UBC-Thunderbots/Electrical/README.md

# Electrical

Our repository for all things electrical! To get started, please see the [getting started document](docs/getting-started/getting-started.md).

If you are already set up, go to the [electrical system overview](docs/getting-started/board-overview.md).
