UBC-Thunderbots/Electrical/electronics/HannahSawiuk-Altium/FinalPCBandGerberfiles/Board Information - chicker.html

Altium customize

# Board Information Report

Date: | | 2018-05-23
Time: | | 10:28:25 PM
Elapsed Time: | | 00:00:00
Filename: | | C:\Users\Hannah\Desktop\Electrical\electronics\HannahSawiuk-Altium\FinalPCBandGerberfiles\chicker.PcbDoc
Units: | | mmmils

## Contents

Contents

Routing

Routing Information

Other

Net Track Width

Net Via Size

## Routing

Routing Information
Routing completion | 88.57%
Connections | 70
Connections routed | 62
Connections remaining | 8

Back to top

## Other

Net Track Width | Count
0.254mm | 18
Total | 18

Back to top

Net Via Size | Count
1.27mm | 18
Total | 18

Back to top
