UBC-Thunderbots/Electrical/controls/kinematics/Oliveira_ICINCO_2008.pdf

See discussions, stats, and author profiles for this publication at: https://www.researchgate.net/publication/256089847

# Dynamical Models for Omni-directional Robots

with 3 and 4 Wheels (https://www.researchgate.net/publication/256089847_Dynamical_Models_for_Omni-directional_Robots_with_3_and_4_Wheels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)

### Conference Paper · May 2008

CITATIONS
0

READS
549

### 4 authors:

### Some of the authors of this publication are also working on these related projects:

(Green) Chemistry and robotics View project (https://www.researchgate.net/project/Green-Chemistry-and-robotics?el=1_x_9)

Helder P. Oliveira (https://www.researchgate.net/profile/Helder_Oliveira3?el=1_x_5)
Institute for Systems and Computer Engineer… (https://www.researchgate.net/institution/Institute_for_Systems_and_Computer_Engineering_of_Porto_INESC_Porto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)

### 55 PUBLICATIONS 178 CITATIONS

SEE PROFILE (https://www.researchgate.net/profile/Helder_Oliveira3?el=1_x_7)

Armando Jorge Sousa (https://www.researchgate.net/profile/Armando_Sousa?el=1_x_5)
University of (https://www.researchgate.net/institution/Institute_for_Systems_and_Computer_Engineering_of_Porto_INESC_Porto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) Porto (https://www.researchgate.net/institution/University_of_Porto?el=1_x_6)

### 41 PUBLICATIONS 93 CITATIONS

SEE PROFILE (https://www.researchgate.net/profile/Armando_Sousa?el=1_x_7)

A. Paulo Moreira (https://www.researchgate.net/profile/A_Moreira?el=1_x_5)
University of Porto (https://www.researchgate.net/institution/University_of_Porto?el=1_x_6)

194 PUBLICATIONS 658 CITATIONS

SEE PROFILE (https://www.researchgate.net/profile/A_Moreira?el=1_x_7)

Paulo José Cerqueira Gomes da Costa (https://www.researchgate.net/profile/Paulo_Costa24?el=1_x_5) University of Porto (https://www.researchgate.net/institution/University_of_Porto?el=1_x_6)

125 PUBLICATIONS 290 CITATIONS

SEE PROFILE (https://www.researchgate.net/profile/Paulo_Costa24?el=1_x_7)

All in-text references underlined in blue are linked to publications on ResearchGate, letting you access and read them immediately.

Available from: Helder P. Oliveira Retrieved on: 05 November 2016

DYNAMICAL MODELS FOR OMNI-DIRECTIONAL ROBOTS WITH

### 3 AND 4 WHEELS

Helder P. Oliveira, Armando J. Sousa, A. Paulo Moreira and Paulo J. Costa ´
Faculdade de Engenharia, Universidade do Porto, Rua Dr. Roberto Frias s/n 4200-465, Porto, Portugal {helder.oliveira, asousa, amoreira, paco}@fe.up.pt
Keywords: | Identification, simulation, modeling and omni-directional mobile robots.
Abstract: | Omni-directional robots are becoming more and more common in recent robotic applications. They offer improved ease of maneuverability and effectiveness at the expense of increased complexity. Frequent appli- cations include but are not limited to robotic competitions and service robotics. The goal of this work is to find a precise dynamical model in order to predict the robot behavior. Models were found for two real world omni-directional robot configurations and their parameters estimated using a prototype that can have 3 or 4 wheels. Simulations and experimental runs are presented in order to validate the presented work.

### 1 INTRODUCTION

Omni-directional robots are becoming a much sought solution to mobile robotic applications. This kind of holonomic robots are interesting because they allow greater maneuverability and efficiency at the expense of some extra complexity. One of the most frequent solutions is to use some of Mecanum wheels (Diegel et al., 2002) and (Salih et al., 2006). (https://www.researchgate.net/publication/26439843_Designing_Omni-Directional_Mobile_Robot_with_Mecanum_Wheel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) A robot with 3 or more motorized wheels of this kind can have almost independent tangential, normal and angular velocities. Dynamical models for this kind of robots are not very common due to the difficulty in modeling the several internal frictions inside the wheels, making the model somewhat specific to the type of wheel being used (Williams et al., 2002). (https://www.researchgate.net/publication/3299237_Dynamic_model_with_slip_for_wheeled_omnidirectional_robots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)
Frequent mechanical configurations for omnidirectional robots are based on three and four wheels. Three wheeled systems are mechanically simpler but robots with four wheels have more acceleration with the same kind of motors. Four wheeled robots are expected to have better effective floor traction, that is, less wheel slippage – assuming that all wheels are pressed against the floor equally. Of course four wheeled robots also have a higher costs in equipment, increased energy consumption and may require some kind of suspension to distribute forces equally among the wheels.
In order to study and compare the models of the 3 and 4 wheeled robots, a single prototype was built that can have both configurations, that is, the same mechanical platform can be used with 3 wheels and then it can be disassembled and reassembled with a 4

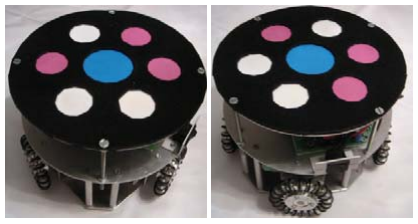
[picture p16: figure]

(a) Three wheeled robot. (b) Four wheeled robot.

Figure 1: Omni-directional robot.

wheel configuration, see figure 1.
Data from experimental runs is taken from overhead camera. The setup is taken from the heritage of the system described in (Costa et al., 2000) (https://www.researchgate.net/publication/220797747_Tracking_and_Identifying_in_Real_Time_the_Robots_of_a_F-180_Team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) that currently features 25 fps, one centimeter accuracy in position(XX and YY axis) and about 3 sexagesimal degrees of accuracy in the heading of the robot.
In order to increase the performance of robots, there were some efforts on the studying their dynamical models (Campion et al., 1996)(Conceic¸ao˜ (https://www.researchgate.net/publication/224663446_Structural_properties_and_classification_of_kinematic_and_dynamic_models_of_wheeled_mobile_robots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) et al., 2006)(Khosla, 1989)( (https://www.researchgate.net/publication/3298012_Categorization_of_Parameters_in_the_Dynamic_Robot_Model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)Tahmasebi et al., 2005)( (https://www.researchgate.net/publication/224619780_Dynamic_parameter_identification_and_analysis_of_a_PHANToM_haptic_device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)Williams et al., 2002) (https://www.researchgate.net/publication/3299237_Dynamic_model_with_slip_for_wheeled_omnidirectional_robots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) and kinematic models (Campion et al., 1996) (https://www.researchgate.net/publication/224663446_Structural_properties_and_classification_of_kinematic_and_dynamic_models_of_wheeled_mobile_robots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) (Leow et al., 2002)(Loh et al., 2003)( (https://www.researchgate.net/publication/4041513_Mechatronics_design_and_kinematic_modelling_of_a_singularityless_omni-directional_wheeled_mobile_robot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)Muir and Neuman, 1987)( (https://www.researchgate.net/publication/3979519_Kinematic_Modeling_for_Feedback_Control_of_an_Omnidirectional_Wheeled_Mobile_Robot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)Xu et al., 2005). (https://www.researchgate.net/publication/4239487_Kinematic_model_identification_of_autonomous_mobile_robot_using_dynamical_recurrent_neural_networks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) Models are based on linear and non linear dynamical systems and the estimation of parameters has been the subject of continuing research (Conceic¸ao et al., ˜ 2006)(Olsen and Petersen, 2001). (https://www.researchgate.net/publication/3299108_A_new_method_for_estimating_parameters_of_a_dynamic_robot_model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) Once the dynamical model is found, its parameters have to be estimated. The most common method for identification

189 of robot parameters are based on the Least Squares method and Instrumental Variables.
However, the systems are naturally non-linear (Julier and Uhlmann, 1997), (https://www.researchgate.net/publication/2445827_A_New_Extension_of_the_Kalman_Filter_to_Nonlinear_Systems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) the estimation of parameters is more complex and the existing methods (Ghaharamani and Roweis, 1999)( (https://www.researchgate.net/publication/2491202_Learning_Nonlinear_Dynamical_Systems_using_an_EM_Algorithm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)Gordon et al., 1993)( (https://www.researchgate.net/publication/3361206_Novel_Approach_to_NonlinearNon-Gaussian_Bayesian_State_Estimation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)Tahmasebi et al., 2005) (https://www.researchgate.net/publication/224619780_Dynamic_parameter_identification_and_analysis_of_a_PHANToM_haptic_device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) have to be adapted to the model’s structure and noise.

### 1.1 Structure

This paper starts by presenting the mechanical prototype and studied mechanical configurations for the 3 and 4 wheeled robots. Finding the dynamical model is discussed and then, an initial approach in estimating model parameters for each robot is done. The need for additional accuracy drives the comparative study on relative importance of the estimated parameters. An additional experiment is done for estimating final numerical values for the configurations of 3 and 4 wheels. Conclusions and future work are also presented.

### 2 MECHANICAL

CONFIGURATIONS

Figures 2 and 3 present the configuration of the three and four wheeled robots respectively, as well as all axis and relevant forces and velocities of the robotic system. The three wheeled system features wheels separated by 120 degrees.

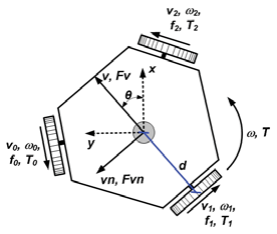
[picture p17: figure]

Figure 2: Three Wheeled Robot.

Figures 2 and 3 show the notation used throughout this paper, detailed as follows:
- x,y,θ - Robot’s position (x,y) and θ angle to the defined front of robot;
- d [m] - Distance between wheels and center robot;
- v0,v1,v2,v3 [m/s] - Wheels linear velocity;
- ω0,ω1,ω2,ω3 [rad/s] - Wheels angular velocity;
- f0, f1, f2, f3 [N] - Wheels traction force;

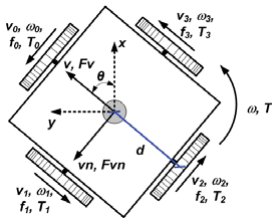
[picture p18: figure]

Figure 3: Four Wheeled Robot.

- T0,T1,T2,T3 [N ·m] - Wheels traction torque;
- v,vn [m/s] - Robot linear velocity;
- ω [rad/s] - Robot angular velocity;
- Fv,Fvn [N] - Robot traction force along v and vn;
- T [N ·m] - Robot torque (respects to ω).

### 3 MODELS

### 3.1 Kinematic

The well known kinematic model of an omnidirectional robot located a (x,y,θ) can be written as vx(t)= dx(t)/dt , vy(t)= dy(t)/dt and ω(t)= dθ(t)/dt (please refer to figures 2 and 3 for notation issues). Equation 1 allows the transformation from linear velocities vx and vy on the static axis to linear velocities v and vn on the robot’s axis.

XR =

⎡

⎣ v(t)
vn(t)
ω(t)

⎤
⎦ ; X0 =

⎡

⎣ vx(t)
vy(t)
ω(t)

⎤
⎦

XR =

⎡

⎣ cos(θ(t))
−sin(θ(t))
0

sin(θ(t))
cos(θ(t))
0

0

0/1⎤
⎦·X0 | (1)

### 3.1.1 Three Wheeled Robot

Wheel speeds v0, v1 and v2 are related with robot’s speeds v, vn and ω as described by equation 2.
⎡
⎣

v0(t)
v1(t)
v2(t)

⎤
⎦ =

⎡
⎣

−sin(π/3)
0
sin(π/3)

cos(π/3)
−1
cos(π/3)

d
d
d

⎤
⎦·

⎡
⎣

v(t)
vn(t)
ω(t)

⎤
⎦ (2)

Applying the inverse kinematics is possible to obtain the equations that determine the robot speeds related the wheels speed. Solving in order of v, vn and ω, the following can be found:
v(t)=(√
3/3)·(v2(t)−v0(t)) | (3)
vn(t)=(1/3)·(v2(t)+v0(t))−(2/3)· v1(t) (4)
ω(t)=(1/(3 · d))·(v0(t)+v1(t)+v2(t)) (5)

ICINCO 2008 - International Conference on Informatics in Control, Automation and Robotics

190

### 3.1.2 Four Wheeled Robot

The relationship between the wheels speed v0, v1, v2 and v3, with the robot speeds v, vn and ω is described by equation 6.
⎡
⎢
⎣

v0(t)
v1(t)
v2(t)
v3(t)

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
v(t)
vn(t)
ω(t)

⎤
⎦ (6)

It is possible to obtain the equations that determine the robot speeds related with wheels speed but the matrix associated with equation 6 is not square. This is because the system is redundant. It can be found that:

v(t)=(1/2)·(v3(t)−v1(t)) | (7)
vn(t)=(1/2)·(v0(t)−v2(t)) | (8)
ω(t)=(v0(t)+v1(t)+v2(t)+v3(t))/(4 · d) (9)

### 3.2 Dynamic

The dynamical equations relative to the accelerations can be described in the following relations:

M ·

dv(t)
dt | = ∑Fv(t)−FBv(t)−FCv(t) | (10)

M ·

dvn(t)
dt = ∑Fvn(t)−FBvn(t)−FCvn(t) (11)

J ·

dω(t)
dt | = ∑T(t)−TBω(t)−TCω(t) | (12)

where the following parameters relate to the robot as follows:
- M [kg] - mass;
- J [kg ·m²] - inertia moment;
- FBv,FBvn [N] - viscous friction forces along v and vn;
- TBω [N · m] - viscous friction torque with respect to the robot’s rotation axis;
- FCv,FCvn [N] - Coulomb frictions forces along v and vn;
- TCω [N · m] - Coulomb friction torque with respect to robot’s rotation axis.
Viscous friction forces are proportional to robot’s speed and as such FBv(t)= Bv · v(t), FBvn(t)= Bvn · vn(t) and TBω(t)= Bω ·ω(t), where Bv,Bvn [N/(m/s)] are the viscous friction coefficients for directions v and vn and Bω [N · m/(rad/s)] is the viscous friction coefficient to ω.
The Coulomb friction forces are constant in amplitude FCv(t)=Cv ·sign(v(t)), FCvn(t)=Cvn ·sign(vn(t)) and TCω(t)= Cω · sign ω(t), where Cv,Cvn [N] are Coulomb friction coefficient for directions v e vn and Cω [N ·m] is the Coulomb friction coefficient for ω.

### 3.2.1 Three Wheeled Robot

The relationship between the traction forces and rotation torque of the robot with the traction forces on the wheels is described by the following equations:
∑Fv(t)=(f2(t)− f0(t))·sin(π/3) | (13)

∑Fvn(t)= −f1(t)+(f2(t)+ f0(t))· cos(π/3)(14)

∑T(t)=(f0(t)+ f1(t)+ f2(t))· d | (15)

The traction force on each wheel is estimated by traction torque, which can be determined using the motor current, as described in the following equations:
f j(t)= Tj(t)/r | (16)
Tj(t)= l ·Kt ·ij(t) | (17)
- l - Gearbox reduction;
- r [m] - Wheel radius;
- Kt [N ·m/A] - Motor torque constant;
- ij [A] - Motor current (j=motor number).

### 3.2.2 Four Wheeled Robot

The relationship between the traction forces and rotation torque of the robot with the traction forces on the wheels, is described by the following equations:
∑Fv(t)= f3(t)− f1(t) | (18)
∑Fvn(t)= f0(t)− f2(t) | (19)
∑T(t)=(f0(t)+ f1(t)+ f2(t)+ f3(t))· d (20)

As above, the traction force in each wheel is estimated using the wheels traction torque, which is determined by the motor current, using equations 16 and 17, where j=0,1,2,3.

### 3.3 Motor

The prototype uses brushless motors for the locomotion of the robot. The model for brushless motors is the similar to the common DC motors, based on (Pillay and Krishnan, 1989).

uj(t)= L ·

dij(t)
dt +R·ij(t)+Kv ·ωmj(t) (21)
Tmj(t)= Kt ·ij(t) | (22)
- L [H] - Motor inductance;
- R [Ω] - Motor resistor;
- Kv [V/(rad/s)] - EMF motor constant;
- uj [V] - Motor voltage (j=motor number);
- ωmj [rad/s] - Motor angular velocity (j=motor number);
- Tmj [N ·m] - Motor torque (j=motor number).

DYNAMICAL MODELS FOR OMNI-DIRECTIONAL ROBOTS WITH 3 AND 4 WHEELS

191

### 4 PARAMETER ESTIMATION

The necessary variables to estimate the model parameters are motor current, robot position and velocity. Currents are measured by the drive electronics, position is measured by using external camera and velocities are estimated from positions.
The parameters that must be identified are the viscous friction coefficients (Bv,Bvn,Bω), the Coulomb friction coefficients (Cv,Cvn,Cω) and inertia moment
J. The robot mass was measured, and it was 1.944 kg for the three wheeled robot and 2.34 kg for the four wheeled robot.

### 4.1 Experience 1 - Steady State Velocity

This method permits to identify the viscous friction coefficients Bω and the Coulomb friction coefficients Cω. The estimation of the coefficient ω was only implemented because inertia moment is unknown, and it is necessary to have an initial estimate of these coefficients. The experimental method relies on applying different voltages to the motors in order to move the robot according his rotation axis - the tests were made for positive velocities. Once reached the steady state, the robot’s speed ω and rotation torque T can be measured. The robot speed is constant, so, the acceleration is null, and as such equation 12 can be re-written as follows:
∑T(t)= Bω ·ω(t)+Cω | (23)

This linear equation shows that it is possible to test different values of rotation speed and rotation torques in multiple experiences and estimate the parameters.

### 4.2 Experience 2 - Null Traction Forces

This method allows for the estimation of the viscous friction coefficients (Bv,Bvn), the Coulomb friction coefficients (Cv,Cvn) and the inertia moment J. The experimental method consists in measuring the robot acceleration and speed when the traction forces were null. The motor connectors were disconnected and with a manual movement starting from a stable position, the robot was pushed through the directions v, vn and rotated according to his rotation axis. During

the subsequent deceleration, velocity and acceleration were measured. Because the traction forces were null during the deceleration equations 10, 11, and 12 can be re-written as follows:
dv(t)
dt = −Bv

M · v(t)− Cv
M | (24)
dvn(t)
dt = −Bvn

M · vn(t)− Cvn
M | (25)
dω(t)
dt = −Bω

J ·ω(t)− Cω
J | (26)

These equations are also a linear relation and estimation of all parameters is possible.

The inertia moment J is estimated using the values obtained previously in section 4.1. To do this, equation 26 must be solved in order of J:
J = − ω(t)
(dω(t)/dt)

·Bω − 1
(dω(t)/dt)

·Cω (27)

### 4.3 DC Motor Parameters

The previous electrical motor model (equation 21) includes an electrical pole and a much slower, dominant mechanical pole - thus making inductance L value negligible. To determinate the relevant parameters Kv and R, a constant voltage is applied to the motor. Under steady state condition, the motor’s current and the robot’s angular velocity are measured. The tests are repeated several times for the same voltage, changing the operation point of the motor, by changing the friction on the motor axis.
In steady state, the inductance L disappears of the equation 21, being rewritten as follows:
uj(t)= R·ij(t)+Kv ·ωmj(t) | (28)
As seen in equation 29, by dividing (28) by ij(t),a linear relation is obtained and thus estimation is pos-
sible. | uj(t)
ij(t) = Kv ·

ωmj(t)
ij(t) +R | (29)

### 5 RESULTS

### 5.1 Robot Model

By combining previously mentioned equations, it is possible to show that model equations can be rearranged into a variation of the state space that can be described as:
(dx(t)/dt)= A· x(t)+B· u(t)+K ·sign(x) (30)
x(t)=[v(t) vn(t) w(t)]T | (31)
This formulation is interesting because it shows exactly which part of the system is non non-linear.

### 5.1.1 Three Wheeled

Using equations on section 3.2, 13 to 17 and 28, the equations for the three wheeled robot model are:

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
⎦ (32)

A11 = − 3 ·K²
t ·l

2
2 ·r² ·R·M − Bv
M
A22 = − 3 ·K²
t ·l

2
2 ·r² ·R·M − Bvn
M
A33 = −3 · d² ·K²
t ·l

2
r² ·R· J − Bw
J

192

B = l ·Kt
r·R ·

⎡
⎣ ⁻

√3/(2 ·M)

1/(2 ·M)
d/J

0
1/M
d/J

√3/(2 ·M)

1/(2 ·M)
d/J

⎤
⎦ (33)

K =

⎡
⎣ ⁻Cv/M
0
0

0
−Cvn/M
0

0
0
−Cw/J

⎤
⎦ (34)

### 5.1.2 Four Wheeled

Using equations on section 3.2 and equations 16 to 20 and 28 we get the following equations to the four wheeled robot model.

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
⎦ (35)

A11 = −2 ·K²
t ·l

2
r² ·R·M − Bv
M
A22 = −2 ·K²
t ·l

2
r² ·R·M − Bvn
M
A33 = −4 · d² ·K²
t ·l

2
r² ·R· J − Bw
J

B = l ·Kt
r·R ·

⎡
⎣

0
1/M
d/J

−1/M
0
d/J

0
−1/M
d/J

1/M
0
d/J

⎤
⎦ (36)

K =

⎡
⎣ ⁻Cv/M
0
0

0
−Cvn/M
0

0
0
−Cw/J

⎤
⎦ (37)

### 5.2 Experimental Data for Robot Model

Experience 1 was conducted using an input signal corresponding to a ramped up step. This way wheel sleeping was avoided, that is, wheel - traction problems don’t exist.
Shown in Figure 4 are the experimental plots regarding the 4 wheeled system. Due to space constraints only T vs. ω and results of the experiment 2 along the v direction are shown.
The motor model was presented earlier in equation 21.
Experimental tests to the four motors were made to estimate the value of resistor R and the constant Kv. The numerical value of the torque constant Kt is identical to the EMF motor constant Kv.
Figure 5 plots experimental runs regarding motor
0. Other motors follow similar behavior.

### 5.3 Numerical Results

Table 1 presents the experimental results to the friction coefficients and inertial moment. From the experimental runs from all 4 motors, the parameters found are Kv = 0.0259 V/(rad/s) and R = 3.7007 Ω .

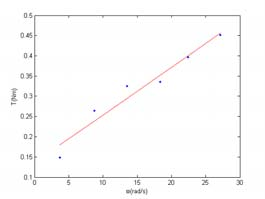
[picture p19: figure]

(a) Experience 1 - T and ω.

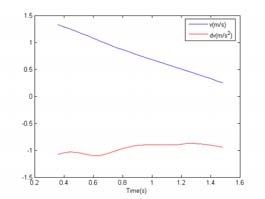
[picture p20: figure]

(b) Experience 2 - Direction v.

Figure 4: Experimental Results for the four wheeled robot.

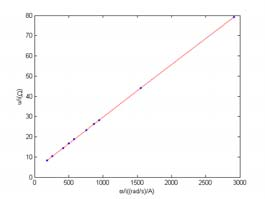
[picture p21: figure]

Figure 5: Experimental tests for motor 0.

Table 1: Friction coefficients and inertia moment.

Parameters | 3 wheels | 4 wheels
J(kg ·m²) | 0.015 | 0.016
Bv(N/(m/s)) | 0.503 | 0.477
Bvn(N/(m/s)) | 0.516 | 0.600
BωN ·m/(rad/s) | 0.011 | 0.011
Cv(N) | 1.906 | 1.873
Cvn(N) | 2.042 | 2.219
Cω(N ·m) | 0.113 | 0.135

### 5.4 Sensitivity Analysis

To understand which model parameters have more influence on the robot’s dynamics, a comparison was made between the matrices of the models.
The model equation 30 is a sum of fractions. Analyzing the contribution of each parcel and of the variable portion within each fraction, a sensitivity analysis is performed, one estimated parameter at a time.

DYNAMICAL MODELS FOR OMNI-DIRECTIONAL ROBOTS WITH 3 AND 4 WHEELS

193

1. Matrix A, robot moving along v direction;
- Three wheeled robot:
3 ·K²
t ·l

2
2 ·r² ·R·M

= Ka1
R | = 3.3110
(Bv/M)= Ka2 ·Bv | = 0.3245
- Four wheeled robot:
2 ·K²
t ·l

2
r² ·R·M

= Ka1
R | = 3.6676
(Bv/M)= Ka2 ·Bv | = 0.2041
2. Matrices B and K, robot moving along v direction with constant voltage motor equal to 6V;
- Three wheeled robot:
√3 ·l ·Kt

2 ·r·R·M

- 12 = Kb
R · 12 = 5.7570

(Cv/M)= Kk ·Cv = 0.8728

- Four wheeled robot:
l ·Kt
r·R·M
- 12 = Kb
R · 12 = 5.5227

(Cv/M)= Kk ·Cv = 0.7879

The same kind of analysis could be taken further by analyzing other velocities (vn and ω). Conclusions reaffirm that motor parameters have more influence in the dynamics than friction coefficients. This means that it is very important to have an accurate estimation of the motor parameters. Some additional experiences were designed to improve accuracy. The method used previously does not offer sufficient accuracy to the estimation of R. This parameter R is not a physical parameter and includes a portion of the non-linearity of the H bridge powering the circuit that, in turn, feeds 3 rapidly switching phases of the brushless motors used. In conclusion, additional accuracy in estimating R is needed.

### 5.5 Experience3-Parameter

Estimation Improvement

The parameter improving experience was made using a step voltage with an initial acceleration ramp.
As seen in 5.1 the model was defined by the equation 30 and we can improve the quality of the estimation by using the Least Squares method. The system model equation can be rewritten as:
y = θ1 · x1 +θ2 · x2 +θ3 · x3 | (38)

Where x1 = x(t), x2 = u(t), x3 = 1 and y = dx(t)/dt. The parameters θ are estimated using:

θ =

xT · x

−1
- xT · y | (39)
x =[x1(1)...x1(n) x2(1)...x2(n) x3(1)...x3(n)]T | (40)

Estimated parameters can be skewed and for this reason instrumental variables are used to minimize the error, with vector of states defined as
z =[x1(1)...x1(n) x2(1)...x2(n) x3(1)...x3(n)]T (41) The parameters θ are now calculated by:

θ =

z

T · x

−1
·z
T · y | (42)

Three experiments were made for each configuration of 3 and 4 wheels, along v, vn and ω. For the v and vn experiments values Cv and Cvn are kept from previous analysis. For the ω experiment, the value of the R parameter used is the already improved version from previous v and vn experimental runs of the current section.
The numerical value of R for each motor was estimated for each motor and then averaged to find R=4.3111 Ω. The results are present on followings tables. Table 2 shows values estimated by the experiment mentioned in this section.

Table 2: Parameters estimated using the method 3.

Parameters | 3 wheels | 4 wheels
J(kg ·m²) | 0.0187 | 0.0288
Bv(N/(m/s)) | 0.5134 | 0.5181
Bvn(N/(m/s)) | 0.4571 | 0.7518
BωN ·m/(rad/s) | 0.0150 | 0.0165
Cω(N ·m) | 0.0812 | 0.1411

The final values for friction and inertial coefficients are averaged with results from all 3 experimental methods and the numerical values found are presented in Table 3.

Table 3: Parameters of dynamical models.

Parameters | 3 wheels | 4 wheels
d(m) | 0.089
r (m) | 0.0325
l | 5
Kv (V/(rad/s)) | 0.0259
R (Ω) | 4.3111
M(kg) | 1.944 | 2.34
J (kg ·m²) | 0.0169 | 0.0228
Bv (N/(m/s)) | 0.5082 | 0.4978
Bvn (N/(m/s)) | 0.4870 | 0.6763
Bω (N ·m/(rad/s)) | 0.0130 | 0.0141
Cv (N) | 1.9068 | 1.8738
Cvn (N) | 2.0423 | 2.2198
Cω (N ·m) | 0.0971 | 0.1385

### 5.6 Model Validation Experiences

The models were validated with experimental tests on using a step voltage with an initial acceleration ramp.

194

Due to space constraints in this document, figures 6 to 9 show plots for some of the runs only. Other runs confirm the global validity of the model as simulation follows reality closely.

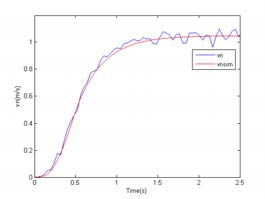
[picture p22: figure]

Figure 6: 3 wheel model validation - velocity along vn.

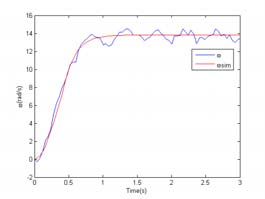
[picture p23: figure]

Figure 7: 3 wheel model validation - angular velocity ω.

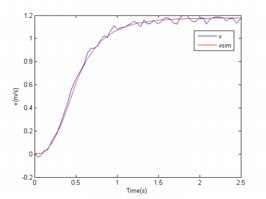
[picture p24: figure]

Figure 8: 4 wheel model validation - velocity along v.

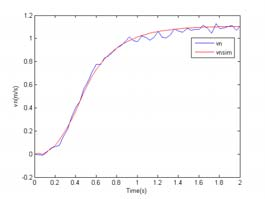
[picture p25: figure]

Figure 9: 4 wheel model validation - velocity along vn.

### 6 CONCLUSIONS

This paper presents models for mobile omnidirectional robots with 3 and 4 wheels. The derived model is non-linear but maintains some similarities with linear state space equations. Friction coefficients are most likely dependent on robot and wheels construction and also on the weight of the robot. The model is derived assuming no wheel slip as in most standard robotic applications.
A prototype that can have either 3 or 4 omnidirectional wheels was used to validate the presented model. The test ground is smooth and carpeted. Experience data was gathered by overhead camera capable of determining position and orientation of the robot with good accuracy.
Experiences were made to estimate the parameters of the model for the prototypes. The accuracy of the presented model is discussed and the need for additional experiences is proved. The initial estimation method used two experiences to find all parameters but a third experience is needed to improve the accuracy of the most important model parameters. Sensitivity analysis shows that the most important model parameters concern motor constants.
Observing estimated model parameters, the four wheel robot has higher friction coefficients in the vn direction when compared to the v direction. This means of course higher maximum speed for movement along v axis and higher power consumption for movements along the vn direction. This difference in performance points to the need of mechanical suspension to even wheel pressure on the ground.
The found model was shown to be adequate for the prototypes in the several shown experimental runs.

### 7 FUTURE WORK

The work presented is part of a larger study. Future work will include further tests with different prototypes including prototypes with suspension. The model can also be enlarged to include the limits for slippage and movement with controlled slip for the purpose of studying traction problems. Dynamical models estimated in this work can be used to study the limitations of the mechanical configuration and allow for future enhancements both at controller and mechanical configuration level. This study will enable effective full comparison of 3 and 4 wheeled systems.

DYNAMICAL MODELS FOR OMNI-DIRECTIONAL ROBOTS WITH 3 AND 4 WHEELS

195

REFERENCES

Campion, G., Bastin, G., and Dandrea-Novel, B. (1996). Structural properties and classification of kinematic and dynamic models of wheeled mobile robots. IEEE Transactions on Robotics and Automation, 12(1):47–
62. 1042-296X. (https://www.researchgate.net/publication/224663446_Structural_properties_and_classification_of_kinematic_and_dynamic_models_of_wheeled_mobile_robots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)
Conceic¸ao, A. S., Moreira, A. P., and Costa, P. J. ˜ (2006). Model identification of a four wheeled omnidirectional mobile robot. In Controlo 2006, 7th Portuguese Conference on Automatic Control, Instituto Superior Tecnico, Lisboa, Portugal. ´
Costa, P., Marques, P., Moreira, A. P., Sousa, A., and Costa,
P. (2000). Tracking and identifying in real time the robots of a f-180 team. In Manuela Veloso, Enrico Pagello and Hiroaki Kitano, Robocup-99: Robot Soccer World Cup III. Springer, LNAI, pages 289–291. (https://www.researchgate.net/publication/220797747_Tracking_and_Identifying_in_Real_Time_the_Robots_of_a_F-180_Team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) Diegel, O., Badve, A., Bright, G., Potgieter, and Tlale, S. (2002). Improved mecanum wheel design for omnidirectional robots. In Proc. 2002 Australasian Conference on Robotics and Automation, Auckland. Ghaharamani, Z. and Roweis, S. T. (1999). Learning nonlinear dynamical systems using an em algorithm. In
M. S. Kearns, S. A. Solla, D. A. Cohn, (eds) Advances in Neural Information Processing Systems. Cambridge, MA: MIT Press, 11. (https://www.researchgate.net/publication/2491202_Learning_Nonlinear_Dynamical_Systems_using_an_EM_Algorithm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)
Gordon, N. J., Salmond, D. J., and Smith, A. F. M. (1993). Novel approach to nonlinear/non-gaussian bayesian state estimation. IEE Proceedings-F on Radar and Signal Processing,, 140(2):107–113. 0956-375X. (https://www.researchgate.net/publication/3361206_Novel_Approach_to_NonlinearNon-Gaussian_Bayesian_State_Estimation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) Julier, S. J. and Uhlmann, J. K. (1997). A new extension of the kalman filter to nonlinear systems. Int. Symp. (https://www.researchgate.net/publication/2445827_A_New_Extension_of_the_Kalman_Filter_to_Nonlinear_Systems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) Aerospace/Defense Sensing, Simul. and Controls, Orlando, FL.
Khosla, P. K. (1989). Categorization of parameters in the dynamic robot model. IEEE Transactions on Robotics and Automation, 5(3):261–268. 1042-296X. (https://www.researchgate.net/publication/3298012_Categorization_of_Parameters_in_the_Dynamic_Robot_Model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)
Leow, Y. P., H., L. K., and K., L. W. (2002). Kinematic modelling and analysis of mobile robots with omnidirectional wheels. In Seventh lnternational Conference on Control, Automation, Robotics And Vision (lCARCV’O2), Singapore.
Loh, W. K., Low, K. H., and Leow, Y. P. (2003). Mechatronics design and kinematic modelling of a singularityless omni-directional wheeled mobile robot. In Robotics and Automation, 2003. Proceedings. ICRA ’03. IEEE International Conference on, volume 3, pages 3237–3242. (https://www.researchgate.net/publication/4041513_Mechatronics_design_and_kinematic_modelling_of_a_singularityless_omni-directional_wheeled_mobile_robot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)
Muir, P. and Neuman, C. (1987). Kinematic modeling for feedback control of an omnidirectional wheeled mobile robot. In Proceedings 1987 IEEE International Conference on Robotics and Automation, volume 4, pages 1772–1778. (https://www.researchgate.net/publication/3979519_Kinematic_Modeling_for_Feedback_Control_of_an_Omnidirectional_Wheeled_Mobile_Robot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)
Olsen, M. M. and Petersen, H. G. (2001). A new method for estimating parameters of a dynamic robot model. IEEE Transactions on Robotics and Automation, 17(1):95–100. 1042-296X. (https://www.researchgate.net/publication/3299108_A_new_method_for_estimating_parameters_of_a_dynamic_robot_model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)
Pillay, P. and Krishnan, R. (1989). Modeling, simulation, and analysis of permanent-magnet motor drives, part

11: The brushless dc motor drive. IEEE transactions on Industry applications, 25(2):274–279. (https://www.researchgate.net/publication/3168858_Modeling_simulation_and_analysis_of_permanent-magnet_motor_drives_II_The_brushless_DC_motor_drive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)
Salih, J., Rizon, M., Yaacob, S., Adom, A., and Mamat,
M. (2006). Designing omni-directional mobile robot with mecanum wheel. American Journal of Applied Sciences, 3(5):1831–1835. (https://www.researchgate.net/publication/26439843_Designing_Omni-Directional_Mobile_Robot_with_Mecanum_Wheel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)
Tahmasebi, A. M., Taati, B., Mobasser, F., and Hashtrudi-Zaad, K. (2005). Dynamic parameter identification and analysis of a phantom haptic device. In Proceedings of 2005 IEEE Conference on Control Applications, pages 1251–1256. (https://www.researchgate.net/publication/224619780_Dynamic_parameter_identification_and_analysis_of_a_PHANToM_haptic_device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)
Williams, R. L., I., Carter, B. E., Gallina, P., and Rosati, G. (2002). Dynamic model with slip for wheeled omnidirectional robots. IEEE Transactions on Robotics and Automation, 18(3):285–293. 1042-296X. (https://www.researchgate.net/publication/3299237_Dynamic_model_with_slip_for_wheeled_omnidirectional_robots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)
Xu, J., Zhang, M., and Zhang, J. (2005). Kinematic model identification of autonomous mobile robot using dynamical recurrent neural networks. In 2005 IEEE International Conference Mechatronics and Automation, volume 3, pages 1447–1450. (https://www.researchgate.net/publication/4239487_Kinematic_model_identification_of_autonomous_mobile_robot_using_dynamical_recurrent_neural_networks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)

196
