UBC-Thunderbots/Electrical/controls/kinematics/MRL_kinematics.pdf

Abstract—Path planning together with the tuning and determination of controller parameters are major concerns in omnidirectional mobile robots. Defining appropriate controller parameters in acceleration and deceleration to reach far and near target points without slippage is one of critical issues since some troubles due to unregulated velocities may greatly affect the ability of robot for the specified path planning and attaining the mentioned targets. A robot accurate kinematic and dynamic modeling and simulation accompanied by velocity and acceleration filtering are mainly discussed in this paper. Major changes and improvements in motion analysis, simulation and accuracy for the newly presented model and its efficiency are discussed in comparison with the previous simple kinematic modeling. Employing the new approach for robot dynamic modeling, particularly acceleration filtering, results in to the more precise robot control and achieving appropriate results.

I. INTRODUCTION
mni-directional mobile robots have the ability to move concurrently and independently in rotation and movement in the plane. Kinematic and dynamic equations besides reliable controller are the main approach in many researches on these robots, but there is a significant drawback with some traditional controllers for localization when the distance to target has a wide variety and surface condition changes. An accurate trajectory tracking control which falls into two different duties, path planning and trajectory following, is the key part for various applications of omnidirectional robots [1, 2, 3]. Omni-directional mobile robots are widely studied for dynamic environmental applications because of their swiftness and reasonable accuracy for diverse in-plane maneuvers and trajectory following [3-6]. The trajectory control is basically performed by first building a geometric path and then by using feedback control to track the path. For rapidly evolving environments, the dynamic abilities of the mobile robots shall be considered and implemented [1]. In [1, 7, 8], kinematic and dynamic models of omnidirectional mobile

Manuscript received August 31, 2009. This work was supported in part by the Mechatronics Research Laboratory, MRL, Qazvin Islamic Azad University.
Ehsan Hashemi is with the Department of Mechanical and Industrial Engineering and Mechatronics Research laboratory, MRL, Qazvin Islamic Azad University, 34185-1416, Qazvin (corresponding author, phone: +98-281-3675780; fax: +98-281-3675780; e-mail: e.hashemi@qazviniau.ac.ir). Maani Ghaffari Jadidi and Omid Bakhshandeh Babarsad are students of the Department of Mechanical and Industrial Engineering and Department of Electrical and Computer Engineering respectively and researcher in the Mechatronics Research laboratory, MRL, Qazvin Islamic Azad University (e-mails: m.ghaffari@mrl.ir, omidbakhshandeh@gmail.com).

robots are presented properly and the robot dynamic model is simplified as a linear system. This modeling contains dynamic behavior of drivers, but the nonlinear coupling between the rotational and translational maneuvers has not been analyzed. In [1, 9, 7], control strategies and optimal path planning have been developed for position control without consideration of orientation control, and the designed controller was tested in simulations and experiment. Two independent PID controllers are designed for controlling position and orientation separately in [8] based on the simplified linear model. A nonlinear dynamic model including the nonlinear coupling terms was introduced in [10-13]. In [12], based on the same model in [11], PID, self tuning PID, and fuzzy control of omnidirectional mobile robots have been studied. A newly developed and experienced method for filtering velocities and robot dynamic model simulation together with the main drawbacks of previous model are illustrated in the presented paper.
TABLE I
NOMENCLATURE
Symbol | Quantity | SI
B | geometrical matrix | --
mc | coefficient of damping of the
| driver | [N.s/m]
L c | coefficient of damping of the
| wheel | [N.s/m]
E | drivers voltage matrix,
| [E1 E2 E3 E4]
| T | [V]
EM | driver’s back EMF | 1/285 V/rpm
Ft
| traction force matrix
| [ƒ1 ƒ2 ƒ3 ƒ4] | [N]
Fm
| force and moment on the robot
| in the moving frame [Fmx Fmy Tz] | [N], [N. m]
Fg
| force and moment on the robot
| in global coordinates [Fx Fy Tz] | [N], [N. m]
L J | wheel’s inertia | 2.158e-5 Kg.m²
m J | driver’s rotor inertia | 1.35e-5 Kg.m²
J | robot’s inertia | 0.013 Kg.m²
mk | driver’s torque constant | 33.5 mN. m/A
l | wheel base | 0.0824 m
m | robot's mass | 3.678 Kg
n | gears ratio | 4.091
R | driver’s terminal resistance
| phase to phase | 0.978 Ω

R

g
m | Rotation matrix | --
r | wheel radius | 0.0285 m
Tz
| Applied moment on the robot
| about vertical axis | [N.m]
X m | local position matrix, [xm ym φ]
T | [m]

## Trajectory Planning Optimization with Dynamic Modeling of Four Wheeled Omni-Directional Mobile Robots

Ehsan Hashemi, Maani Ghaffari Jadidi, Omid Bakhshandeh Babarsad

O

Xg

global position matrix,
[xg yg φ]
| T | [m]
Xg

& , X m

& | global and Local velocity | [m/s]
Xg && , X m && | global and Local acceleration | [m/s²
| | ]
φ
& | Angular velocity of the robot | [rad/s]
θ | angle of wheels respect to local
| coordinates | [Degree]
m τ | drivers torque matrix,
| [τm1 τm2 τm3 τm4]
| T | [N. m]
ω m
| angular velocity matrix of the
| drivers, [ωm1 ωm2 ωm3 ωm4]
| T | [rad/s]
ωm& | angular acceleration matrix of
| the drivers | [rad/s² ]
ωL
| Angular velocity matrix of the
| wheels, [ωL1 ωL2 ωL3 ωL4]
| T | [rad/s]
ωL & | Angular acceleration matrix of
| the wheels | [rad/s² ]

II. MOTION CONTROL AND ROBOT MODEL
Several works have been performed to develop a procedure for tuning systems and selecting the suitable feedback [14], [15]. The right sequence of local actions for the robot will be recognized using an appropriate path planning which employs all available overall data in non real time. The presented model and dynamic simulation together with the experimental results are focused on a four-wheeled omni-directional robot of MRL RoboCup SSL team which is electrically actuated with four 50 Watts Maxon brushless motors equipped with mechanically driven shaft encoder as shown in figure 1-b. The input signals to the motors are four PWM voltages and the main purpose is to control the robot position and its orientation. In this section, the robot model equations are presented and developed in two parts.
In the first part, kinematic equations of the robot and in the second part dynamic equations based on some typical simplifying assumptions are derived. Many environmental influencing factors have not been considered in the previous model due to complexity. As an instance, the wheels might slip on the floor while floor characteristics had not been completely considered in the motion equations of the earlier model. These drawbacks are removed in the lately developed model with the main aim of drivers torque control. As it is assumed in [3], the wheels have no slippage in the direction of traction force. Only viscous friction forces on the motor shaft and gear are considered. The wheel contact friction forces that are not in the direction of traction force and the motor electrical time constant are neglected in the previous models, but considering the mentioned parameters leads to acceptable results comparing with experimental data. It is shown here that filtering of velocity and acceleration compensate the friction changes and the robot has less slippage. There are two coordinate frames used in the modeling: the body frame which is shown as subscript m and the global frame shown by subscript g . The body frame is fixed on the moving robot with the origin on the robot's geometric center assumed to be the center of gravity, as depicted in figure 1-a. The global frame is also fixed on the field of play. Proposed simulation is developed by MATLAB Simulink and Runge-Kutta 4 is selected as the proper method to solve the robot EOM. The simulated model behaves very similar to the real robot in sensible input range as will be discussed in section V. Implementing the angular velocity obtained by encoder outputs and designing a PID controller via Ziegler-Nichols tuning method lead to a desirable motor velocity control. Although noise, saturation and dead zone make some perturbation in velocity control, robustness of designed PID controller compensates most of them.
A. Kinematic Modeling
A reference-tracking objective and making the output follow the reference or set point are satisfied with standard block diagram. Kinematic equations and relations between robot velocity and various geometry specifications are expressed in the following section. Robot position and orientation shown in figure 1-b in moving and global coordinates are:
[ | ]
⎪ | [ | ] ⎩

⎪
⎨

⎧
=
= | T
g | g | g

T
m | m | m
X | x | y
X | x | y
φ
φ | (1)

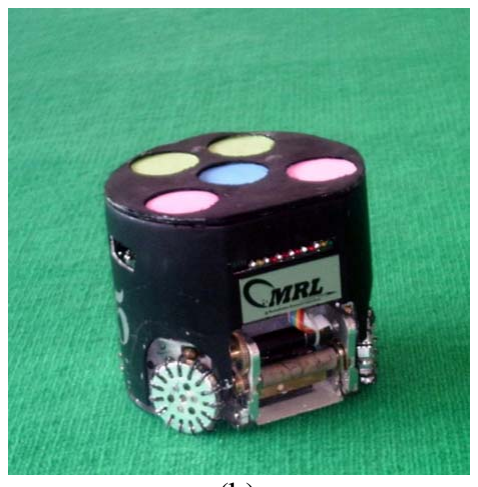
[picture p26: figure]
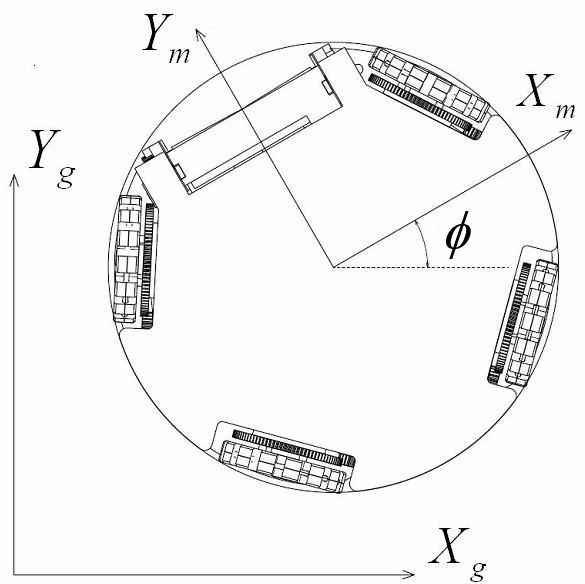
[picture p27: figure]

(a) (b)
Fig. 1. (a) Local and Global coordinates; (b) MRL SSL robot for RoboCup 2009
Rotation matrix R

g
m used to change the coordinates from moving to global is expressed as:

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
0 | 0 | 1
sin | cos | 0
cos | sin | 0
φ | φ
φ | φ
R

g
m | (2)

After taking time derivative of the robot position, velocity vector in the global coordinates is obtained as shown in equation (3). Velocity vector which related to the wheel geometry and angular velocity in the global coordinates as:
( ) L
g T
m m

g

g m X | RX | R B | rω ⁻¹ & = & = | (3)

In which Geometrical matrix B is:

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
⎡− | − | − | −
=
l | l | l | l
B | 1 | 2 | 3 | 4
1 | 2 | 3 | 4
cos | cos | cos | cos
sin | sin | sin | sin
| θ | θ | θ | θ
| θ | θ | θ | θ
(4)

Robot acceleration vector is mathematically described as equation (5) with taking time derivative of equation (3):

() | () L
g | T
L m
g | T
g m X | R B | rω R B | rω& && | & | −1 | −1
= | + | (5)
Angular velocity matrix components, robot geometry and gear ratio are used in calculation of the robot's angular velocity.
B. Dynamic Modeling
The nonlinearities, like motor dynamic constraints or friction related to the robot’s velocity, can greatly affect the robot's behavior, especially when it is accelerated and decelerated [16]. The most important purpose of the following equations is developing relations between driver's torque and actuating voltage, angular velocity and angular acceleration to describe the robot's dynamic behavior. Applied force matrix in the local coordinates and traction force matrix are related as follow:
Fm = BFt | (6)
Traction force matrix for a 4-wheel omnidirectional robot is:
[ | ]T
t F | f f f f = 1 | 2 | 3 | 4 | (7)
In which i f is the traction force values of wheels. Applied forces and moment matrix could be described as:
[ | ]T Fm = Fmx | Fmy | Tz | (8)

Robot traction force is calculated from equation (10) which represents the dynamic equation:
[ | ] () | () | T

L

g | T
L | m
g | T
m
g | T
t | m F | B | R m R B | rω R B | rω& & | 1 | 1 1 | − | − − = | + | (9)
The required torque of the driver concerning all loads and motors rotational inertias is:
()
() m
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
m | m
B | R m R B n

r I n

c c

B R m R B n

r I n

J J

ω

τ | ω
| ⎥ ⎦

⎤ ⎢
⎣
⎡ | ⎟ | +
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
⎡ | ⎟ | +
| ⎠

⎞ ⎜
⎝

⎛ = +

− −
×

− −
×

1 1
2

2

2 4 4

1 1
2

2

2 4 4

&

&
(10)

Equation (10) could be simplified as the following equation in which Z and V matrix elements are listed in Appendix I.
m | Zω m | Vω m τ = & + | (11)
Z and V matrices are shown in equations (13) and (14)

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
4 | 3 | 6 | 5
3 | 4 | 5 | 6
2 | 1 | 4 | 3
1 | 2 | 3 | 4
k | k k k

k k k k

k | k k | k
k k | k k
Z | (12)

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
− | −
− | −

−

=

10 | 9 | 11 | 7
9 | 10 | 7 | 11
8 | 7 | 10 | 9
7 | 8 | 9 | 10
k | k | k | k
k | k | k | k
k | k | k | k
k | k | k | k

V

φ | φ | φ
φ | φ | φ
φ | φ | φ
φ | φ | φ
& | & | &
& | & | &
& | & | &
& | & | &

(13)

Driver's dynamic behavior considering its actuating voltage, back EMF, terminal resistance, and the motor torque constant is also demanded for next stages to simulate the torque control method. It is written as:
( | ) R
k E EM | m
m | ω m τ = | − | . | (14)

Combining equation (11) with equation (14) results into the coupled nonlinear motion equation of four-wheeled omnidirectional mobile robots with the following expression:

m
m

m
m

V EM I
k

R Z
k
R E | ω | ω⎟
⎟
⎠

⎞
⎜

⎜
⎝

⎛
+ + ⎟

⎟
⎠

⎞
⎜

⎜
⎝
⎛ = | 4×4 & | . | (15)

Equation (15) relates driver specifications and robot's dynamic characteristics, thus plays an essential role for simulation.

III. Velocity and Acceleration Filtering Effective checking of specified maneuver velocity and acceleration by velocity and acceleration filtering is required to reach a precise path planning algorithm as it is approved by experimental results. This filtering will be done after extracting maximum velocity and acceleration from related curves as described here. Dynamic model with considering all physical parameters and ground conditions are used for presenting a relatively useful slip-free model. This model is executed for so called velocity and acceleration cone method [13], and then the maximum accessible velocity and acceleration are extracted. The main advantage of this method is that ground physical conditions such as friction factor and robot's physical parameters could easily change and modified. Therefore, tunings are simply performed with the new conditions.
A. Velocity Filtering
As described in literatures [13] for three-wheel robots, the robot speed at any point on the path is within its speed limitation corresponding to the rotational speed. It is also concluded that the robot acceleration at any point on the path is within its acceleration constraint corresponding to the robot rotational acceleration. Therefore, Vmax and φ max

& are

calculated implementing the so called velocity cone method, kinematic, and dynamic constraints of omni-directional mobile robots. The novel proposed filtering method in this paper is generated for four-wheel robots with normalizing the velocity components. Vinput which is calculated by the game strategy controller and artificial intelligence sections for reaching specified targets and moving through various paths, is compared by the estimated Vmax . If the estimated value for maximum speed is greater than the input desired velocity, all horizontal and vertical components of desired velocity could be executed for the next steps and filtered value of robot's rotational velocity, φ f

& is calculated with the

components of desired velocity. For this condition if the desired robot rotational velocity, φinput

& is smaller thanφ f

& ,

φinput

& is employed for the next calculations. φ f

& will be used if the desired rotational velocity has the larger value than the filtered one. In contrast, if the estimated value for maximum speed is smaller than the input desired velocity, filtering should be performed using normalizing the desired velocity and multiplying by the maximum one which results into a new linear velocity. Equation (16) represents relation between the maximum linear and angular velocities as extracted from the velocity cone method for the particular robot's model.

44.217
3.159

44.217 ⎟ = ⎠

⎞ ⎜
⎝
⎛ φ m + | Vm & | (16)

Practical simulated maximum linear and angular velocity obtained by method mentioned above are

s V | 3.159 m max = | and | s rad φ max = 44.217 &
B. Acceleration Filtering
Restricting the maximum acceleration assigned to the motion can reduce the slippage as expressed in [13]. The same method for determining the maximum permissible linear and rotational velocity and its filtering is employed to generate a relatively slip free motion with the filtered acceleration in different maneuvers, but the main parameters are amax and ainput in the calculation described in the previous section. Maximum acceleration approximated modified by dynamic limitations and robot parameters is
max | 826 | 2 0. | s a | = | m | The maximum acceleration is achieved by

friction coefficient about 0.19 and it could be different in diverse fields and robot’s maneuver.

IV. Path Planning and AI
Various mobile robots are equipped with Rapidly Random Tree planner, RRT, for suitable obstacle avoidance and swift motion to attain specified targets. Extend, Distance, and Random State are the main functions of the RRT planner.

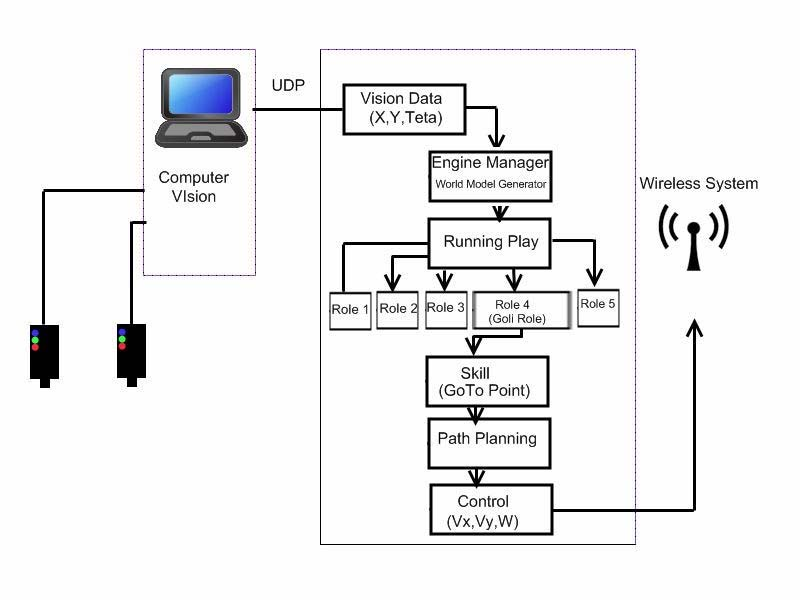
[picture p28: figure]

Fig. 2. MRL AI sections and relations for velocity control
New states that could be reached from the target are calculated by Extend function utilizing specified distance parameters. If a collision with an obstacle occurs during moving to that new state in the environment, a default value, Empty state, will be returned which represents the collision.

Next Distance between the current and the goal state is measured by Distance function to find out if the current state is near enough to the Goal. Random State also returns a new random location.
Localization is utilized by a machine vision package and communication with the AI section. AI machine in cooperation with the developed software to control robots are shown in figure 2 which performs by bidirectional wireless connection in 73 packets per second for each robot.
V. Results and Discussion
The proposed filtering method was utilized in four-wheeled omni-directional SSL robot and simulation results for horizontal and vertical movements are graphically illustrated in figures 3-a and 3-b. This compares new approach open and closed loop simulation with the desired path decided by the path planning section of the model. These paths show responses of dynamically simulated model in the horizontal and vertical maneuvers which predicts an error with maximum value about 29% and 21% for the first sharp edge in horizontal and vertical movement respectively with the open loop, OL simulator. These values changed to 4.3% and 6.2% for the closed loop regulated PID controller, CL. These curves are predicted by the maximum attainable velocity with a slip-free motion in the simulator which is 3.159 m/s.

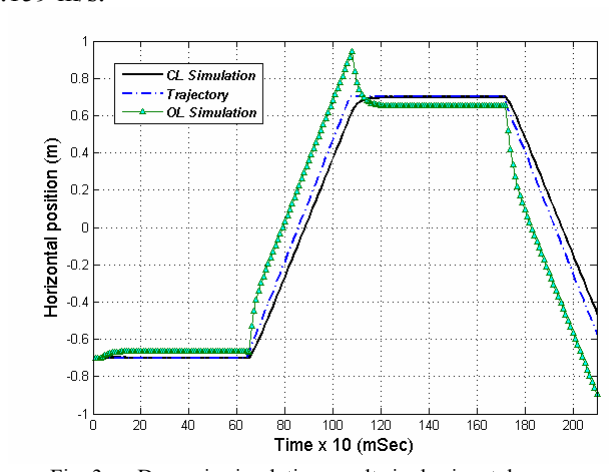
[picture p29: figure]

Fig. 3-a. Dynamic simulation results in horizontal maneuvers

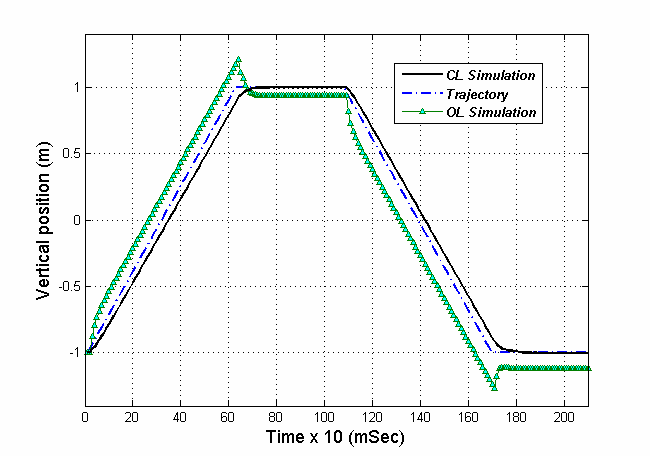
[picture p30: figure]

Fig. 3-b. Dynamic simulation results in vertical maneuvers
Robot’s angular velocity is controlled and modified by the mentioned model which leads to different values in assessment with the traditional PID controllers. Results are evaluated with the desired increase of angular velocity with the ramp shape for both the OL and CL controllers in figure
4. This increase in angular velocity is considered in the rectangular path maneuvers as requested by the path planner. In figure 5 similar circular paths are assigned to the conventional controller without the dynamic simulation and the novel one.

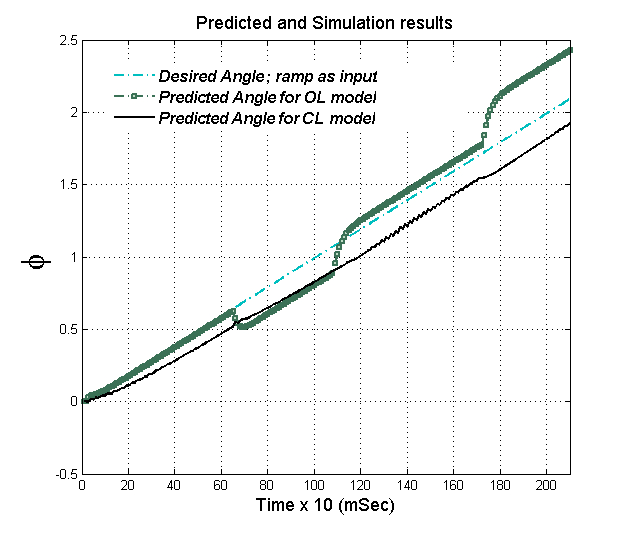
[picture p31: figure]

Fig. 4. Simulator prediction for robot's ramp-shaped rotation

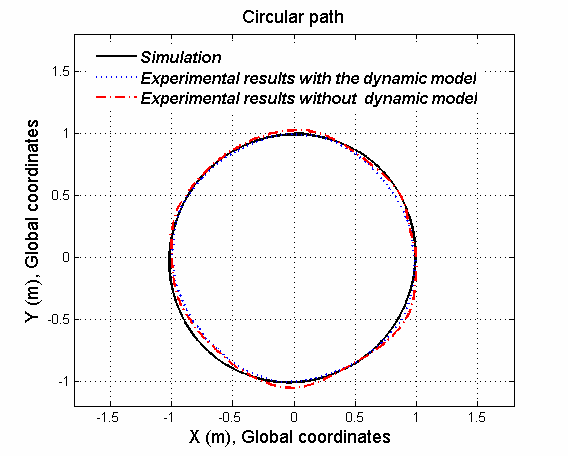
[picture p32: figure]

Fig. 5. Simulator prediction and experimental results for both system with and without the newly proposed model

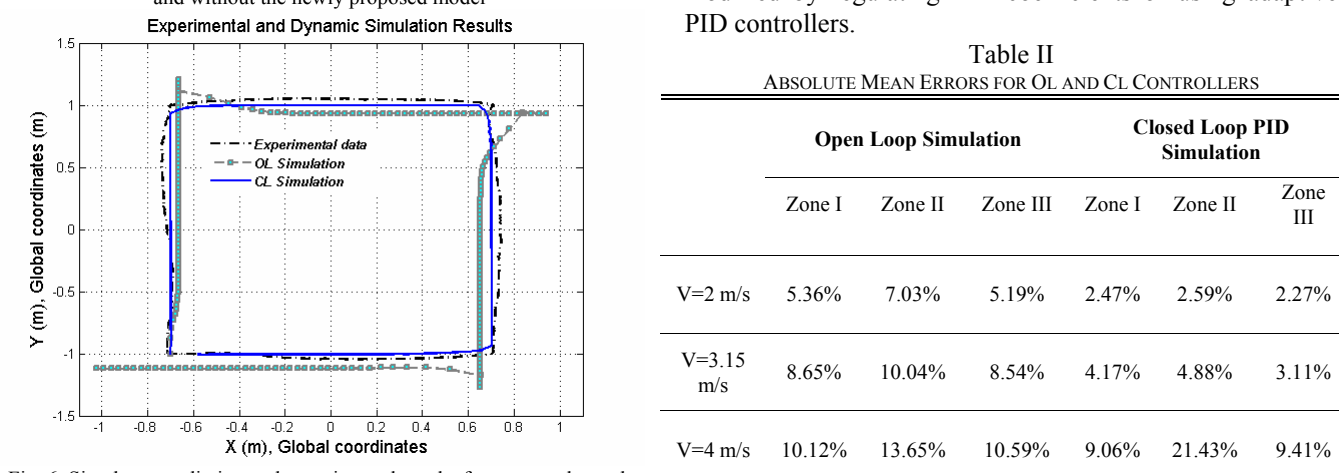
[picture p33: figure]
PID controllers.; Table II; Closed Loop PID Simulation Open Loop Simulation; Zone; III Zone I; Zone II; Zone III; Zone I

Fig. 6. Simulator prediction and experimental results for rectangular path

This difference is one of the most significant characteristics required in the soccer robot’s motion.
Rectangular trajectory desired for the 4-wheeled omnidirectional mobile robot by the maximum slip-free velocity is compared with the simulator predicted path which results into the maximum errors 8.1% for vertical and 3.7% for horizontal position in the CL model. Experimental and the presented simulation data accomplished by the new model are graphically compared in figure 6. Comprehensive evaluation of the system on which the modified PID controller and the conventional controller are installed is shown in figure 7.

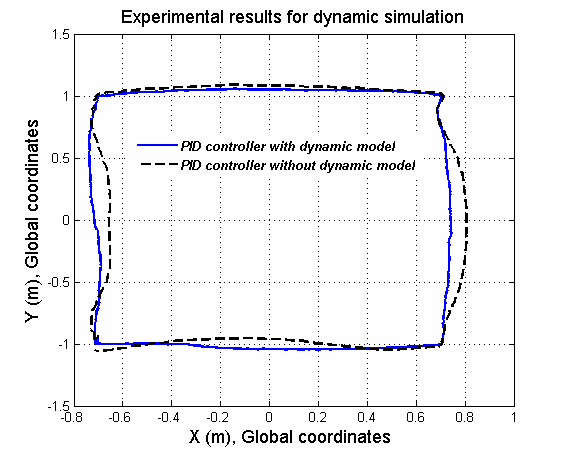
[picture p34: figure]

Fig. 7. Experimental data for both the conventional and new controllers
Absolute mean errors for three zones are tabulated and compared for OL and CL simulation with the rectangular trajectory in the global coordinates as Table II. The error values are in percent for speeds lower and higher than and equal to the maximum attainable speed without slip. Zone I is defined for x=0.7m and vertical movement of robot between -1m and 0.58m. Zone II consists of the first perpendicular corner of trajectory with x position between -0.7m and -0.34m and y position between 0.58m and 1m. Zone III is classified as the horizontal path after the corner with y=1m and 0.34m<x<0.7m. All CL results are more practical and better than the OL predicted errors except one value which is for V=4m/s and around the first right angle corner which is due to the higher velocity and could be modified by regulating PID coefficients or using adaptive

ABSOLUTE MEAN ERRORS FOR OL AND CL CONTROLLERS

VI. CONCLUSION
Introducing velocity and acceleration filters which enables the controller to exactly control the input current and voltage of drivers to prevent slip, will improve the efficiency while experimental results approve this issue too. Robot’s angular velocity increase during the rectangular trajectory shows a smooth shift around perpendicular edges in CL model and results in to a maximum 13.2% error from the preferred value while OL simulation predicts maximum 19.5% error. As it is concluded from the simulated curves for the rectangular trajectory and the highest achievable slip-free speed, the maximum horizontal position error in vertical paths for the modified PID controller is about 6.7% and 5.3% for OL and CL model respectively, but this error for the conventional controller is about 13.8% which shows a reasonable method with good accuracy. All above mentioned errors are maximum errors and the absolute mean ones are lower as they are listed in table II. In addition, fluctuations for the simple controller are more around the sharp edges and changing direction maneuvers. The greatest vertical position errors in horizontal movement are 8.2 % and 5.1 % for the traditional and the proposed model correspondingly. Mass transformation in acceleration and deceleration maneuvers is not considered in this paper, but practical results show acceptable approximation. This transformation and its effect on path planning are authors' next approaches and research subjects for omni-directional robots motion analysis. Adaptation of the maximum acceleration to filter acceleration in the fields with variable coefficients of friction especially in diverse directions and areas is the authors' next research topics.

APPENDIX
Z and V matrix elements shown in equation (12) and
(13) are mathematically described as bellow. These parameters introduce relationship among various dynamic characteristics of the robot to analyze the robot’s dynamic behavior.
( | ) m | J n

r
n
J k J | L
m | 0.2810 | 11.75 2

2
1 | 2 = | + | + | +
( | ) m | J n
r k | 0.03812 | 11.75 2

2
2 = | +
( | ) m | J n
r k | 0.2619 | 9.050 2

2
3 = | − | +
( | ) m | J n
r k | 0.05717 | 9.050 2

2
4 = | − | +
( | ) m | J n

r
n
J k | J | L
m | 0.2459 | 6.9710 2

2
5 | 2 = | + | + | +
( | ) m | J n
r k | 0.07323 | 6.9710 2

2
6 = | +
7 | 2 n
c k | c | L = m + | m n
r k | 2

2
8 = 0.2784 | m n
r k | 2

2
9 = 0.02184

m n

r k | 2

2
10 = 0.2566
m n
r k | 2

2
11 = 0.2347

(A-1)

ACKNOWLEDGMENT
Authors gratefully acknowledge the technical support of MRL SSL RoboCup team members.

REFERENCES
[1] T.K. Nagy, R. D’Andrea, P. Ganguly, “Near-optimal dynamic trajectory generation and control of an omnidirectional vehicle,” Robotics and Autonomous Systems, vol. 47, no. 1, pp. 47–64, Jan. 2004.
[2] J. K. Choi, B.K. Kim, “Near minimum-time direct voltage control algorithms for wheeled mobile robots with current and voltage constraints,” Robotica, Vol. 19, no. 1, pp. 29–39, Jan. 2001.
[3] Yong Liu, J. Jim Zhu, Robert L. Williams II, Jianhua Wu, “Omnidirectional mobile robot controller based on trajectory linearization,” Robotics and Autonomous System, Vol. 56, no. 5, pp. 461–479, May. 2008.
[4] F.G. Pin, S.M. Killough, “A new family of omnidirectional and holonomic wheeled platforms for mobile robots,” IEEE Trans. Robotics and Automation, Vol. 10, no. 4, pp. 480–489, Aug. 1994.
[5] M. J. Jung, H. S. Kim, S. Kim, J. H. Kim, “Omnidirectional mobile base OK-II,” in Proc. IEEE International Conference on Robotics and Automation, 2000, pp. 3449–3454
[6] M. West, H. Asada, “Design of a holonomic omnidirectional vehicle,” in Proc. IEEE International Conf. on Robotics and Automation, 1992, pp. 97–103
[7] T.K. Nagy, P. Ganguly, R. D’Andrea, “Real-time trajectory generation for omnidirectional vehicle,” in Proc. American Control Conf., 2002, pp. 286–291
[8] H.A. Samani, A. Abdollahi, H. Ostadi, S.Z. Rad, “Design and development of a comprehensive omnidirectional soccer robot,” International Journal of Advanced Robotic Systems, vol. 1, no. 3, pp. 191–200, Sept. 2004.
[9] O. Purwin, R. D’Andrea, “Trajectory generation and control for four wheeled omnidirectional vehicles,” Robotics and Autonomous Systems, vol. 54, no. 1, pp. 13–22, Jan. 2006.
[10] L.Wilson, J.Y. Lew, “Design and modeling of a redundant omnidirectional RoboCup goalie,” presented at the 2001 RoboCup International Symposium, Seattle, WA
[11] K. Watanabe, Y. Shiraishi, S.G. Tzafestas, J. Tang, T. Fukuda, “Feedback control of an omnidirectional autonomous platform for mobile service robots,” Journal of Intelligent and Robotic Systems, Vol. 22, no. 3-4, pp. 315–330, Jul. 1998.
[12] K. Watanabe, “Control of an omnidirectional mobile robot,” in Proc. 2nd International Conference on Knowledge-Based Intelligent Electronic Systems, 1998, pp. 51–60.
[13] J. Wu, “Dynamic path planning of an omnidirectional robot in a dynamic environment,” Ph.D. Dissertation, Ohio Univ., Athens, OH, 2005
[14] H. Groenhuis, “A Design Tool for Electromechanical Servo Systems,” Ph.D. Dissertation, Twente Univ., Enschede, Netherland, 1991
[15] Coelingh H.J., de Vries TJA, van Amerongen J., “Design support for motion control systems application to the philips fast component mounter,” in 7th Mechatronics Forum International Conference, Atlanta, GA, Sept. 2000.
[16] André S. Conceicao, A. Paulo Moreira, and Paulo J. Costa, “Practical Approach of Modeling and Parameters Estimation for Omnidirectional Mobile Robots,” IEEE/ASME Trans. MECHATRONICS, accepted Jan. 2009.
