UBC-Thunderbots/Electrical/electronics/robot/main/STM32 Pins.xls

 |  |  |  |  | Optical Encoders |  | MCU-to-FPGA Bus |  | Chicker | ADC | GPIO
 |  |  |  |  | Choose one of each pin for BOTH of the timers |  | Choose one of each pin for ONE of the SPI modules (ignore the other two) |  | Choose one pin for each of three timers | Choose any four ADC pins | Choose any 21 pins
Pin # | Name | 5V? | High current? | Fixed | TIM2 | TIM3 | SPI1 | SPI2 | TIM1/8–14 | ADC | GPIO
2 | PC13 | 1 | 0
3 | PC14 | 1 | 0
4 | PC15 | 1 | 0
8 | PC0 | 1 | 1 |  |  |  |  |  |  | 123
9 | PC1 | 1 | 1 |  |  |  |  |  |  | 123
10 | PC2 | 1 | 1 |  |  |  |  | SPI2_MISO |  | 123
11 | PC3 | 1 | 1 |  |  |  |  | SPI2_MOSI |  | 123
14 | PA0 | 1 | 1 | TIM5_CH1 | TIM2_CH1 |  |  |  |  | 123
15 | PA1 | 1 | 1 | TIM5_CH2 | TIM2_CH2 |  |  |  |  | 123
16 | PA2 | 1 | 1 |  |  |  |  |  | TIM9 | 123
17 | PA3 | 1 | 1 |  |  |  |  |  | TIM9 | 123
20 | PA4 | 0 | 1 |  |  |  |  |  |  | 12
21 | PA5 | 0 | 1 |  |  |  | SPI1_SCK |  |  | 12
22 | PA6 | 1 | 1 |  |  | TIM3_CH1 | SPI1_MISO |  | TIM13 | 12
23 | PA7 | 1 | 1 |  |  | TIM3_CH2 | SPI1_MOSI |  | TIM14 | 12
24 | PC4 | 1 | 1 |  |  |  |  |  |  | 12
25 | PC5 | 1 | 1 |  |  |  |  |  |  | 12
26 | PB0 | 1 | 1 |  |  |  |  |  |  | 12
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
