UBC-Thunderbots/Electrical/.gitbook/assets/1-hnslrgml8ug_fd0z-zi37w.png

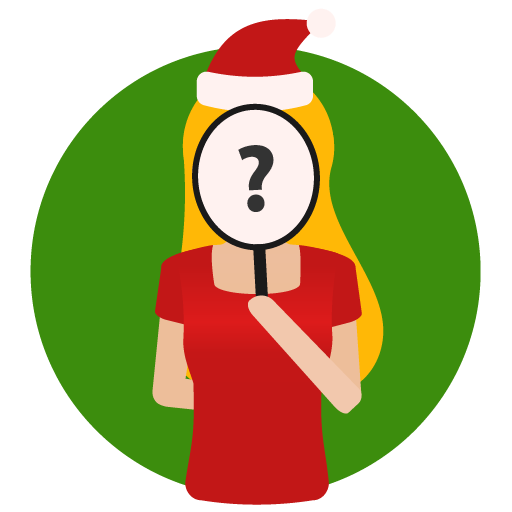
.gitbook/assets/1-hnslrgml8ug_fd0z-zi37w.png
