UBC-Thunderbots/Electrical/.gitbook/assets/1548364823767.png

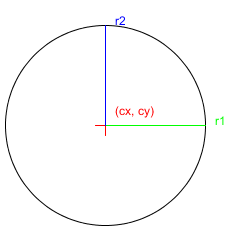
.gitbook/assets/1548364823767.png
