UBC-Thunderbots/Electrical/.gitbook/assets/1548365169381.png

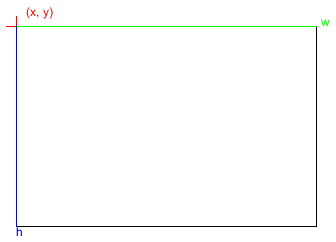
.gitbook/assets/1548365169381.png
