UBC-Thunderbots/Electrical/.gitbook/assets/1548365435045.png

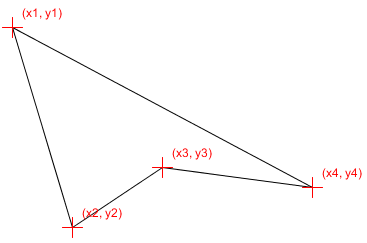
.gitbook/assets/1548365435045.png
