UBC-Thunderbots/Electrical/.gitbook/assets/1548365504591.png

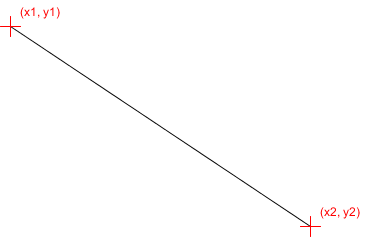
.gitbook/assets/1548365504591.png
