UBC-Thunderbots/Electrical/.gitbook/assets/1548366085216.png

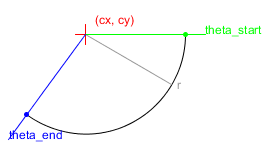
.gitbook/assets/1548366085216.png
