UBC-Thunderbots/Electrical/.gitbook/assets/bang-bang.png

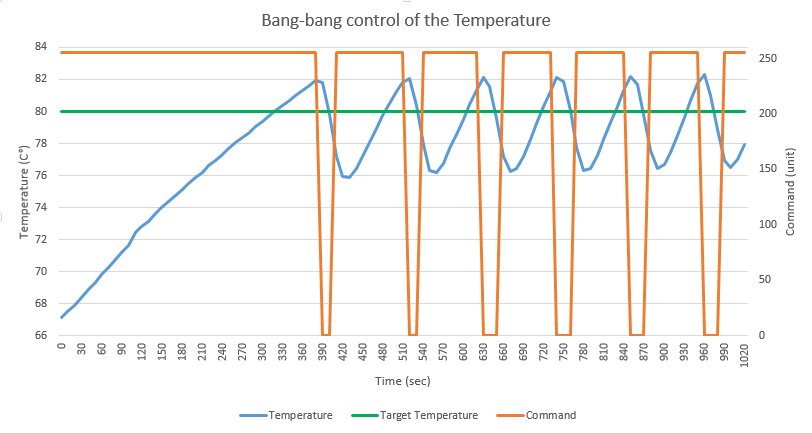
.gitbook/assets/bang-bang.png
