UBC-Thunderbots/Electrical/.gitbook/assets/baseplate-for-wiki.JPG

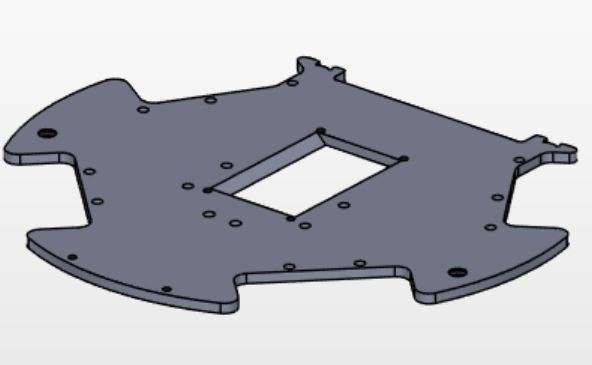
.gitbook/assets/baseplate-for-wiki.JPG
