UBC-Thunderbots/Electrical/.gitbook/assets/breakbeam1.png

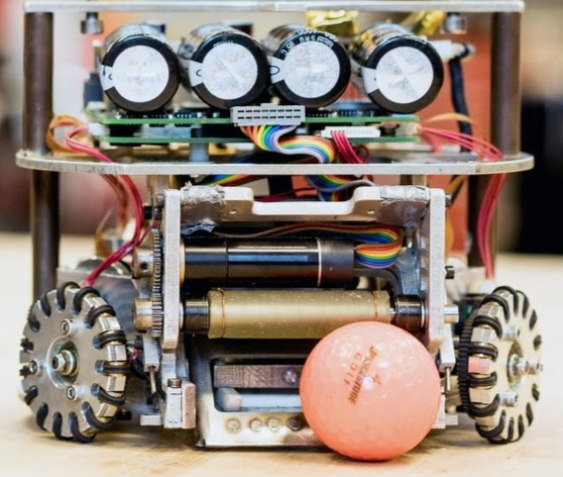
.gitbook/assets/breakbeam1.png
