UBC-Thunderbots/Electrical/.gitbook/assets/breakoutconn_hannah.PNG

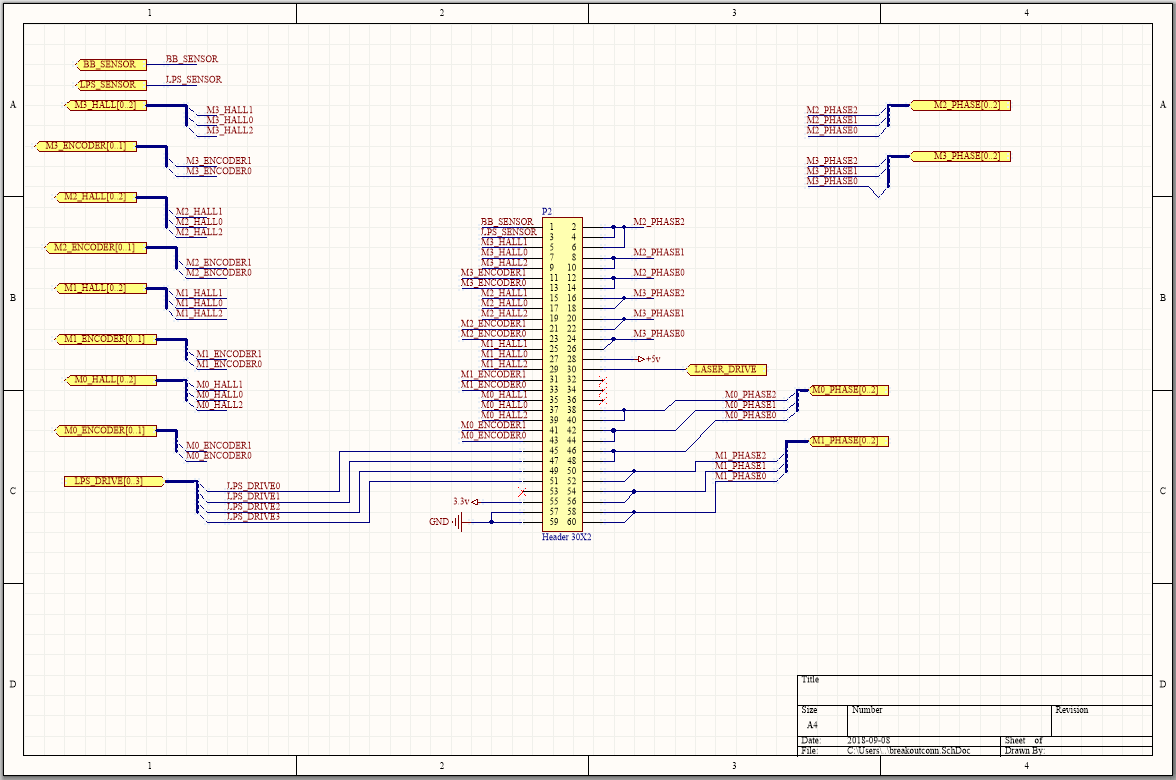
.gitbook/assets/breakoutconn_hannah.PNG
