UBC-Thunderbots/Electrical/.gitbook/assets/capacitor_discharge.jpg

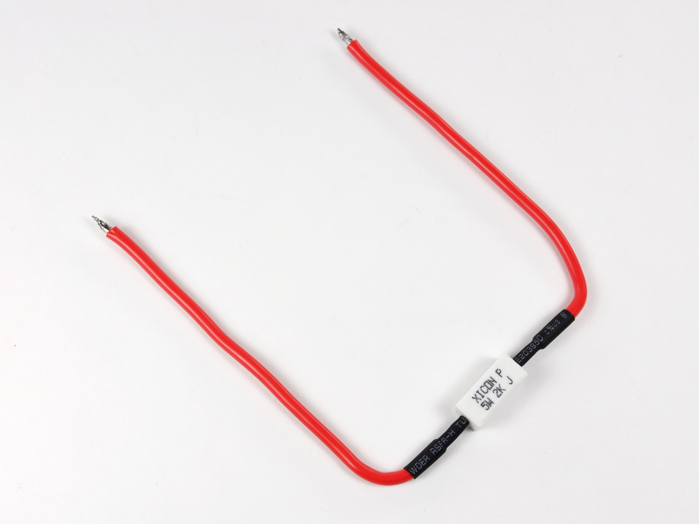
.gitbook/assets/capacitor_discharge.jpg
