UBC-Thunderbots/Electrical/.gitbook/assets/chassis.PNG

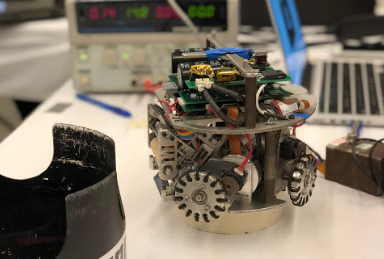
.gitbook/assets/chassis.PNG
