UBC-Thunderbots/Electrical/.gitbook/assets/chicker (1).jpg

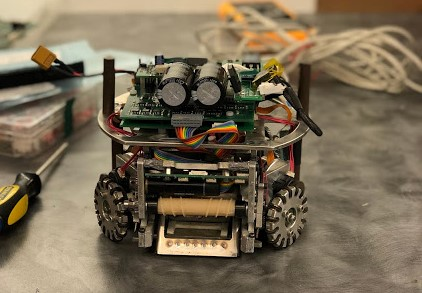
.gitbook/assets/chicker (1).jpg
