UBC-Thunderbots/Electrical/.gitbook/assets/chicker.jpg

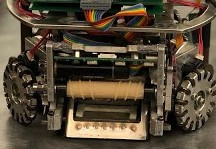
.gitbook/assets/chicker.jpg
