UBC-Thunderbots/Electrical/.gitbook/assets/chipper-for-wiki.JPG

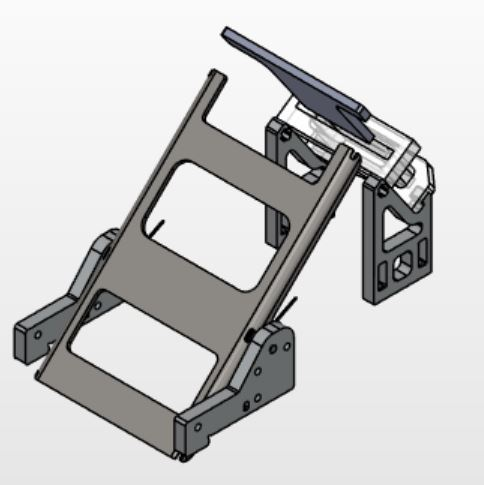
.gitbook/assets/chipper-for-wiki.JPG
