UBC-Thunderbots/Electrical/.gitbook/assets/dribbler-for-wiki.JPG

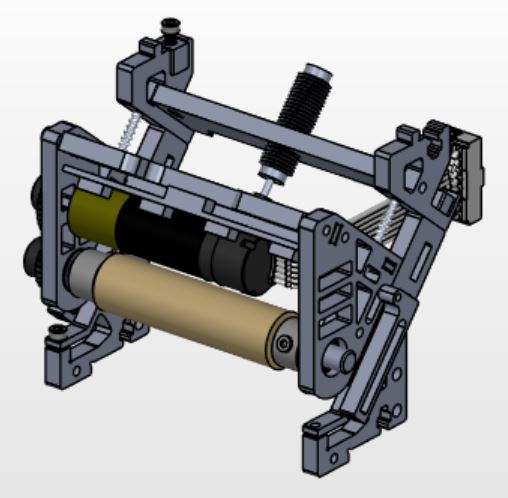
.gitbook/assets/dribbler-for-wiki.JPG
