UBC-Thunderbots/Electrical/.gitbook/assets/drivetrain-for-wiki.JPG

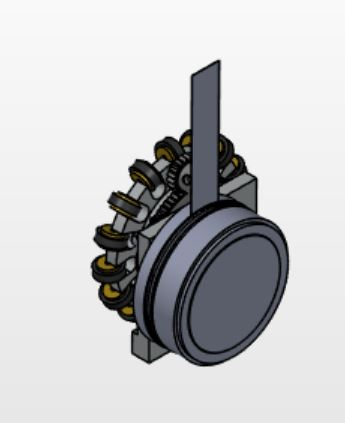
.gitbook/assets/drivetrain-for-wiki.JPG
