UBC-Thunderbots/Electrical/.gitbook/assets/drivetrain.PNG

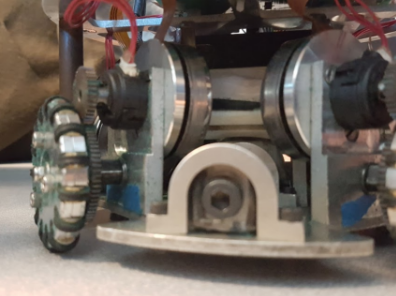
.gitbook/assets/drivetrain.PNG
