UBC-Thunderbots/Electrical/.gitbook/assets/flyback.png

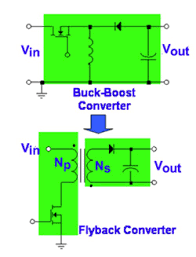
.gitbook/assets/flyback.png
