UBC-Thunderbots/Electrical/.gitbook/assets/geneva-2 (1).jpg

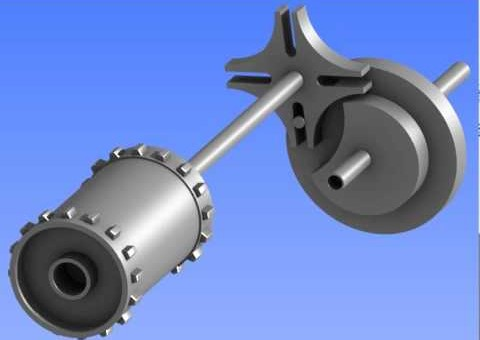
.gitbook/assets/geneva-2 (1).jpg
