UBC-Thunderbots/Electrical/.gitbook/assets/giphy.gif

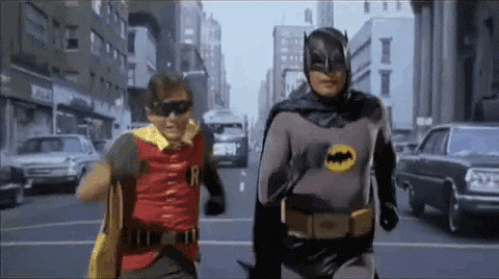
.gitbook/assets/giphy.gif
