UBC-Thunderbots/Electrical/.gitbook/assets/hall-voltage.png

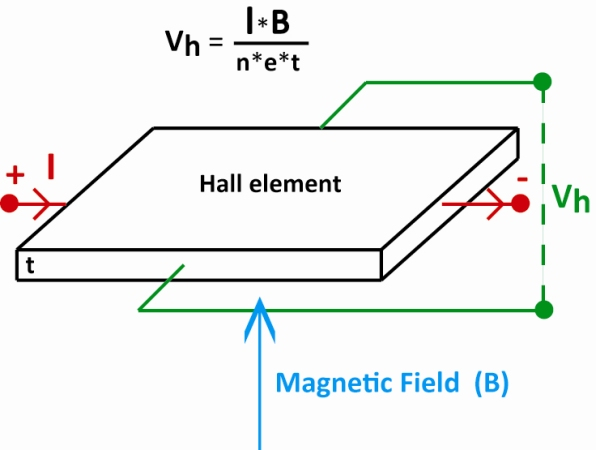
.gitbook/assets/hall-voltage.png
