UBC-Thunderbots/Electrical/.gitbook/assets/image (1).png

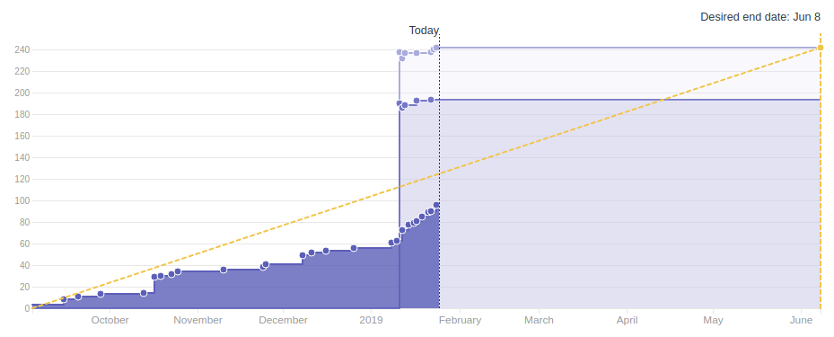
.gitbook/assets/image (1).png
