UBC-Thunderbots/Electrical/.gitbook/assets/image (2).png

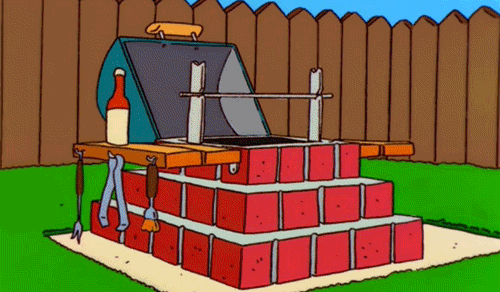
.gitbook/assets/image (2).png
