UBC-Thunderbots/Electrical/.gitbook/assets/image.png

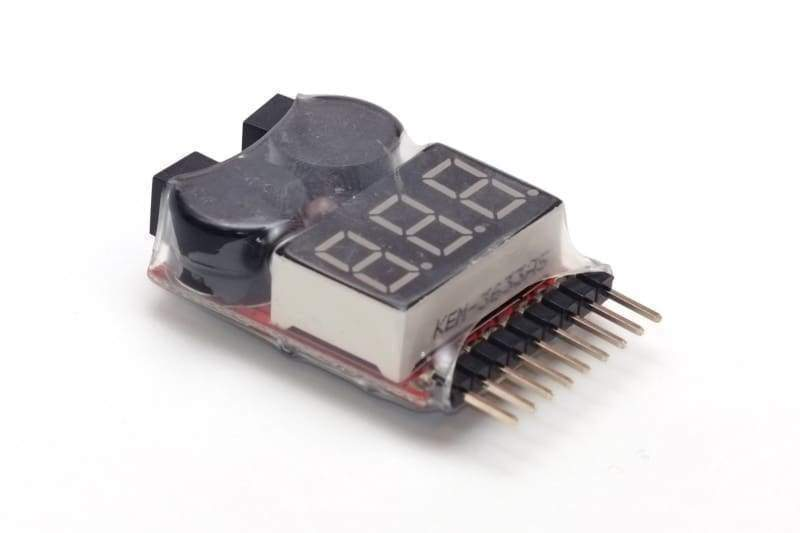
.gitbook/assets/image.png
