UBC-Thunderbots/Electrical/.gitbook/assets/midplate-for-wiki.JPG

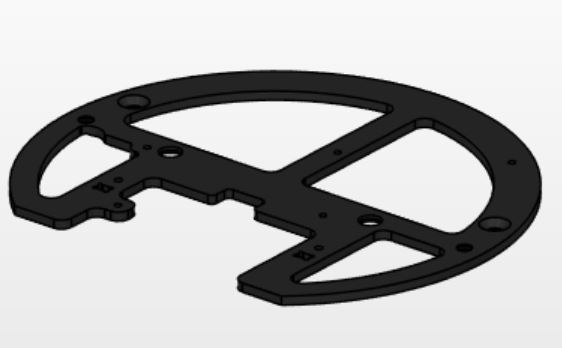
.gitbook/assets/midplate-for-wiki.JPG
