UBC-Thunderbots/Electrical/.gitbook/assets/mosfet.jpg

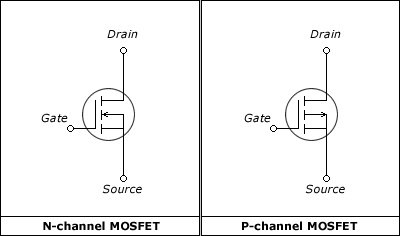
.gitbook/assets/mosfet.jpg
