UBC-Thunderbots/Electrical/.gitbook/assets/optocoupler.png

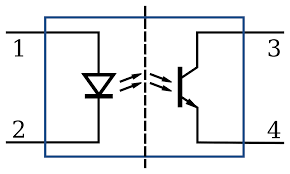
.gitbook/assets/optocoupler.png
