UBC-Thunderbots/Electrical/.gitbook/assets/pid.png

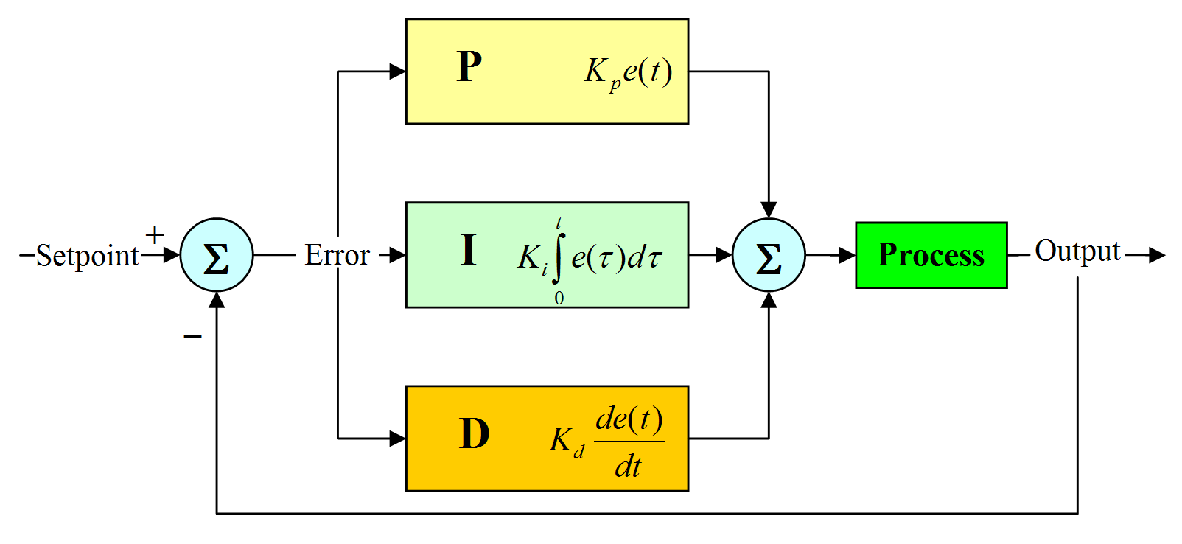
.gitbook/assets/pid.png
