UBC-Thunderbots/Electrical/.gitbook/assets/pin-config-for-wiki.jpg

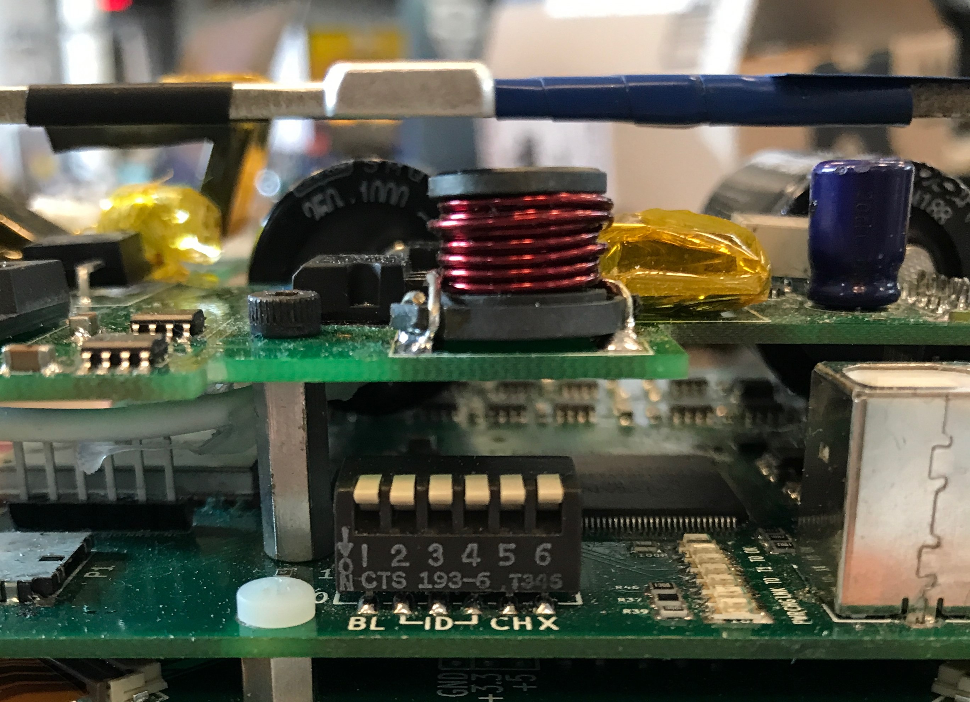
.gitbook/assets/pin-config-for-wiki.jpg
