UBC-Thunderbots/Electrical/.gitbook/assets/screenshot-from-2018-07-21-23-00-58 (1).png

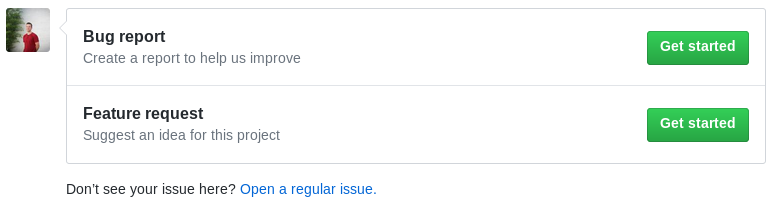
.gitbook/assets/screenshot-from-2018-07-21-23-00-58 (1).png
