UBC-Thunderbots/Electrical/.gitbook/assets/shell-for-wiki.JPG

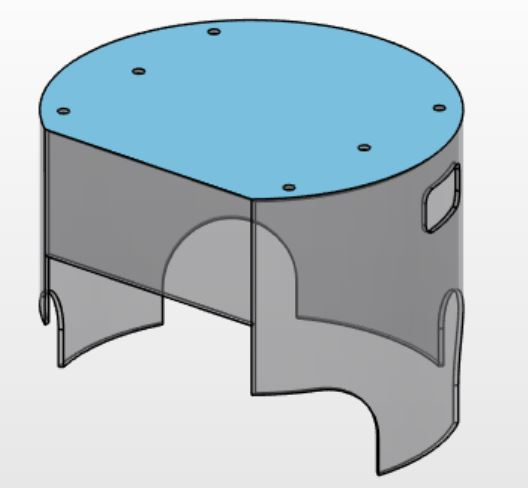
.gitbook/assets/shell-for-wiki.JPG
