UBC-Thunderbots/Electrical/.gitbook/assets/t-bar.jpg

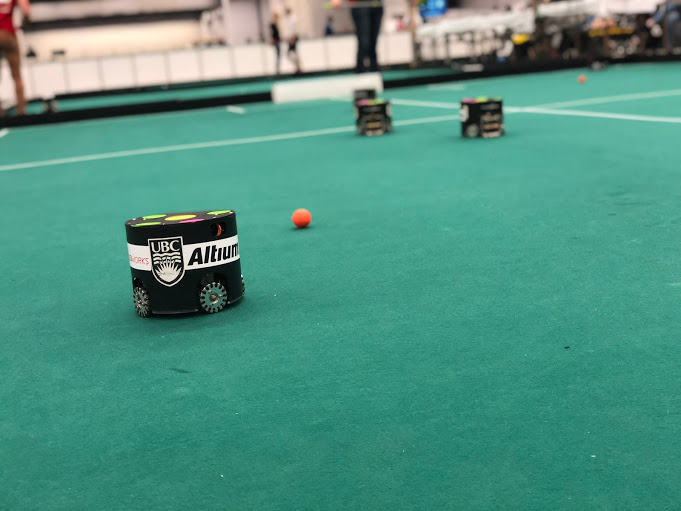
.gitbook/assets/t-bar.jpg
