UBC-Thunderbots/Electrical/.gitbook/assets/tbar-for-wiki.JPG

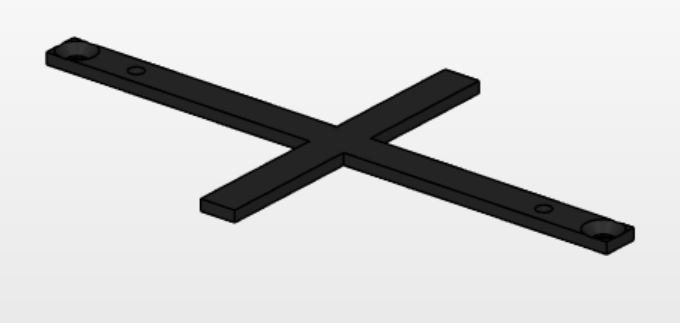
.gitbook/assets/tbar-for-wiki.JPG
