UBC-Thunderbots/Electrical/.gitbook/assets/tbots_wheelnum.JPG

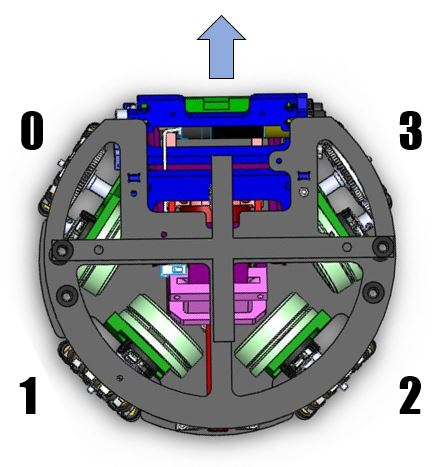
.gitbook/assets/tbots_wheelnum.JPG
