UBC-Thunderbots/Electrical/.gitbook/assets/thunderbots-software-structure-ai.png

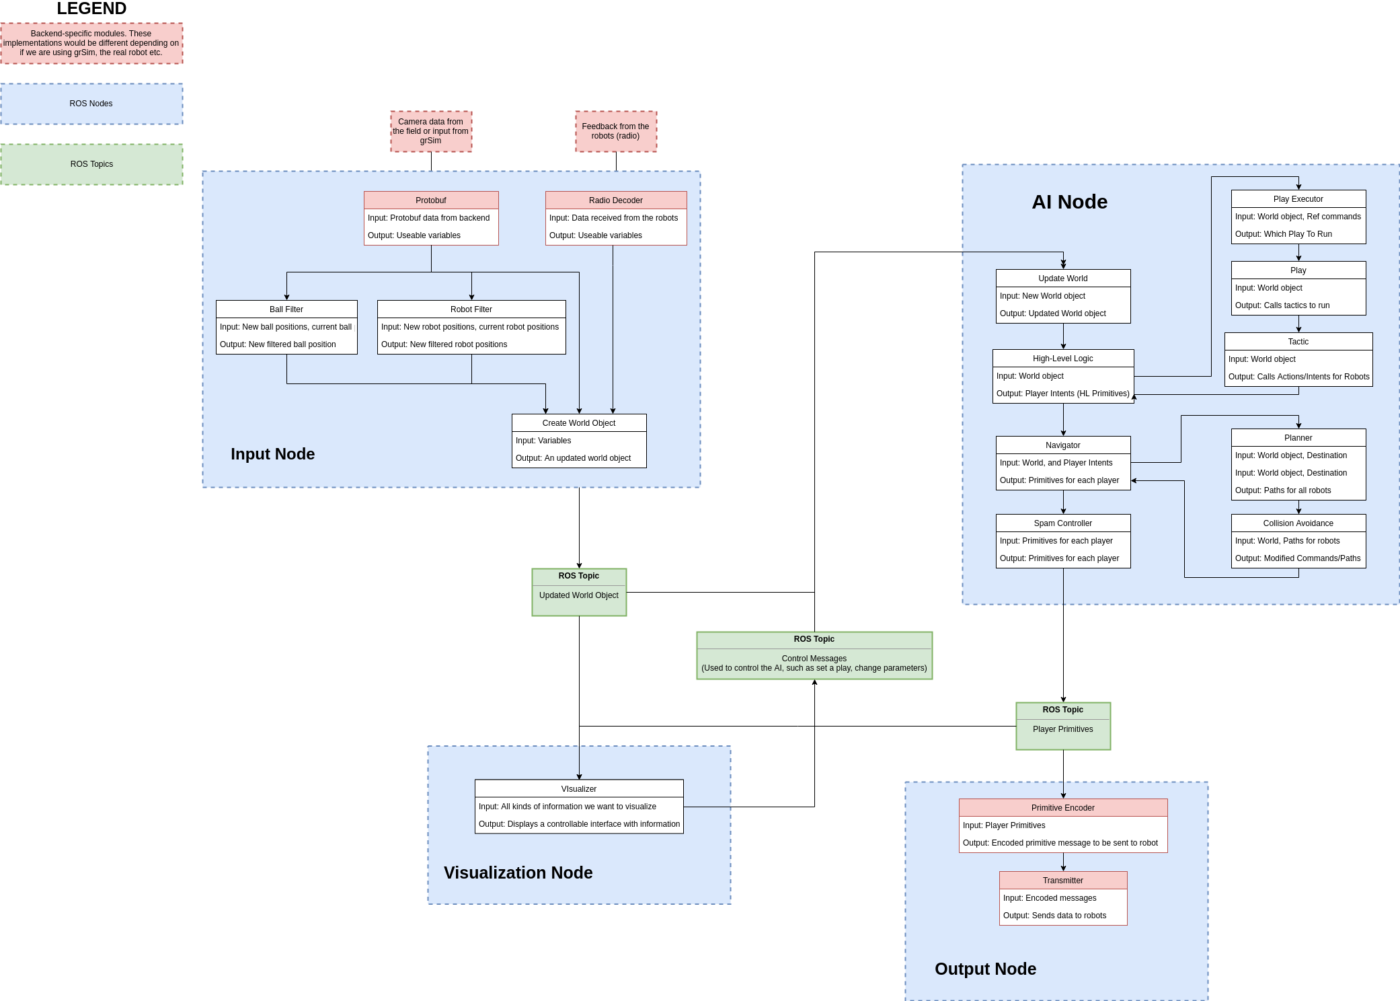
.gitbook/assets/thunderbots-software-structure-ai.png
