UBC-Thunderbots/Electrical/electronics/robot/chicker/Chicker_parts.xlsx

Web Link | Qty | Unit Price | Unit Total | Total | Requisitioner | Purchaser | Status
http://www.digikey.ca/scripts/DkSearch/dksus.dll?Detail&itemSeq=198906648&uq=636006516585006627 | 30 | $0.04 | $1.32 | $784.36 | Graham Whyte
http://www.digikey.ca/scripts/DkSearch/dksus.dll?Detail&itemSeq=198906653&uq=636006516585006627 | 10 | $0.07 | $0.68
http://www.digikey.ca/scripts/DkSearch/dksus.dll?Detail&itemSeq=198906660&uq=636006516585016628 | 30 | $7.26 | $217.73
http://www.digikey.ca/scripts/DkSearch/dksus.dll?Detail&itemSeq=198906679&uq=636006516585016628 | 10 | $1.57 | $15.66
http://www.digikey.ca/scripts/DkSearch/dksus.dll?Detail&itemSeq=198906692&uq=636006516585026629 | 10 | $0.28 | $2.85
http://www.digikey.ca/scripts/DkSearch/dksus.dll?Detail&itemSeq=198906720&uq=636006516585026629 | 10 | $1.06 | $10.57
http://www.digikey.ca/scripts/DkSearch/dksus.dll?Detail&itemSeq=198906732&uq=636006516585026629 | 10 | $6.94 | $69.40
http://ca.mouser.com/ProductDetail/Bourns/SRP1770TA-220M/?qs=P%2fbxraXw5h18%252brxQXbN4GQ%3d%3d | 10 | $3.74 | $37.40
http://www.digikey.ca/scripts/DkSearch/dksus.dll?Detail&itemSeq=198906776&uq=636006516585036630 | 10 | $1.15 | $11.47
http://www.digikey.ca/scripts/DkSearch/dksus.dll?Detail&itemSeq=198906785&uq=636006516585036630 | 20 | $0.43 | $8.52
http://www.digikey.ca/scripts/DkSearch/dksus.dll?Detail&itemSeq=198906802&uq=636006516585046631 | 10 | $9.24 | $92.38
http://www.digikey.ca/scripts/DkSearch/dksus.dll?Detail&itemSeq=198906920&uq=636006516585046631 | 20 | $0.03 | $0.64
http://www.digikey.ca/scripts/DkSearch/dksus.dll?Detail&itemSeq=198906926&uq=636006516585046631 | 10 | $0.03 | $0.33
http://www.digikey.ca/scripts/DkSearch/dksus.dll?Detail&itemSeq=198906929&uq=636006516585056632 | 30 | $0.02 | $0.68
http://www.digikey.ca/scripts/DkSearch/dksus.dll?Detail&itemSeq=198906935&uq=636006516585056632 | 20 | $0.03 | $0.64
http://www.digikey.ca/scripts/DkSearch/dksus.dll?Detail&itemSeq=198906955&uq=636006516585066633 | 20 | $3.84 | $76.74
http://www.digikey.ca/scripts/DkSearch/dksus.dll?Detail&itemSeq=198906965&uq=636006516585066633 | 30 | $2.69 | $80.83
http://www.digikey.ca/scripts/DkSearch/dksus.dll?Detail&itemSeq=198907233&uq=636006516585066633 | 10 | $0.35 | $3.55
http://www.digikey.ca/scripts/DkSearch/dksus.dll?Detail&itemSeq=198907254&uq=636006516585076634 | 10 | $5.20 | $51.97
http://ca.mouser.com/ProductDetail/Fairchild-Semiconductor/FGA180N33ATDTU/?qs=AxPfoIcMNKLFHrx2XtahLg%3d%3d | 20 | $5.05 | $101.00
