UBC-Thunderbots/Electrical/electronics/models/mainboard_thermal/Assem1.SLDASM

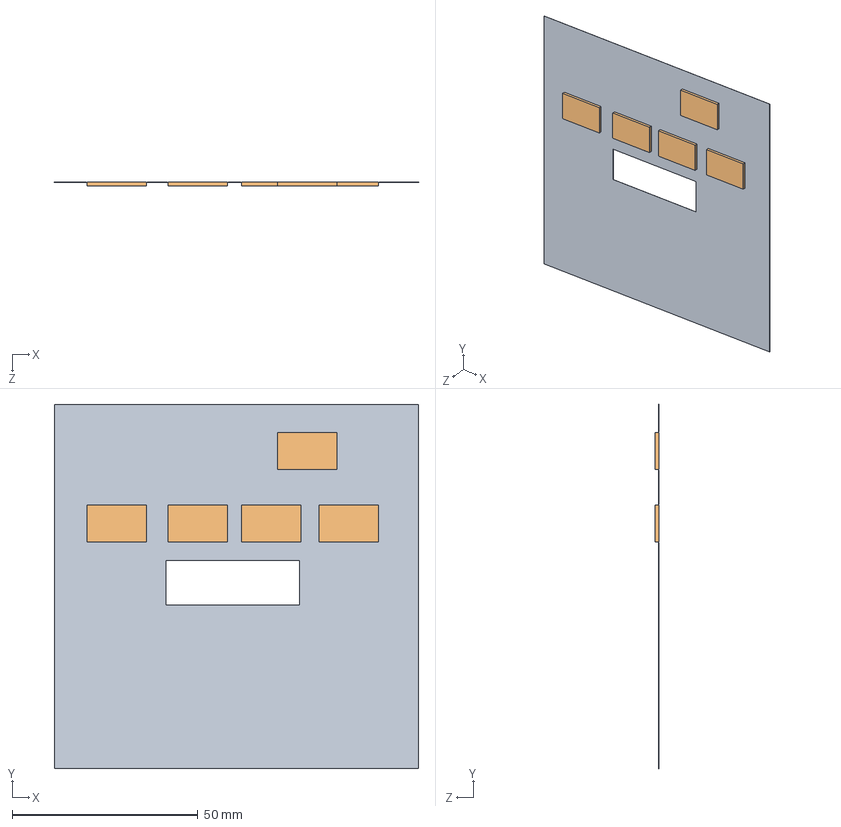
[picture p71: CAD file, 2013-02-27]
electronics/models/mainboard_thermal/Assem1.SLDASM
98.0 x 98.0 x 1.04 mm
copper
heat_source x 5
