UBC-Thunderbots/Electrical/electronics/HannahSawiuk-Altium/chicker.DXF

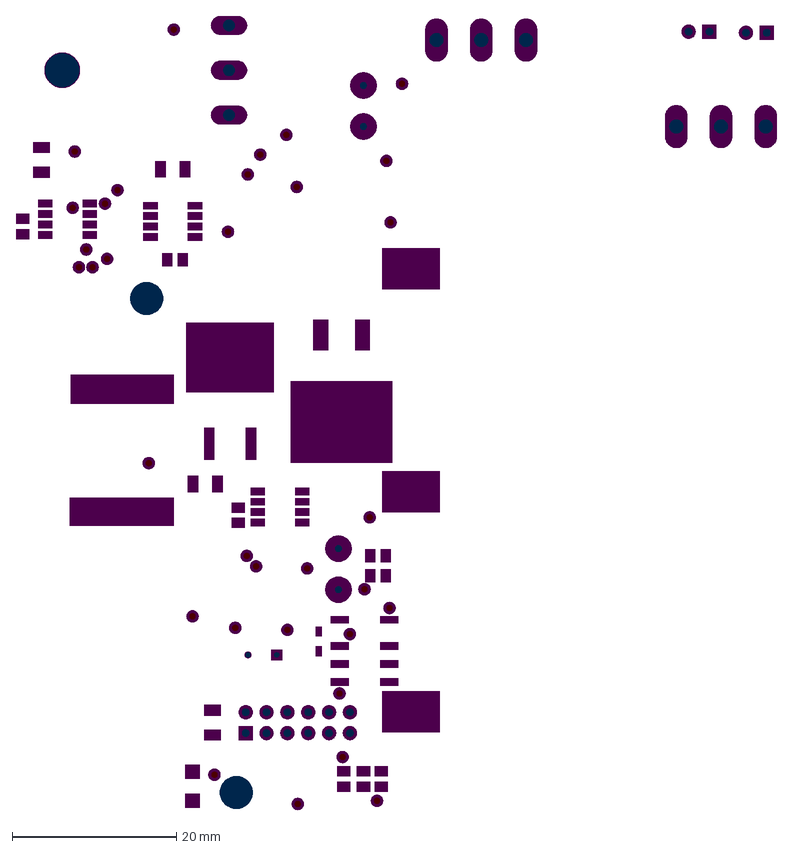
[picture p72: CAD file, 2018-09-28]
electronics/HannahSawiuk-Altium/chicker.DXF
92.7 x 96.8 mm
