UBC-Thunderbots/Electrical/electronics/HannahSawiuk-Altium/Component libraries/LIB_MIC5020YM/Altium/MIC5020YM.stp

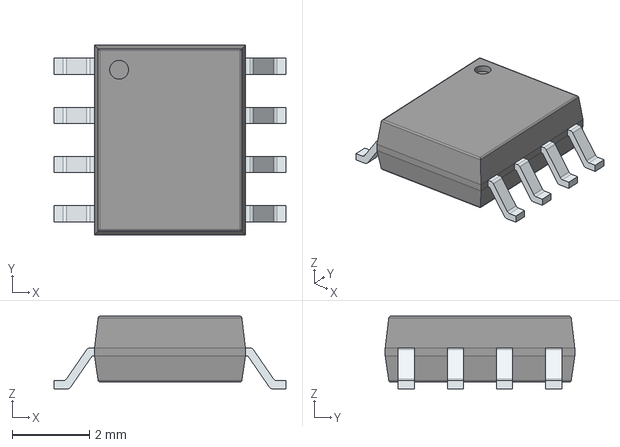
[picture p73: CAD file, 2018-05-05]
electronics/HannahSawiuk-Altium/Component libraries/LIB_MIC5020YM/Altium/MIC5020YM.stp
6.00 x 4.90 x 1.88 mm
PinsArrayLR
