UBC-Thunderbots/Electrical/electronics/models/mainboard_thermal/copper.SLDPRT

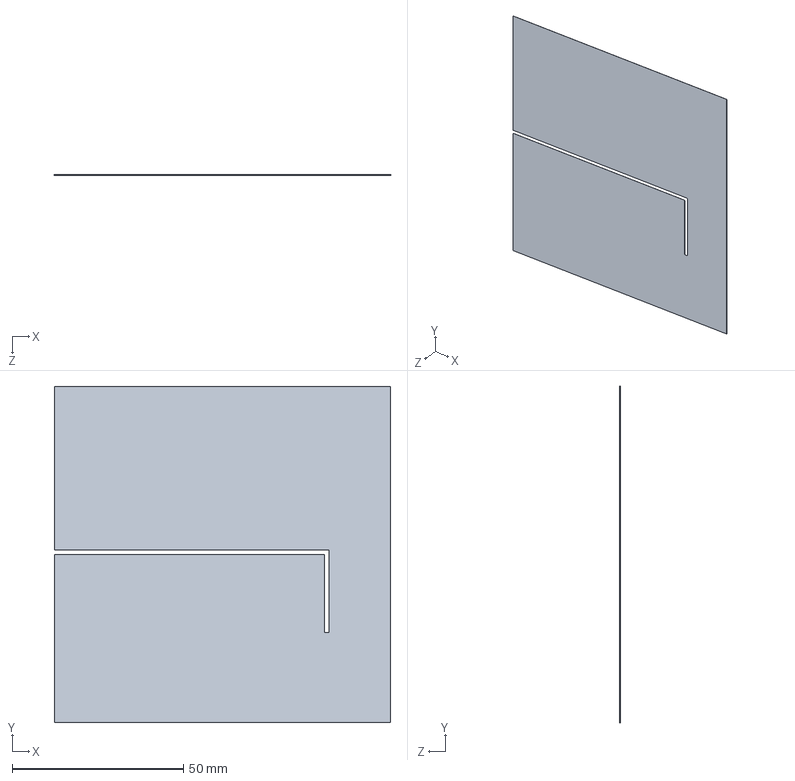
[picture p74: CAD file, 2013-02-27]
electronics/models/mainboard_thermal/copper.SLDPRT
98.0 x 98.0 x 0.035 mm
