UBC-Thunderbots/Electrical/electronics/HannahSawiuk-Altium/chicker_laser.DXF

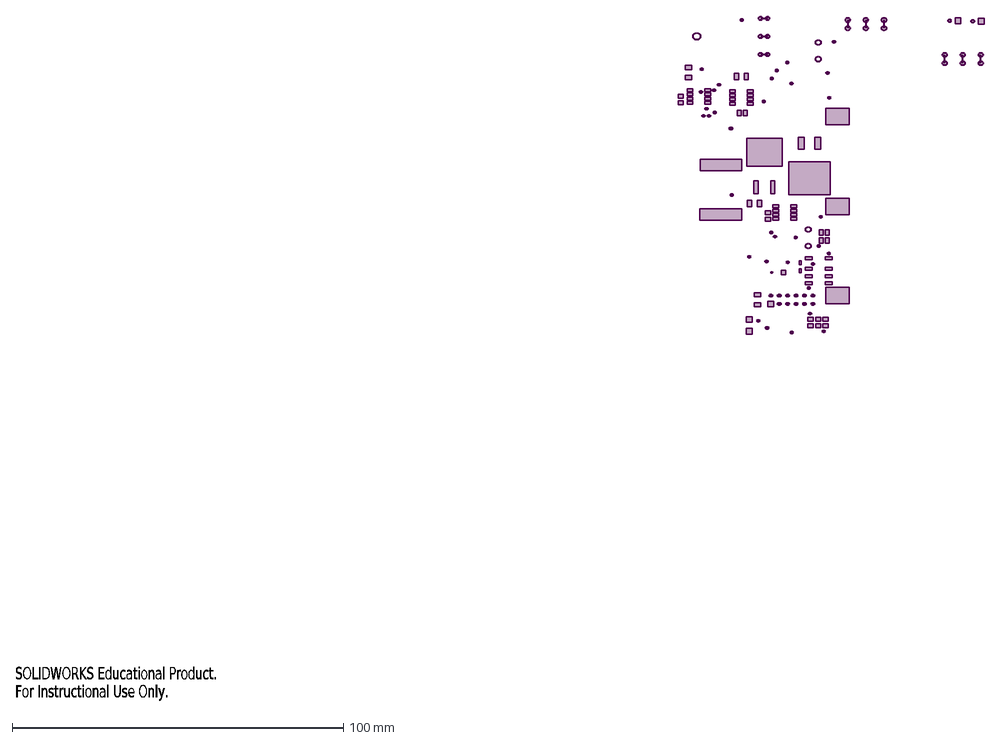
[picture p75: CAD file, 2018-09-28]
electronics/HannahSawiuk-Altium/chicker_laser.DXF
SOLIDWORKS Educational Product.
For Instructional Use Only.
