UBC-Thunderbots/Electrical/electronics/models/mainboard_thermal/Part1.SLDPRT

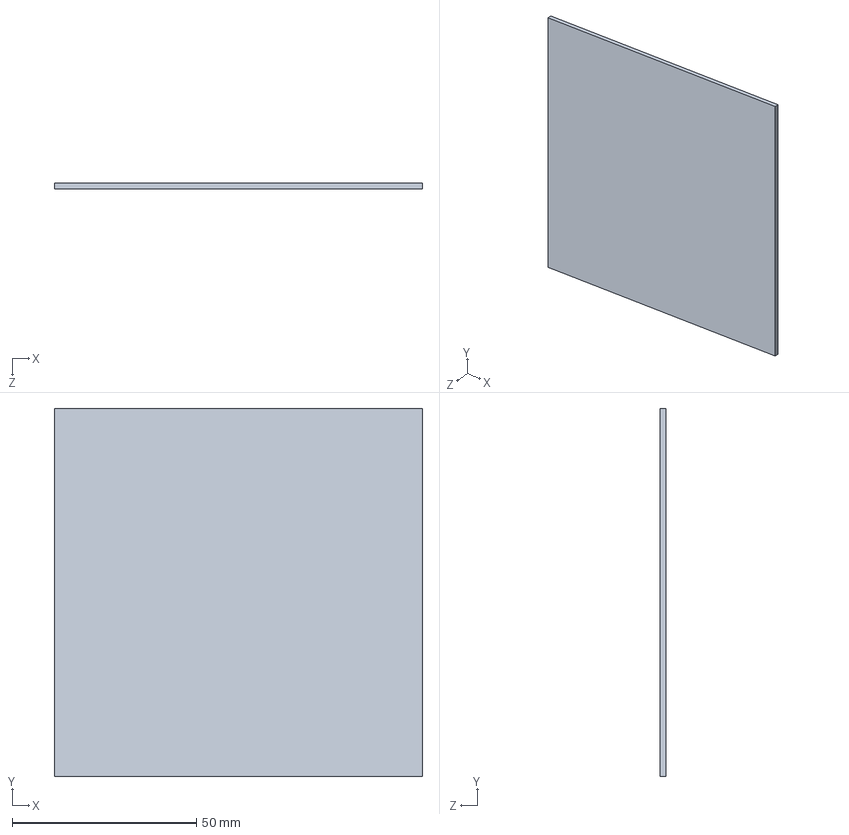
[picture p76: CAD file, 2013-02-27]
electronics/models/mainboard_thermal/Part1.SLDPRT
100.0 x 100.0 x 1.60 mm
