UBC-Thunderbots/Electrical/electronics/models/mainboard_thermal/heat_source.SLDPRT

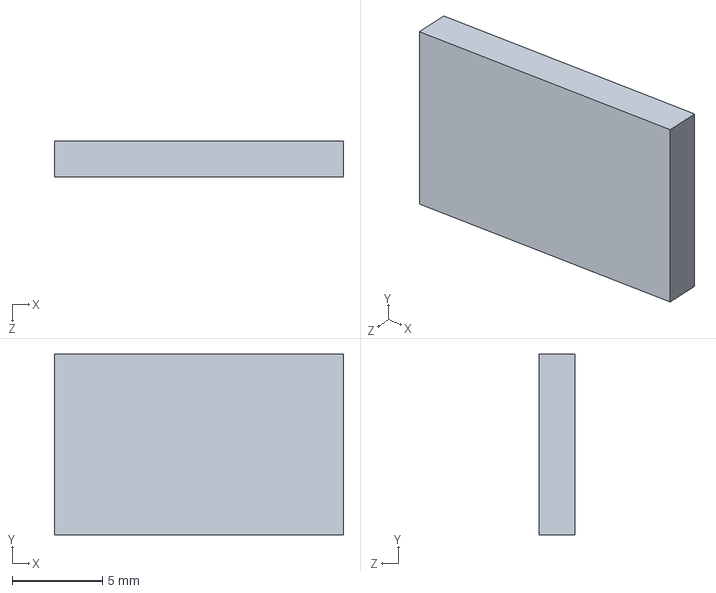
[picture p77: CAD file, 2013-02-27]
electronics/models/mainboard_thermal/heat_source.SLDPRT
16.0 x 10.0 x 2.00 mm
