UBC-Thunderbots/Electrical/(list of files, cad)

Other CAD files:
electronics/models/mainboard_thermal/board.SLDPRT
legacy/electronics/models/mainboard_thermal/board.SLDPRT
electronics/HannahSawiuk-Altium/Component libraries/LIB_MIC5020YM/Altium/MIC5020YM.stl
electronics/HannahSawiuk-Altium/chicker.SLDDRW
legacy/electronics/HannahSawiuk-Altium/Component libraries/LIB_MIC5020YM/Altium/MIC5020YM.stl
legacy/electronics/HannahSawiuk-Altium/chicker.SLDDRW
