UBC-Thunderbots/Electrical/controls/kalman-test-data/fuzzy.tsv

Start of Log
Backend	xbee
Parameter Changed	0	Backend/XBee/Loop Delay
Parameter Changed	80	Nav/Pivot/offset angle
Parameter Changed	0	Nav/Pivot/offset distance
Parameter Changed	30	Nav/Pivot/orientation offset
Parameter Changed	30	Nav/Pivot2/offset angle (degrees)
Parameter Changed	0.15	Nav/Pivot2/offset distance
Parameter Changed	30	Nav/Pivot2/orientation offset (degrees)
Parameter Changed	10	Nav/PivotAram/max acceleration
Parameter Changed	1	Nav/PivotAram/pivot radius
Parameter Changed	30	Nav/RRT/Pivot: offset angle (degrees)
Parameter Changed	0.15	Nav/RRT/Pivot: offset distance
Parameter Changed	30	Nav/RRT/Pivot: orientation offset (degrees)
Parameter Changed	1	oldAI/goalie dive for the ball
Parameter Changed	0.05	oldAI/goalie should ignore direction of ball
Parameter Changed	25	oldAI/Grid X size
Parameter Changed	25	oldAI/Grid Y size
Parameter Changed	40	oldAI/kickoff: angle to separate players (degrees)
Parameter Changed	40	oldAI/kickoff: angle to separate players (degrees)
Parameter Changed	0.3	oldAI/Lone goalie distance to goal post (m)
Parameter Changed	0.3	oldAI/Lone goalie distance to goal post (m)
Parameter Changed	3	oldAI/max goalie dist from goal (robot radius)
Parameter Changed	1.1	oldAI/shrink robot radius
Parameter Changed	20	oldAI/stop: angle to separate players (degrees)
Parameter Changed	1	oldAI/Test strategy catch ball
Parameter Changed	1	oldAI/Test strategy Ram ball
Parameter Changed	1	oldAI/Test strategy recieve ball
Parameter Changed	1	oldAI/Test strategy stay own half
Parameter Changed	2	RC/Circle/amount to scale controller velocities by
Parameter Changed	3	RC/fuzzy2/max acc
Parameter Changed	1	RC/PID3/angle diff
Parameter Changed	30	RC/PID3/angle max vel
Parameter Changed	30	RC/PID3/angle prop
Parameter Changed	1.01	RC/PID3/angular slowdown when translating
Parameter Changed	0	RC/PID3/flip trans&ang slowdown (CARE)
Parameter Changed	1	RC/PID3/reduce angular velocity when translating
Parameter Changed	0.81	RC/PID3/x to y ratio
Parameter Changed	1	RC/PID3/xy diff
Parameter Changed	5	RC/PID3/xy max acc
Parameter Changed	9	RC/PID3/xy max vel
Parameter Changed	20	RC/PID3/xy prop
Parameter Changed	0.1	STP/Action/Goalie/Goalie Action: threatening ball speed
Parameter Changed	0.3	STP/Action/Goalie/Lone Goalie: distance to goal post (m)
Parameter Changed	0.1	STP/Action/shoot/Decay constant for the ball velocity
Parameter Changed	3	STP/defense/max goalie dist from goal (robot radius)
Parameter Changed	1.1	STP/defense/shrink robot radius
Parameter Changed	0.05	STP/evaluation/speed goalie should ignore direction of ball
Parameter Changed	1.1	STP/evaluation/Steal threshold: distance of ball from enemy (robot radius)
Parameter Changed	1	STP/offense/ball distance weight
Parameter Changed	4	STP/offense/enemy avoidance distance (robot radius)
Parameter Changed	25	STP/offense/grid x size
Parameter Changed	25	STP/offense/grid y size
Parameter Changed	1	STP/pass/ball distance weight
Parameter Changed	4	STP/pass/enemy avoidance distance (robot radius)
Parameter Changed	40	STP/play/kickoff: angle to separate players (degrees)
Parameter Changed	3	STP/predicates/enemy avoidance distance (robot radius)
Parameter Changed	20	STP/Tactic/stop: angle to separate players (degrees)
Parameter Changed	2	STP/util/distance for ball possesion (x ball radius)
Parameter Changed	2	STP/util/if dribble > this time, force shoot (sec)
Parameter Changed	1	STP/util/posses ball is has ball
Parameter Changed	0.5	STP/util/Shooting Accuracy General (meters from target)
Parameter Changed	3	STP/util/time we can prepare during special plays (sec)
Friendly Colour Changed	Yellow
Ball Filter Changed
Robot Controller Changed
Play Type Changed	Halt
Team Scores	0	0
High Level Changed
SSL-Vision Detection	70,921	1,304,200,680.333380937 (2011-04-30 14:58:00.333380937 PDT / 2011-04-30 21:58:00.333380937 GMT)	1,304,200,680.337352037 (2011-04-30 14:58:00.337352037 PDT / 2011-04-30 21:58:00.337352037 GMT)	1
SSL-Vision Ball	0	1	32	(-172.324, -344.732)	<OMITTED>	(523.656, 655.531)
SSL-Vision Robot	Y	0	0.951913	0	(1,255.21, -31.2292)	-0.103681	(459.879, 430.379)	140
SSL-Vision Detection	135,332	1,304,200,680.389489889 (2011-04-30 14:58:00.389489889 PDT / 2011-04-30 21:58:00.389489889 GMT)	1,304,200,680.391772985 (2011-04-30 14:58:00.391772985 PDT / 2011-04-30 21:58:00.391772985 GMT)	0
SSL-Vision Ball	0	1	19	(-203.885, -322.215)	<OMITTED>	(368.684, 437.579)
SSL-Vision Detection	70,922	1,304,200,680.392759084 (2011-04-30 14:58:00.392759084 PDT / 2011-04-30 21:58:00.392759084 GMT)	1,304,200,680.396861076 (2011-04-30 14:58:00.396861076 PDT / 2011-04-30 21:58:00.396861076 GMT)	1
SSL-Vision Ball	0	1	38	(-172.841, -347.326)	<OMITTED>	(524.079, 655.579)
SSL-Vision Robot	Y	0	0.951936	0	(1,255.25, -30.7333)	-0.103055	(459.792, 430.377)	140
SSL-Vision Detection	135,333	1,304,200,680.392121076 (2011-04-30 14:58:00.392121076 PDT / 2011-04-30 21:58:00.392121076 GMT)	1,304,200,680.399218082 (2011-04-30 14:58:00.399218082 PDT / 2011-04-30 21:58:00.399218082 GMT)	0
SSL-Vision Ball	0	1	17	(-203.328, -322.019)	<OMITTED>	(368.706, 437.647)
SSL-Vision Detection	135,334	1,304,200,680.409584999 (2011-04-30 14:58:00.409584999 PDT / 2011-04-30 21:58:00.409584999 GMT)	1,304,200,680.411849021 (2011-04-30 14:58:00.411849021 PDT / 2011-04-30 21:58:00.411849021 GMT)	0
SSL-Vision Ball	0	1	18	(-204.149, -321.496)	<OMITTED>	(368.778, 437.556)
SSL-Vision Detection	135,335	1,304,200,680.440948963 (2011-04-30 14:58:00.440948963 PDT / 2011-04-30 21:58:00.440948963 GMT)	1,304,200,680.443221092 (2011-04-30 14:58:00.443221092 PDT / 2011-04-30 21:58:00.443221092 GMT)	0
SSL-Vision Ball	0	1	17	(-203.328, -322.019)	<OMITTED>	(368.706, 437.647)
SSL-Vision Detection	70,923	1,304,200,680.452039957 (2011-04-30 14:58:00.452039957 PDT / 2011-04-30 21:58:00.452039957 GMT)	1,304,200,680.456034898 (2011-04-30 14:58:00.456034898 PDT / 2011-04-30 21:58:00.456034898 GMT)	1
SSL-Vision Ball	0	1	40	(-171.637, -346.89)	<OMITTED>	(524, 655.4)
SSL-Vision Robot	Y	0	0.95178	0	(1,260.71, -35.7861)	-0.100731	(460.621, 429.379)	140
SSL-Vision Detection	135,336	1,304,200,680.472321987 (2011-04-30 14:58:00.472321987 PDT / 2011-04-30 21:58:00.472321987 GMT)	1,304,200,680.474638938 (2011-04-30 14:58:00.474638938 PDT / 2011-04-30 21:58:00.474638938 GMT)	0
SSL-Vision Ball	0	1	22	(-207.253, -322.041)	<OMITTED>	(368.727, 437.182)
SSL-Vision Detection	135,337	1,304,200,680.503695964 (2011-04-30 14:58:00.503695964 PDT / 2011-04-30 21:58:00.503695964 GMT)	1,304,200,680.506109952 (2011-04-30 14:58:00.506109952 PDT / 2011-04-30 21:58:00.506109952 GMT)	0
SSL-Vision Ball	0	1	18	(-204.149, -321.496)	<OMITTED>	(368.778, 437.556)
SSL-Vision Detection	70,924	1,304,200,680.511392116 (2011-04-30 14:58:00.511392116 PDT / 2011-04-30 21:58:00.511392116 GMT)	1,304,200,680.515635967 (2011-04-30 14:58:00.515635967 PDT / 2011-04-30 21:58:00.515635967 GMT)	1
SSL-Vision Ball	0	1	33	(-173.212, -344.757)	<OMITTED>	(523.667, 655.667)
SSL-Vision Robot	Y	0	0.951969	0	(1,254.37, -30.3914)	-0.0964347	(459.741, 430.534)	140
SSL-Vision Detection	135,338	1,304,200,680.534934043 (2011-04-30 14:58:00.534934043 PDT / 2011-04-30 21:58:00.534934043 GMT)	1,304,200,680.537195920 (2011-04-30 14:58:00.537195920 PDT / 2011-04-30 21:58:00.537195920 GMT)	0
SSL-Vision Ball	0	1	17	(-203.328, -322.019)	<OMITTED>	(368.706, 437.647)
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
SSL-Vision Detection	135,527	1,304,200,686.460536003 (2011-04-30 14:58:06.460536003 PDT / 2011-04-30 21:58:06.460536003 GMT)	1,304,200,686.462800025 (2011-04-30 14:58:06.462800025 PDT / 2011-04-30 21:58:06.462800025 GMT)	0
SSL-Vision Ball	0	1	20	(-204.453, -323.291)	<OMITTED>	(368.55, 437.5)
SSL-Vision Detection	135,528	1,304,200,686.491902112 (2011-04-30 14:58:06.491902112 PDT / 2011-04-30 21:58:06.491902112 GMT)	1,304,200,686.494221925 (2011-04-30 14:58:06.494221925 PDT / 2011-04-30 21:58:06.494221925 GMT)	0
SSL-Vision Ball	0	1	18	(-204.149, -321.496)	<OMITTED>	(368.778, 437.556)
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
