UBC-Thunderbots/Electrical/controls/kalman-test-data/one-ball-rolling-across-both-cam-multiple-times.tsv

Start of Log
Backend	xbee
Parameter Changed	0	Backend/XBee/Loop Delay
Parameter Changed	80	Nav/Pivot/offset angle
Parameter Changed	0	Nav/Pivot/offset distance
Parameter Changed	30	Nav/Pivot/orientation offset
Parameter Changed	30	Nav/Pivot2/offset angle (degrees)
Parameter Changed	0.15	Nav/Pivot2/offset distance
Parameter Changed	30	Nav/Pivot2/orientation offset (degrees)
Parameter Changed	10	Nav/PivotAram/max acceleration
Parameter Changed	1	Nav/PivotAram/pivot radius
Parameter Changed	0.25	Nav/RRT/Buffer behind ball for chase (meters)
Parameter Changed	30	Nav/RRT/Chase angle range for behind target (degrees)
Parameter Changed	1	Nav/RRT/Chase ball uses target location to calculate dest
Parameter Changed	58	Nav/RRT/Pivot: offset angle (degrees)
Parameter Changed	0.13	Nav/RRT/Pivot: offset distance
Parameter Changed	14	Nav/RRT/Pivot: orientation offset (degrees)
Parameter Changed	0.05	Nav/Util/Buffer avoid ball tiny (meters)
Parameter Changed	0	Nav/Util/Buffer avoid defense area (meters)
Parameter Changed	0.1	Nav/Util/Buffer for equal priority friendly robot (meters)
Parameter Changed	0.2	Nav/Util/Buffer for higher priority friendly robot (meters)
Parameter Changed	0.1	Nav/Util/Buffer for lower priority friendly robot (meters)
Parameter Changed	0.1	Nav/Util/The amount of distance to maintain from enemy robots
Parameter Changed	1	oldAI/goalie dive for the ball
Parameter Changed	0.05	oldAI/goalie should ignore direction of ball
Parameter Changed	25	oldAI/Grid X size
Parameter Changed	25	oldAI/Grid Y size
Parameter Changed	40	oldAI/kickoff: angle to separate players (degrees)
Parameter Changed	0.3	oldAI/Lone goalie distance to goal post (m)
Parameter Changed	3	oldAI/max goalie dist from goal (robot radius)
Parameter Changed	1.1	oldAI/shrink robot radius
Parameter Changed	20	oldAI/stop: angle to separate players (degrees)
Parameter Changed	1	oldAI/Test strategy catch ball
Parameter Changed	1	oldAI/Test strategy Ram ball
Parameter Changed	1	oldAI/Test strategy recieve ball
Parameter Changed	1	oldAI/Test strategy stay own half
Parameter Changed	2	RC/Circle/amount to scale controller velocities by
Parameter Changed	3	RC/fuzzy2/max acc
Parameter Changed	1	RC/PID3/angle diff
Parameter Changed	25	RC/PID3/angle max vel
Parameter Changed	12	RC/PID3/angle prop
Parameter Changed	1.5	RC/PID3/angular slowdown when translating
Parameter Changed	0	RC/PID3/flip trans&ang slowdown (CARE)
Parameter Changed	1	RC/PID3/pid ratio
Parameter Changed	1	RC/PID3/reduce angular velocity when translating
Parameter Changed	0.81	RC/PID3/x to y ratio
Parameter Changed	1.5	RC/PID3/xy diff
Parameter Changed	5	RC/PID3/xy max acc
Parameter Changed	17	RC/PID3/xy max vel
Parameter Changed	12	RC/PID3/xy prop
Parameter Changed	3	STP/Action/block/block threshold distance in terms of robot radius
Parameter Changed	0.3	STP/Action/Goalie/Lone Goalie: distance to goal post (m)
Parameter Changed	20	STP/Action/shoot/Angle threshold (in degrees) that defines passing accuracy, smaller is more accurate
Parameter Changed	0.1	STP/Action/shoot/circle radius in front of robot to start pivoting (in meters)
Parameter Changed	0.1	STP/Action/shoot/Decay constant for the ball velocity
Parameter Changed	7.03	STP/Action/shoot/kicking speed for making a pass
Parameter Changed	0.8	STP/Action/shoot/reduced radius for calculating best shot (robot radius ratio)
Parameter Changed	0.5	STP/Action/spin/change in orientation every time tick for move spin
Parameter Changed	0	STP/defense/goalie hug switch
Parameter Changed	3	STP/defense/max goalie dist from goal (robot radius)
Parameter Changed	1.1	STP/defense/shrink robot radius
Parameter Changed	0.05	STP/evaluation/speed goalie should ignore direction of ball
Parameter Changed	1.1	STP/evaluation/Steal threshold: distance of ball from enemy (robot radius)
Parameter Changed	1	STP/offense/ball distance weight
Parameter Changed	4	STP/offense/enemy avoidance distance (robot radius)
Parameter Changed	25	STP/offense/grid x size
Parameter Changed	25	STP/offense/grid y size
Parameter Changed	1	STP/pass/ball goal distance weight
Parameter Changed	4	STP/pass/enemy avoidance distance (robot radius)
Parameter Changed	40	STP/play/kickoff: angle to separate players (degrees)
Parameter Changed	3	STP/predicates/enemy avoidance distance (robot radius)
Parameter Changed	20	STP/shoot/Shoot Accuracy (degrees)
Parameter Changed	1	STP/STP/Goalie is lowest index
Parameter Changed	0	STP/STP/Goalie pattern index
Parameter Changed	20	STP/Tactic/stop: angle to separate players (degrees)
Parameter Changed	20	STP/test_pass/ angle tolerance that the passer needs to be with respect to the passee
Parameter Changed	30	STP/test_pass/ angle tolerance that the passer needs to be with respect to the target
Parameter Changed	0.05	STP/test_pass/ distance tolerance that the passee needs to be with respect to the passer shot
Parameter Changed	0	STP/test_pass/passing target points
Parameter Changed	0.1	STP/test_pass/velocity to ignore
Parameter Changed	2	STP/util/distance for ball possesion (x ball radius)
Parameter Changed	2	STP/util/if dribble > this time, force shoot (sec)
Parameter Changed	1	STP/util/posses ball is has ball
Parameter Changed	10	STP/util/Shooting Accuracy General (degrees)
Parameter Changed	3	STP/util/time we can prepare during special plays (sec)
Friendly Colour Changed	Yellow
Ball Filter Changed
Robot Controller Changed
Play Type Changed	Halt
Team Scores	0	0
High Level Changed
SSL-Vision Detection	76,899	1,308,344,178.920841932 (2011-06-17 13:56:18.920841932 PDT / 2011-06-17 20:56:18.920841932 GMT)	1,308,344,178.922638893 (2011-06-17 13:56:18.922638893 PDT / 2011-06-17 20:56:18.922638893 GMT)	0
SSL-Vision Detection	41,245	1,308,344,178.923006057 (2011-06-17 13:56:18.923006057 PDT / 2011-06-17 20:56:18.923006057 GMT)	1,308,344,178.927051067 (2011-06-17 13:56:18.927051067 PDT / 2011-06-17 20:56:18.927051067 GMT)	1
SSL-Vision Detection	76,900	1,308,344,178.952081918 (2011-06-17 13:56:18.952081918 PDT / 2011-06-17 20:56:18.952081918 GMT)	1,308,344,178.953907966 (2011-06-17 13:56:18.953907966 PDT / 2011-06-17 20:56:18.953907966 GMT)	0
SSL-Vision Detection	76,901	1,308,344,178.983453035 (2011-06-17 13:56:18.983453035 PDT / 2011-06-17 20:56:18.983453035 GMT)	1,308,344,178.985416889 (2011-06-17 13:56:18.985416889 PDT / 2011-06-17 20:56:18.985416889 GMT)	0
SSL-Vision Detection	41,246	1,308,344,178.981596946 (2011-06-17 13:56:18.981596946 PDT / 2011-06-17 20:56:18.981596946 GMT)	1,308,344,178.985554933 (2011-06-17 13:56:18.985554933 PDT / 2011-06-17 20:56:18.985554933 GMT)	1
SSL-Vision Detection	76,902	1,308,344,179.014825105 (2011-06-17 13:56:19.014825105 PDT / 2011-06-17 20:56:19.014825105 GMT)	1,308,344,179.016591072 (2011-06-17 13:56:19.016591072 PDT / 2011-06-17 20:56:19.016591072 GMT)	0
SSL-Vision Detection	41,247	1,308,344,179.040957927 (2011-06-17 13:56:19.040957927 PDT / 2011-06-17 20:56:19.040957927 GMT)	1,308,344,179.046459913 (2011-06-17 13:56:19.046459913 PDT / 2011-06-17 20:56:19.046459913 GMT)	1
SSL-Vision Detection	76,903	1,308,344,179.046192884 (2011-06-17 13:56:19.046192884 PDT / 2011-06-17 20:56:19.046192884 GMT)	1,308,344,179.048882007 (2011-06-17 13:56:19.048882007 PDT / 2011-06-17 20:56:19.048882007 GMT)	0
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
SSL-Vision Detection	77,179	1,308,344,187.699143886 (2011-06-17 13:56:27.699143886 PDT / 2011-06-17 20:56:27.699143886 GMT)	1,308,344,187.701805114 (2011-06-17 13:56:27.701805114 PDT / 2011-06-17 20:56:27.701805114 GMT)	0
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
