UBC-Thunderbots/Electrical/controls/kalman-test-data/camera-and-kalman-ball-travel-across-the-field.jpg

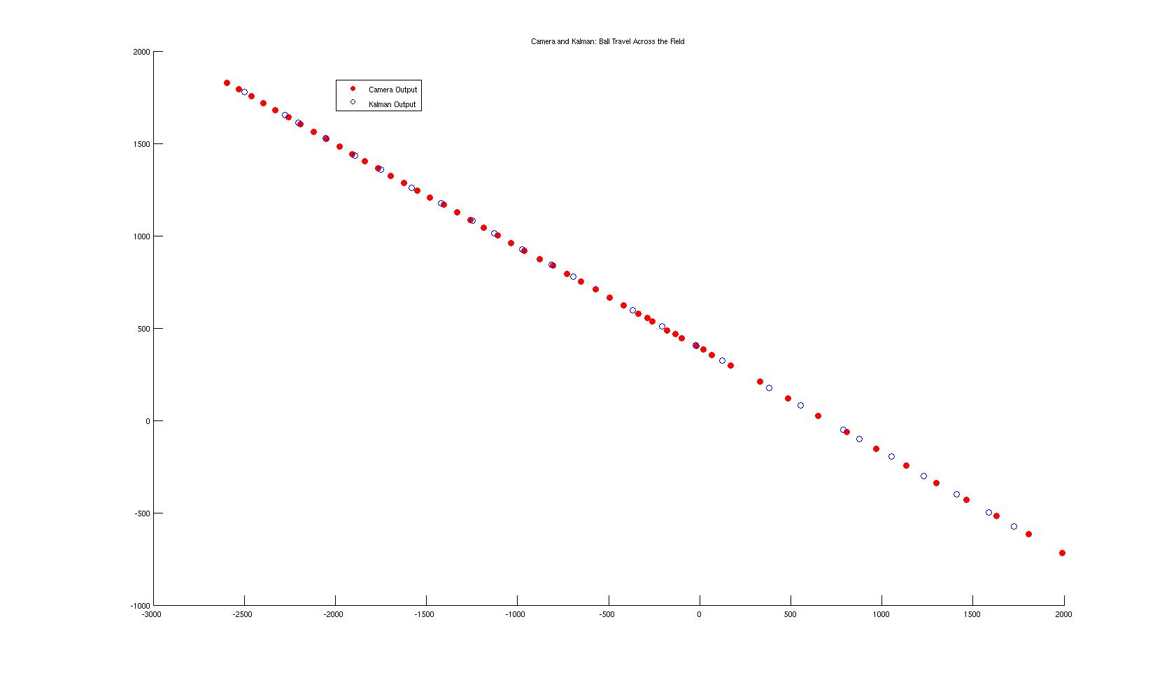
controls/kalman-test-data/camera-and-kalman-ball-travel-across-the-field.jpg
