UBC-Thunderbots/Electrical/electronics/HannahSawiuk-Altium/Thunderbots Quotation Q18051015.pdf

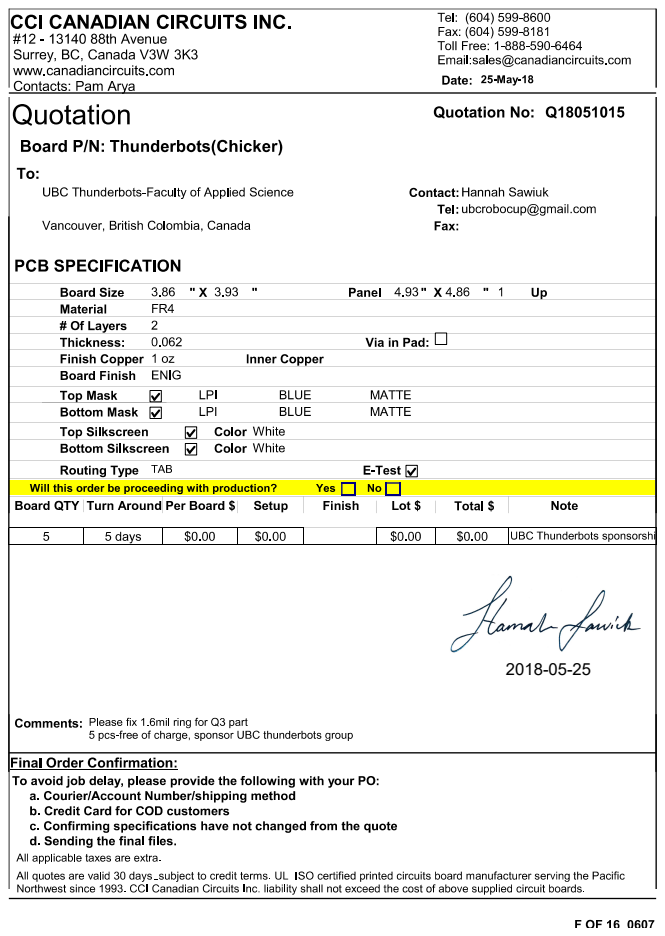
[picture p81: page 1]
