UBC-Thunderbots/Electrical/(list of files, drawings)

Other design files:
electronics/BenHers-Altium/01-27-2018/fpga.SchDoc
electronics/BenHers-Altium/01-27-2018/main.PrjPcb
electronics/BenHers-Altium/Dongle/Dongle/Dongle2.PcbDoc
electronics/BenHers-Altium/Dongle/Dongle/Dongle.PcbDoc
electronics/BenHers-Altium/Dongle/Dongle/Dongle.PrjPcb
electronics/BenHers-Altium/Dongle/Dongle/Dongle.SchDoc
electronics/BenHers-Altium/Dongle/Dongle/DongleCopy.PcbDoc
electronics/BenHers-Altium/MainBoard/main/A04882.SchLib
electronics/BenHers-Altium/MainBoard/main/breakoutconn.SchDoc
electronics/BenHers-Altium/MainBoard/main/chicker.SchDoc
electronics/BenHers-Altium/MainBoard/main/D_Schottky.SchLib
electronics/BenHers-Altium/MainBoard/main/dribblerconn.SchDoc
electronics/BenHers-Altium/MainBoard/main/fpga.SchDoc
electronics/BenHers-Altium/MainBoard/main/IMU.SchDoc
electronics/BenHers-Altium/MainBoard/main/main1/main.PcbLib
electronics/BenHers-Altium/MainBoard/main/main1/main.SCHLIB
electronics/BenHers-Altium/MainBoard/main/main.PcbDoc
electronics/BenHers-Altium/MainBoard/main/main.PrjPcb
electronics/BenHers-Altium/MainBoard/main/main.SchDoc
electronics/BenHers-Altium/MainBoard/main/microcontroller.SchDoc
electronics/BenHers-Altium/MainBoard/main/motordriver.SchDoc
electronics/BenHers-Altium/MainBoard/main/PianoSwitch.PcbLib
electronics/BenHers-Altium/MainBoard/main/PianoSwitch.SchLib
electronics/BenHers-Altium/MainBoard/main/Power.SchDoc
electronics/BenHers-Altium/MainBoard/main/sdcard.SchDoc
electronics/BenHers-Altium/MainBoard/main/SP3T_6pin.SchLib
electronics/BenHers-Altium/Projects/main/A04882.SchLib
electronics/BenHers-Altium/Projects/main/fpga.SchDoc
electronics/BenHers-Altium/Projects/main/IMU.SchDoc
electronics/BenHers-Altium/Projects/main/main.PrjPcb
electronics/BenHers-Altium/Projects/main/motordriver.SchDoc
electronics/BenHers-Altium/Projects/main/PianoSwitch.PcbLib
electronics/BenHers-Altium/StashingChanges/chicker.PcbDoc
electronics/BenHers-Altium/StashingChanges/chicker.SchDoc
electronics/HannahSawiuk-Altium/chicker.PcbDoc
electronics/HannahSawiuk-Altium/chicker.PrjPcb
electronics/HannahSawiuk-Altium/chicker.SchDoc
electronics/HannahSawiuk-Altium/Component libraries/Imported 74HC4050D_653.lia/74HC4050D_653.PcbLib
electronics/HannahSawiuk-Altium/Component libraries/Imported 74HC4050D_653.lia/74HC4050D_653.SchLib
electronics/HannahSawiuk-Altium/Component libraries/Imported 1206-C.lia/1206-C.PcbLib
electronics/HannahSawiuk-Altium/Component libraries/Imported 1206.lia/1206.PcbLib
electronics/HannahSawiuk-Altium/Component libraries/Imported CL31A226KOCLFNC/Imported CL31A226KOCLFNC.lia/CL31A226KOCLFNC.PcbLib
electronics/HannahSawiuk-Altium/Component libraries/Imported CL31A226KOCLFNC/Imported CL31A226KOCLFNC.lia/CL31A226KOCLFNC.SchLib
electronics/HannahSawiuk-Altium/Component libraries/Imported ECA-1HM101/Imported ECA-1HM101.lia/ECA-1HM101.PcbLib
electronics/HannahSawiuk-Altium/Component libraries/Imported ECA-1HM101/Imported ECA-1HM101.lia/ECA-1HM101.SchLib
electronics/HannahSawiuk-Altium/Component libraries/Imported F1206B3R00FWTR/Imported F1206B3R00FWTR.lia/F1206B3R00FWTR.PcbLib
electronics/HannahSawiuk-Altium/Component libraries/Imported F1206B3R00FWTR/Imported F1206B3R00FWTR.lia/F1206B3R00FWTR.SchLib
electronics/HannahSawiuk-Altium/Component libraries/Imported FDA69N25/Imported FDA69N25.lia/FDA69N25.PcbLib
electronics/HannahSawiuk-Altium/Component libraries/Imported FDA69N25/Imported FDA69N25.lia/FDA69N25.SchLib
electronics/HannahSawiuk-Altium/Component libraries/Imported IM03DGR.lia/IM03DGR.PcbLib
electronics/HannahSawiuk-Altium/Component libraries/Imported IM03DGR.lia/IM03DGR.SchLib
electronics/HannahSawiuk-Altium/Component libraries/Imported IRFP240/Imported IRFP240.lia/IRFP240.PcbLib
electronics/HannahSawiuk-Altium/Component libraries/Imported IRFP240/Imported IRFP240.lia/IRFP240.SchLib
electronics/HannahSawiuk-Altium/Component libraries/Imported PF2203-2KF1/MUR840.PcbLib
electronics/HannahSawiuk-Altium/Component libraries/Imported PF2203-2KF1/MUR840.SchLib
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
