UBC-Thunderbots/Electrical/electronics/robot/chicker/chicker.kicad_pcb

## KiCad design legacy/electronics/robot/chicker/chicker.kicad_pcb (2017-04-01, an earlier design)

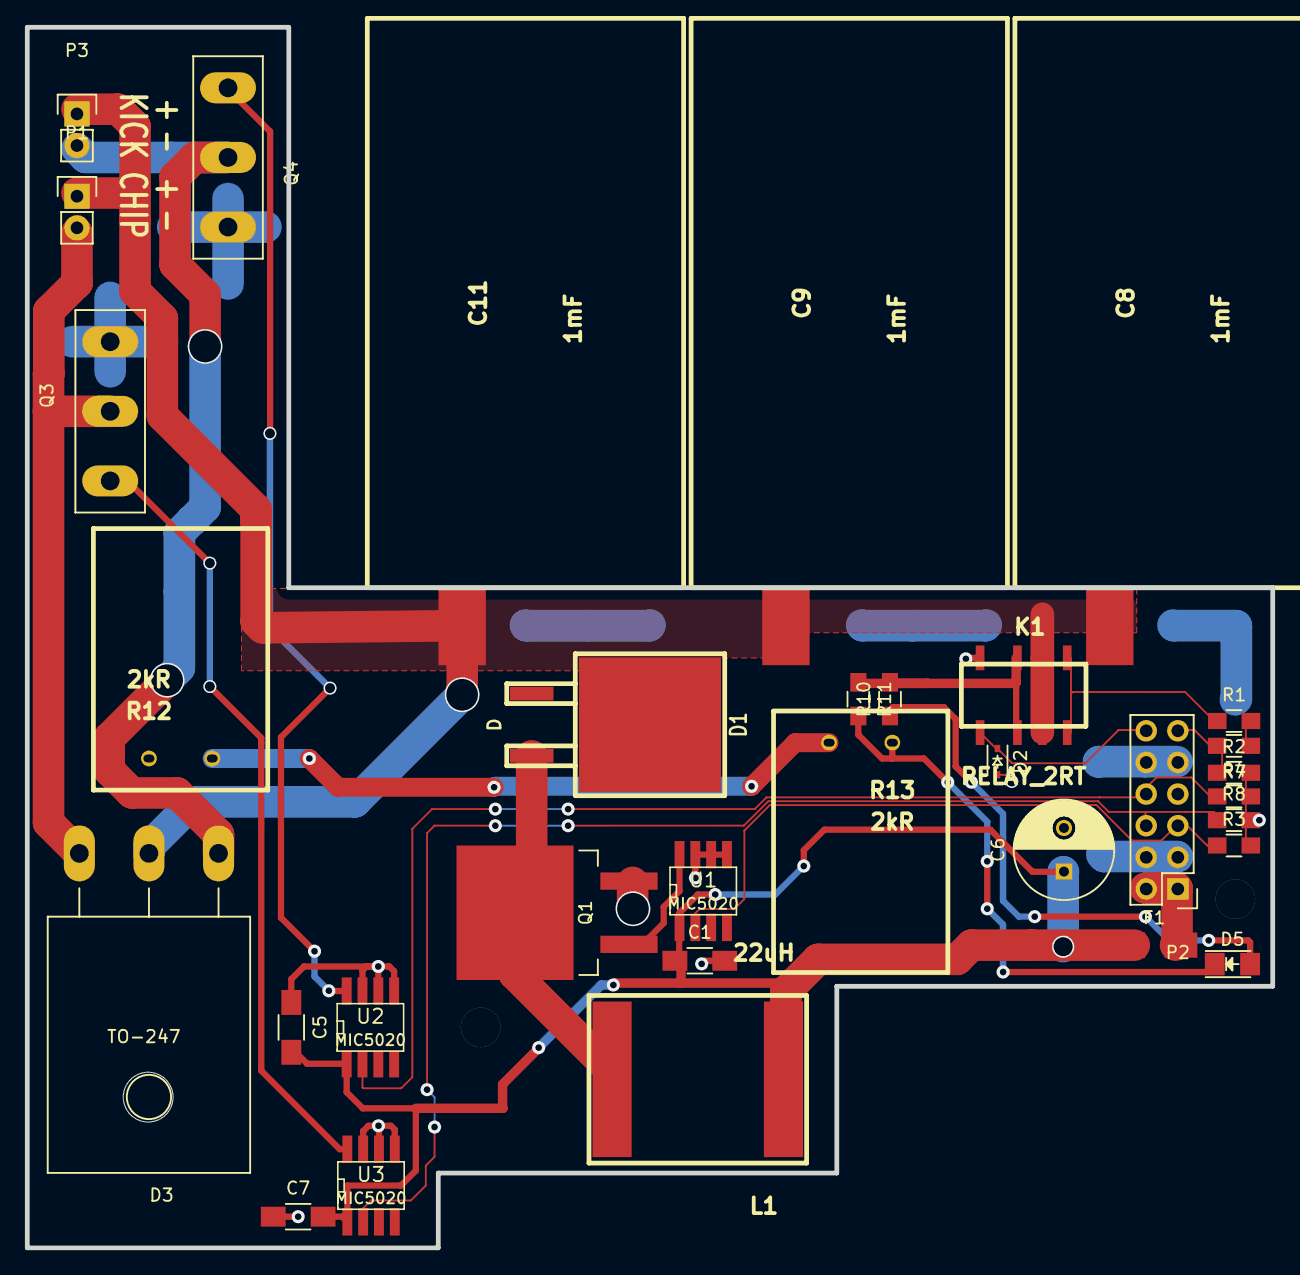
[picture p82: board chicker.kicad_pcb from above]

Board: 2 copper layers, 100.0 x 98.0 mm, 35 parts (0 on the bottom side), 21 nets.

Parts:
C1, C5, C7: 10uF; C_1206_HandSoldering
C6: 100uF; C_Radial_D8_L11.5_P3.5
C8, C9, C11: 1mF; ESMQ251VSN102MQ45S_HORIZONTAL
D1: D; D2PAK-DIODE-BACKWARDS
D2: D_Schottky; SOD-323
D3: RURG3060CC; TO-247_Horizontal_Neutral123
D5: RED; LED_1206
F1: 5A; Fuse_SMD1206_HandSoldering
K1: RELAY_2RT; PB1163CT-ND
L1: 22uH; SRP1770TA
M1, M2: 16mm; M3_MOUNT
P1, P3: CONN_01X02; Pin_Header_Straight_1x02
P2: CONN_02X06; Pin_Header_Straight_2x06
Q1: Q_NMOS_GSD; TO-263-2Lead
Q3, Q4: Q_NIGBT_GCE; TO-247_Vertical_Neutral123
R1, R7: 100kR; R_0805_HandSoldering
R2: 2.2kR; R_0805_HandSoldering
R3, R4, R8: 10kR; R_0805_HandSoldering
R10, R11: 160R; R_0805_HandSoldering
R12, R13: 2kR; PF2203
U1, U2, U3: MIC5020; SO8E

Connections:
+BATT: C1.1, C5.2, C6.1, C7.2, F1.1, L1.1, U1.1, U2.1, U3.1
/CAP+: C8.1, C9.1, C11.1, D1.1, D3.2, K1.5, K1.12, P1.1, P3.1
/CHARGE: P2.5, R3.1, U1.2
/CHARGE_MOSFET_DRAIN: D1.2, L1.2, Q1.3
/CHIP: P2.6, R8.1, U3.2
/Chip-: D3.3, P1.2, Q3.2
/KICK: P2.8, R4.1, U2.2
/Kick-: D3.1, P3.2, Q4.2
GND: C1.2, C5.1, C6.2, C7.1, C8.2, C9.2, C11.2, D2.2, K1.8, P2.3, P2.4, P2.7, P2.9, P2.10, Q1.2, Q3.3, Q4.3, R2.2, R3.2, R4.2, R8.2, R12.1, U1.5, U1.6, U1.7, U2.5, U2.6, U2.7, U3.5, U3.6, U3.7
unnamed: D2.1, K1.9, P2.12
unnamed: D5.1, R11.2, R13.1
unnamed: D5.2, R10.1
unnamed: F1.2, P2.1, P2.2
unnamed: K1.1, K1.16, R1.1
unnamed: K1.3, K1.14, R10.2, R11.1
unnamed: P2.11, R2.1, R7.2
unnamed: Q1.1, U1.8
unnamed: Q3.1, U3.8
unnamed: Q4.1, U2.8
unnamed: R1.2, R7.1
unnamed: R12.2, R13.2
