UBC-Thunderbots/Electrical/electronics/speedsensor/receiver/breakbeamreceiver.kicad_pcb

## KiCad design legacy/electronics/speedsensor/receiver/breakbeamreceiver.kicad_pcb (2017-01-15, an earlier design)

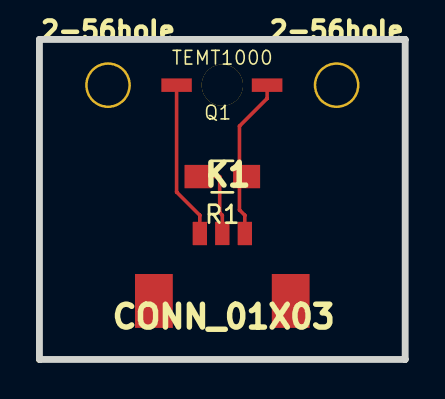
[picture p83: board breakbeamreceiver.kicad_pcb from above]

Board: 2 copper layers, 20.3 x 17.8 mm, 5 parts (0 on the bottom side), 3 nets.

Parts:
2-56hole, 2-56hole#2: P***; 2-56hole
K1: CONN_01X03; connector_0_49_in_3pin
Q1: TEMT1000; PHOTOTRANS-TEMT1000
R1: 100R; R_0805_HandSoldering

Connections:
/3.3v: K1.1, Q1.3
/GND: K1.2, R1.2
/SIG: K1.3, Q1.1, R1.1
