UBC-Thunderbots/Electrical/electronics/speedsensor/emitter/breakbeam.kicad_pcb

## KiCad design legacy/electronics/speedsensor/emitter/breakbeam.kicad_pcb (2017-01-15, an earlier design)

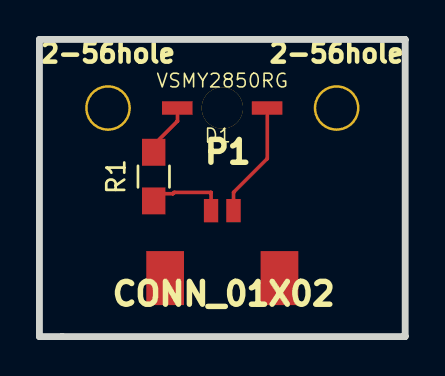
[picture p84: board breakbeam.kicad_pcb from above]

Board: 2 copper layers, 20.3 x 16.5 mm, 5 parts (0 on the bottom side), 3 nets.

Parts:
2-56hole, 2-56hole#2: P***; 2-56hole
D1: VSMY2850RG; LED-VSMY2850RG
P1: CONN_01X02; connector_0_49_in_2pin
R1: 16.5R; R_0805_HandSoldering

Connections:
/3.3v: P1.1, R1.1
/GND: D1.1, P1.2
unnamed: D1.2, R1.2
