UBC-Thunderbots/Electrical/electronics/speedsensor/processor/breakbeam-processor.kicad_pcb

## KiCad design legacy/electronics/speedsensor/processor/breakbeam-processor.kicad_pcb (2017-01-15, an earlier design)

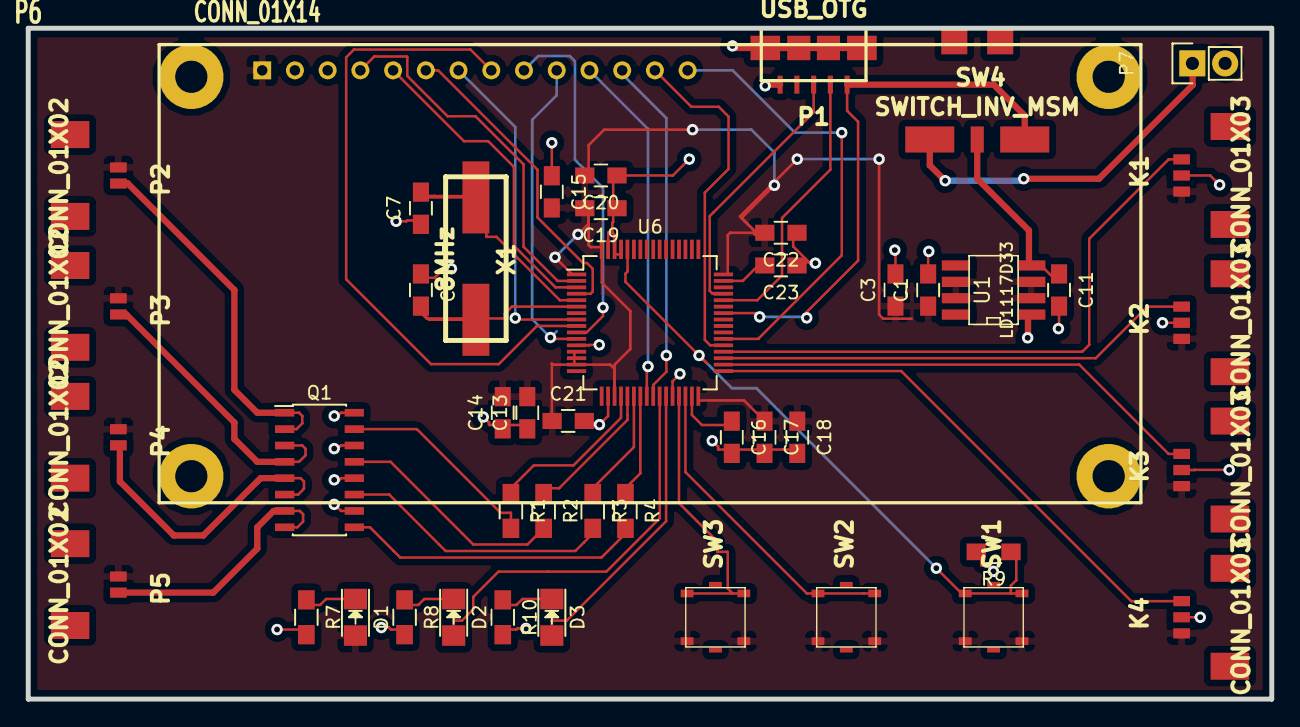
[picture p85: board breakbeam-processor.kicad_pcb from above]

Board: 2 copper layers, 96.5 x 52.1 mm, 46 parts (0 on the bottom side), 46 nets.

Parts:
C1, C16, C23: 2.2uF; C_0805_HandSoldering
C3, C15, C17, C20, C21, C22: 100nF; C_0805_HandSoldering
C7, C8: 15pF; C_0805_HandSoldering
C11, C13: 1uF; C_0805_HandSoldering
C14: 10nF; C_0805_HandSoldering
C18, C19: 4.7uF; C_0805_HandSoldering
D1: POWER_LED; LED_1206
D2: Green-LED; LED_1206
D3: green-LED; LED_1206
K1, K2, K3, K4: CONN_01X03; connector_0_49_in_3pin
P1: USB_OTG; USB_MICRO_B_SPEED_SENSOR
P2, P3, P4, P5: CONN_01X02; connector_0_49_in_2pin
P6: CONN_01X14; LCD_screen
P7: CONN_01X02; Pin_Header_Straight_1x02
Q1: MMPQ3904; SOIC-16_3.9x9.9mm_Pitch1.27mm
R1, R2, R3, R4, R7, R8, R10: R; R_0805_HandSoldering
R9: 1kR; R_0805_HandSoldering
SW1, SW2, SW3: SW_PUSH; SW_SMD_TAC
SW4: SWITCH_INV_MSM; SW_ROCKER_SP3T
U1: LD1117D33; SO8E
U6: STM32F405RXT; TQFP-64_10x10mm_Pitch0.5mm
X1: 8MHz; HC49US

Connections:
+3V3: C1.1, C3.1, C13.2, C14.2, C15.2, C17.1, C18.1, C19.2, C20.2, C21.1, C22.2, D1.2, K1.1, K2.1, K3.1, K4.1, P2.1, P3.1, P4.1, P5.1, P6.1, SW1.2, SW2.2, SW3.2, U1.2, U1.3, U1.6, U1.7, U6.1, U6.13, U6.14, U6.15, U6.19, U6.32, U6.48, U6.64
+5V: P1.1, SW4.3, U6.42
+BATT: P7.1, SW4.1
GND: C1.2, C3.2, C7.1, C8.1, C11.2, C13.1, C14.1, C15.1, C16.2, C17.2, C18.2, C19.1, C20.1, C21.2, C22.1, C23.1, K1.2, K2.2, K3.2, K4.2, P1.5, P1.6, P6.2, P7.2, Q1.10, Q1.12, Q1.14, Q1.16, R7.2, R8.2, R9.2, R10.2, U1.1, U6.12, U6.18, U6.28, U6.61, U6.62, U6.63
unnamed: C7.2, U6.5, X1.1
unnamed: C8.2, U6.6, X1.2
unnamed: C11.1, SW4.2, U1.4
unnamed: C16.1, U6.31
unnamed: C23.2, U6.47
unnamed: D1.1, R7.1
unnamed: D2.1, R8.1
unnamed: D2.2, U6.26
unnamed: D3.1, R10.1
unnamed: D3.2, U6.27
unnamed: K1.3, U6.36
unnamed: K2.3, U6.35
unnamed: K3.3, U6.34
unnamed: K4.3, U6.33
unnamed: P1.2, U6.44
unnamed: P1.3, U6.45
unnamed: P2.2, Q1.1, Q1.2
unnamed: P3.2, Q1.3, Q1.4
unnamed: P4.2, Q1.5, Q1.6
unnamed: P5.2, Q1.7, Q1.8
unnamed: P6.4, U6.2
unnamed: P6.5, U6.3
unnamed: P6.6, U6.4
unnamed: P6.7, U6.8
unnamed: P6.8, U6.9
unnamed: P6.9, U6.10
unnamed: P6.10, U6.11
unnamed: P6.11, U6.24
unnamed: P6.12, U6.25
unnamed: P6.13, U6.37
unnamed: P6.14, U6.38
unnamed: Q1.9, R4.2
unnamed: Q1.11, R3.2
unnamed: Q1.13, R2.2
unnamed: Q1.15, R1.2
unnamed: R1.1, U6.20
unnamed: R2.1, U6.21
unnamed: R3.1, U6.22
unnamed: R4.1, U6.23
unnamed: R9.1, SW1.1, U6.60
unnamed: SW2.1, U6.30
unnamed: SW3.1, U6.29
