UBC-Thunderbots/Electrical/electronics/robot/breakout/breakout.kicad_pcb

## KiCad design legacy/electronics/robot/breakout/breakout.kicad_pcb (2017-01-15, an earlier design)

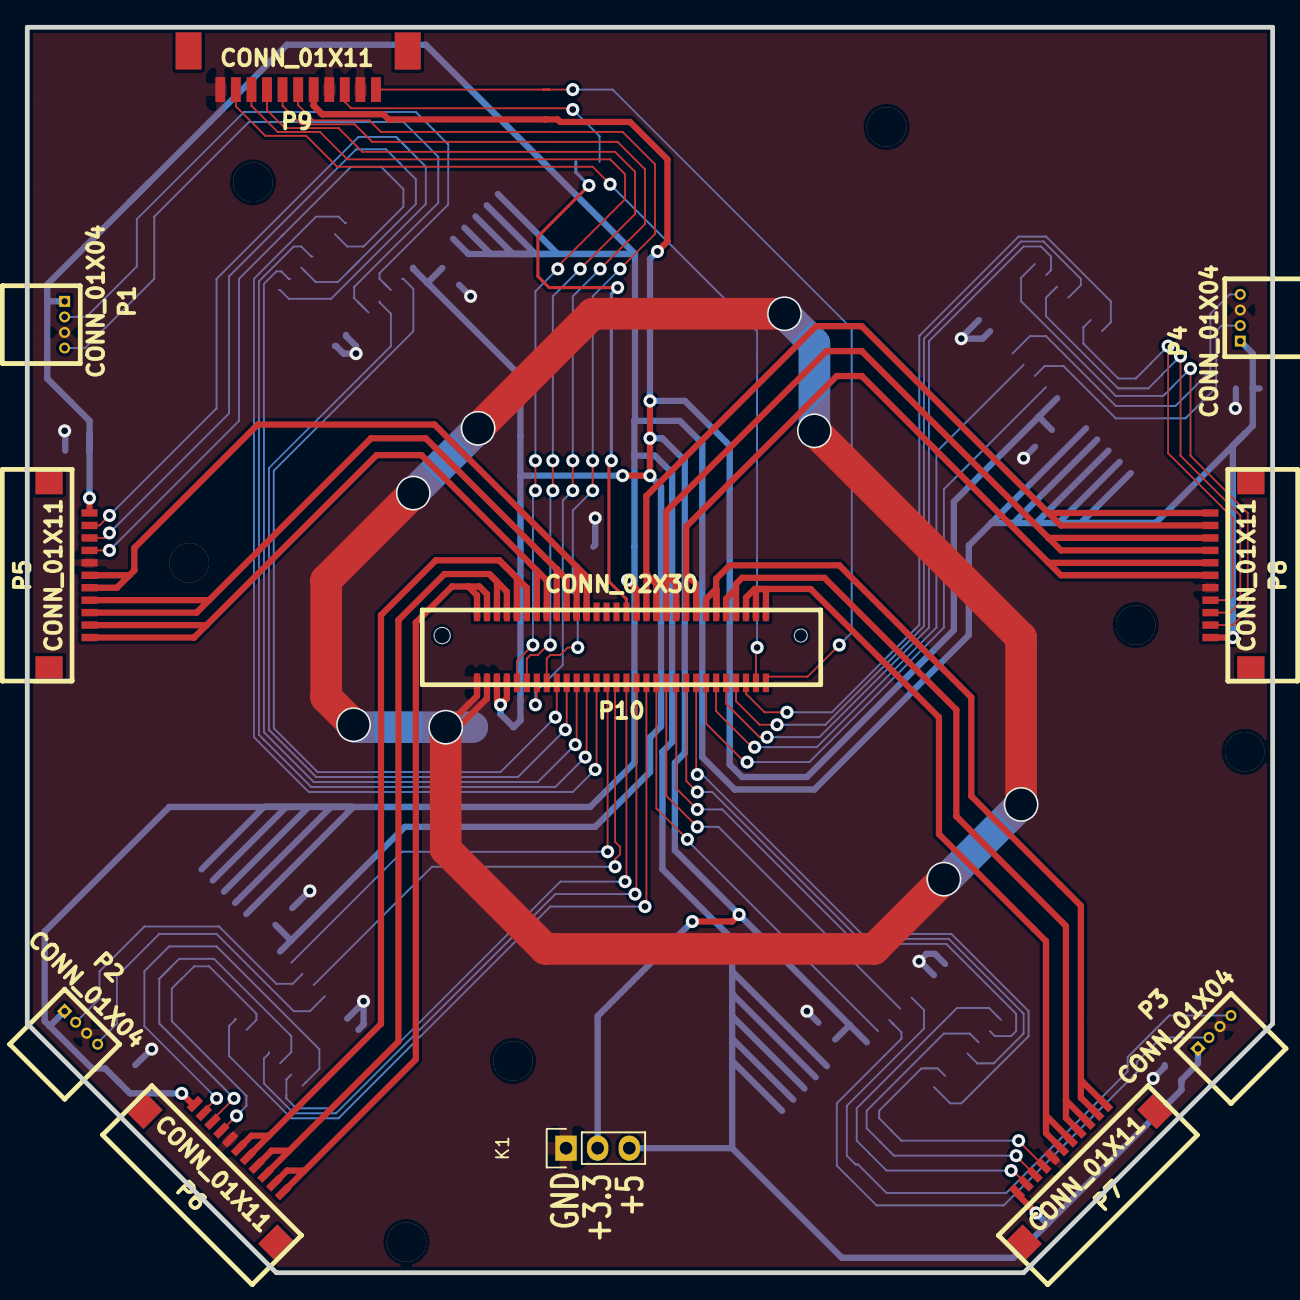
[picture p86: board breakout.kicad_pcb from above]

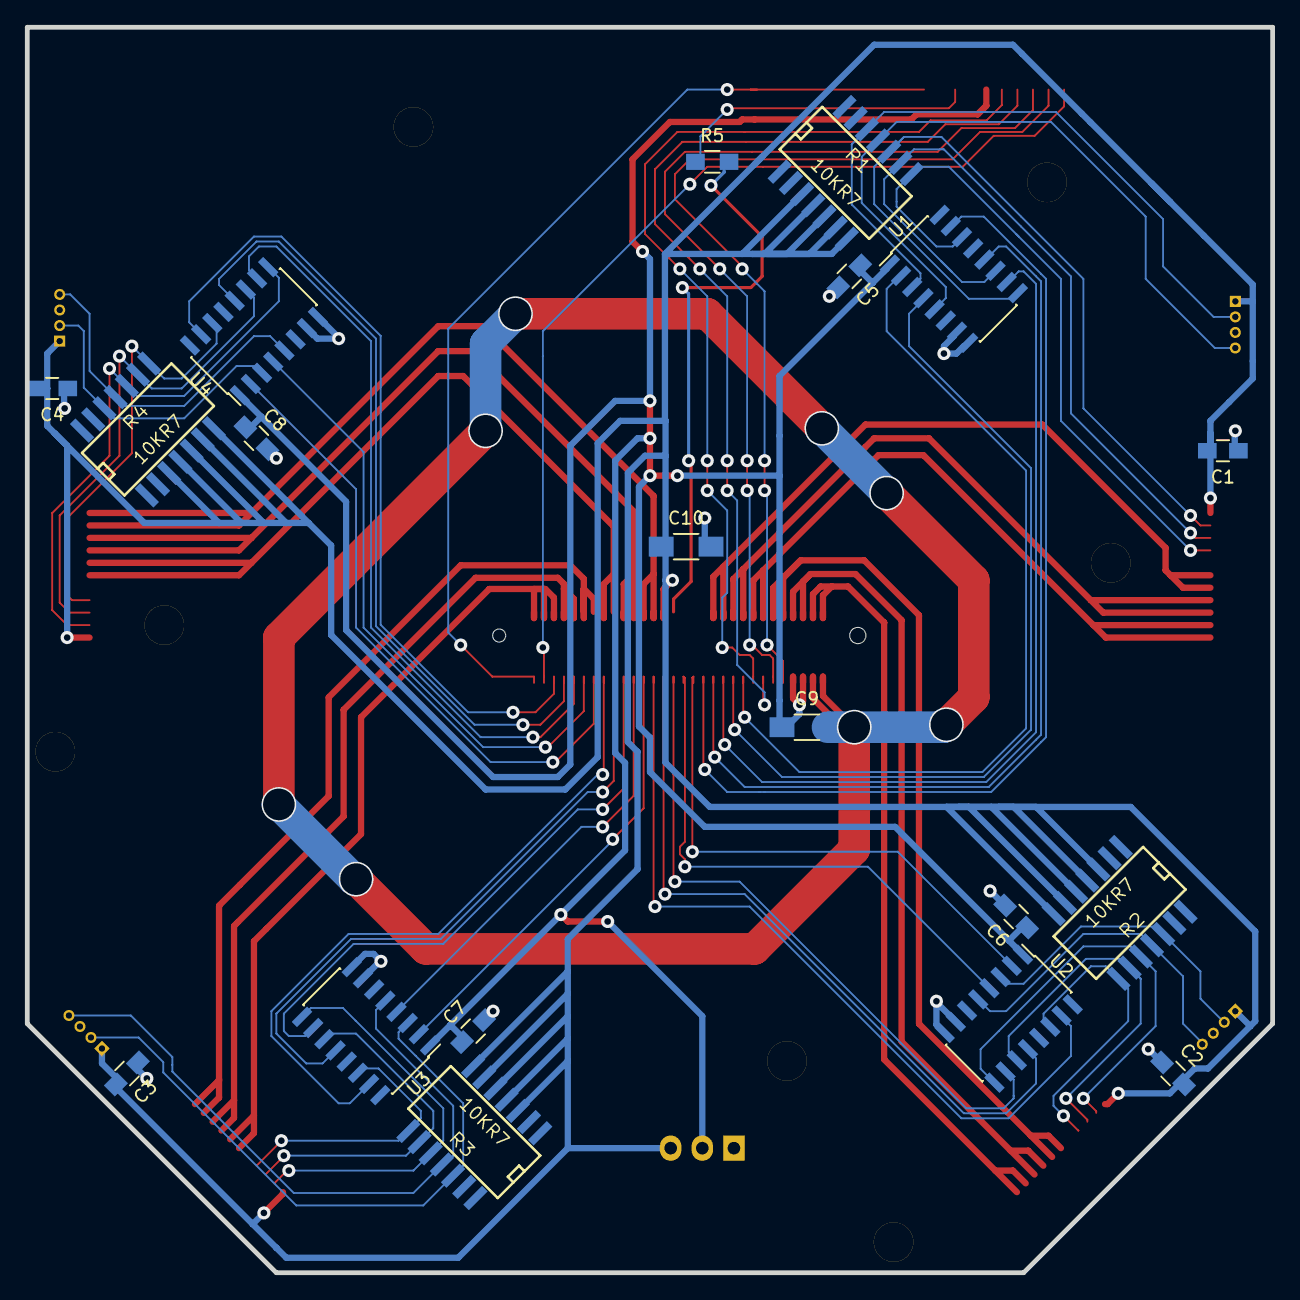
[picture p87: board breakout.kicad_pcb from below]

Board: 2 copper layers, 100.0 x 100.0 mm, 37 parts (19 on the bottom side), 63 nets.

Parts:
C1, C2, C3, C4, C5, C6, C7, C8: 100nF; C_0805_HandSoldering
C9, C10: 10uF; C_1206_HandSoldering
K1: CONN_01X03; Pin_Header_Straight_1x03
M1, M2, M3, M4, M5, M6, M7: 5mm; M3_MOUNT
P1, P2, P3, P4: CONN_01X04; 53048-0410
P5, P6, P7, P8: CONN_01X11; FH12-11S-1SH
P9: CONN_01X11; WM7629CT-ND
P10: CONN_02X30; FX6-60P-0.8SV
R1, R2, R3, R4: 10KR7; SO14HUGE
R5: 100R; R_0805_HandSoldering
U1, U2, U3, U4: 74HC4050; SOIC-16_3.9x9.9mm_Pitch1.27mm_HandSoldering

Connections:
+3V3: C5.1, C6.1, C7.1, C8.1, C9.1, K1.2, P9.5, P10.5, P10.7, U1.1, U2.1, U3.1, U4.1
+5V: C1.2, C2.2, C3.2, C4.2, C10.1, K1.3, P1.1, P2.1, P3.1, P4.1, P5.1, P6.1, P7.1, P8.1, P10.34, R1.3, R1.4, R1.5, R1.6, R1.7, R2.3, R2.4, R2.5, R2.6, R2.7, R3.3, R3.4, R3.5, R3.6, R3.7, R4.3, R4.4, R4.5, R4.6, R4.7
/M0_PHASE0: P5.10, P5.11, P10.14, P10.16
/M0_PHASE1: P5.8, P5.9, P10.18, P10.20
/M0_PHASE2: P5.6, P5.7, P10.22, P10.24
/M0_SENSOR0: P10.23, U1.12
/M0_SENSOR1: P10.25, U1.15
/M0_SENSOR2: P10.21, U1.10
/M0_SENSOR3: P10.17, U1.2
/M0_SENSOR4: P10.19, U1.4
/M1_PHASE0: P6.10, P6.11, P10.2, P10.4
/M1_PHASE1: P6.8, P6.9, P10.6, P10.8
/M1_PHASE2: P6.6, P6.7, P10.10, P10.12
/M1_SENSOR0: P10.33, U2.12
/M1_SENSOR1: P10.35, U2.15
/M1_SENSOR2: P10.31, U2.10
/M1_SENSOR3: P10.27, U2.2
/M1_SENSOR4: P10.29, U2.4
/M2_PHASE0: P7.10, P7.11, P10.48, P10.50
/M2_PHASE1: P7.8, P7.9, P10.52, P10.54
/M2_PHASE2: P7.6, P7.7, P10.56, P10.58, P10.60
/M2_SENSOR0: P10.43, U3.12
/M2_SENSOR1: P10.45, U3.15
/M2_SENSOR2: P10.41, U3.10
/M2_SENSOR3: P10.37, U3.2
/M2_SENSOR4: P10.39, U3.4
/M3_PHASE0: P8.10, P8.11, P10.36, P10.38
/M3_PHASE1: P8.8, P8.9, P10.40, P10.42
/M3_PHASE2: P8.6, P8.7, P10.44, P10.46
/M3_SENSOR0: P10.53, U4.12
/M3_SENSOR1: P10.55, U4.15
/M3_SENSOR2: P10.51, U4.10
/M3_SENSOR3: P10.47, U4.2
/M3_SENSOR4: P10.49, U4.4
GND: C1.1, C2.1, C3.1, C4.1, C5.2, C6.2, C7.2, C8.2, C9.2, C10.2, K1.1, P1.3, P2.3, P3.3, P4.3, P5.5, P6.5, P7.5, P8.5, P9.2, P9.4, P9.11, P10.1, P10.3, U1.7, U1.8, U2.7, U2.8, U3.7, U3.8, U4.7, U4.8
unnamed: P1.2, R1.12, U1.3
unnamed: P1.4, R1.11, U1.5
unnamed: P2.2, R2.12, U2.3
unnamed: P2.4, R2.11, U2.5
unnamed: P3.2, R3.12, U3.3
unnamed: P3.4, R3.11, U3.5
unnamed: P4.2, R4.12, U4.3
unnamed: P4.4, R4.11, U4.5
unnamed: P5.2, R1.10, U1.9
unnamed: P5.3, R1.9, U1.11
unnamed: P5.4, R1.8, U1.14
unnamed: P6.2, R2.10, U2.9
unnamed: P6.3, R2.9, U2.11
unnamed: P6.4, R2.8, U2.14
unnamed: P7.2, R3.10, U3.9
unnamed: P7.3, R3.9, U3.11
unnamed: P7.4, R3.8, U3.14
unnamed: P8.2, R4.10, U4.9
unnamed: P8.3, R4.9, U4.11
unnamed: P8.4, R4.8, U4.14
unnamed: P9.3, R5.1
unnamed: P9.9, P10.9
unnamed: P9.8, P10.11
unnamed: P9.7, P10.13
unnamed: P9.6, P10.15
unnamed: P10.32, R5.2
unnamed: P9.10, P10.57
unnamed: P9.1, P10.59
