UBC-Thunderbots/Electrical/electronics/dongle/dongle.kicad_pcb

## KiCad design legacy/electronics/dongle/dongle.kicad_pcb (2017-01-15, an earlier design)

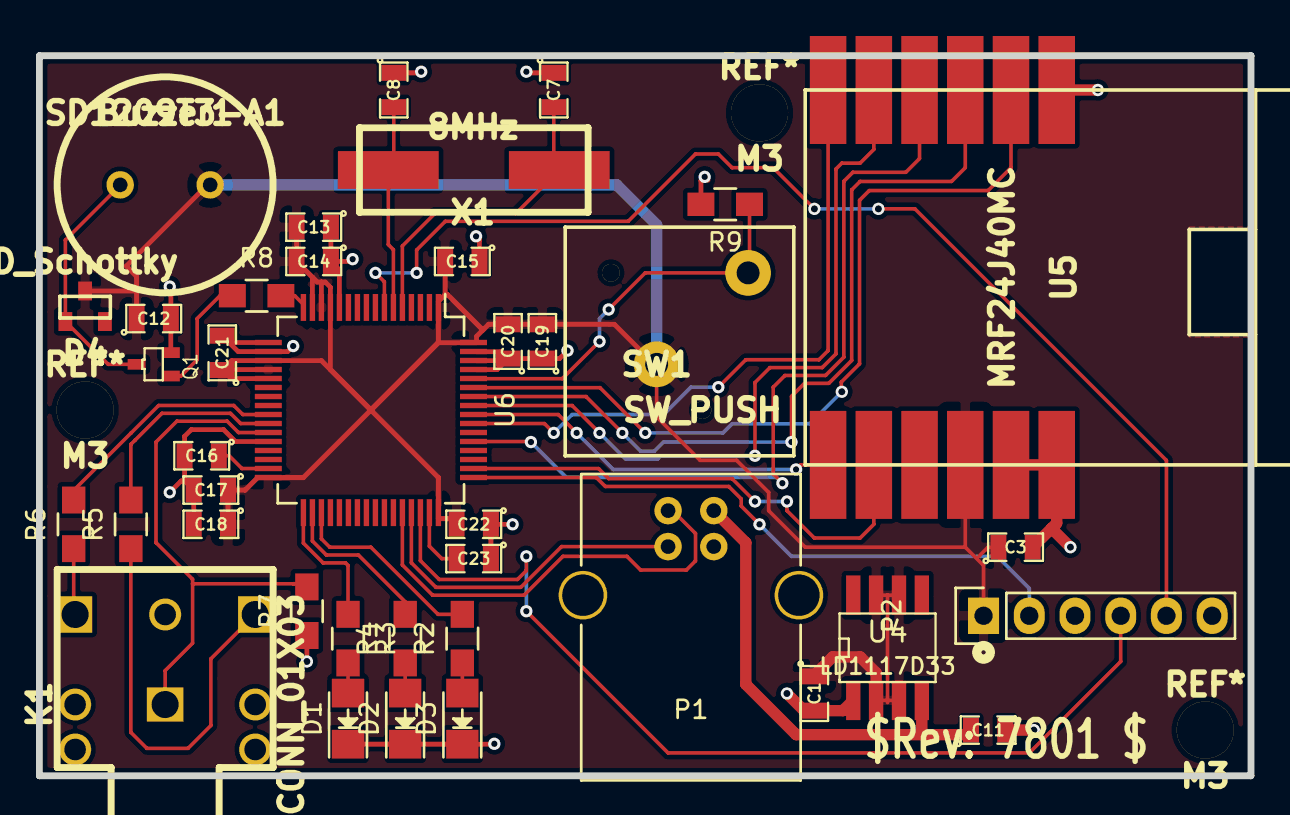
[picture p88: board dongle.kicad_pcb from above]

Board: 2 copper layers, 67.3 x 40.0 mm, 39 parts (0 on the bottom side), 34 nets.

Parts:
Buzzer1: SD1209T3-A1; Buzzer
C1, C16, C23: 2.2uF; SM0805
C3, C15, C17, C20, C21, C22: 100nF; SM0805
C7, C8: 15pF; SM0805
C11, C12, C13: 1uF; SM0805
C14: 10nF; SM0805
C18, C19: 4.7uF; SM0805
D1, D2, D3: LED; LED-1206
D4: D_Schottky; SOT23DIODE
K1: CONN_01X03; SJ1-3523N
P1: USB_B
P2: CONN_01X06; Pin_Header_Straight_1x06
Q1: BC847A; SOT323-transistor
R2, R3, R4, R5, R6: 100R; R_0805_HandSoldering
R7: 2.2kR; R_0805_HandSoldering
R8, R9: 1kR; R_0805_HandSoldering
SW1: SW_PUSH; ESWITCH_320.01
U4: LD1117D33; SO8E
U5: MRF24J40MC; MRF24J40M
U6: STM32F405RXT; TQFP-64_10x10mm_Pitch0.5mm
X1: 8MHz; HC49US

Connections:
+3V3: Buzzer1.1, C1.1, C3.1, C12.1, C13.2, C14.2, C15.2, C17.1, C18.1, C19.2, C20.2, C21.1, C22.2, D4.1, P2.1, SW1.2, U4.2, U4.3, U4.6, U4.7, U5.10, U6.1, U6.13, U6.14, U6.15, U6.19, U6.20, U6.21, U6.32, U6.48, U6.64
+5V: C11.1, P1.1, U4.4
/NRST: P2.5, U6.7
/SWCLK: P2.2, U6.49
/SWDIO: P2.4, U6.46
GND: C1.2, C3.2, C7.1, C8.1, C11.2, C12.2, C13.1, C14.1, C15.1, C16.2, C17.2, C18.2, C19.1, C20.1, C21.2, C22.1, C23.1, D1.1, D2.1, D3.1, P1.4, P1.5, P2.3, Q1.E, R7.1, R9.2, U4.1, U5.1, U5.11, U5.12, U6.12, U6.17, U6.18, U6.28, U6.61, U6.62, U6.63
unnamed: Buzzer1.2, D4.2, Q1.C
unnamed: C7.2, U6.5, X1.1
unnamed: C8.2, U6.6, X1.2
unnamed: C16.1, U6.31
unnamed: C23.2, U6.47
unnamed: D1.2, R3.2
unnamed: D2.2, R4.1
unnamed: D3.2, R2.1
unnamed: K1.1, R7.2, U6.27
unnamed: K1.2, R5.1
unnamed: K1.3, R6.1
unnamed: P1.2, U6.44
unnamed: P1.3, U6.45
unnamed: Q1.B, R8.1
unnamed: R2.2, U6.35
unnamed: R3.1, U6.33
unnamed: R4.2, U6.34
unnamed: R5.2, U6.26
unnamed: R6.2, U6.25
unnamed: R8.2, U6.16
unnamed: R9.1, SW1.1, U6.60
unnamed: U5.2, U6.59
unnamed: U5.3, U6.58
unnamed: U5.4, U6.53
unnamed: U5.5, U6.57
unnamed: U5.6, U6.55
unnamed: U5.7, U6.56
unnamed: U5.8, U6.50
