UBC-Thunderbots/Electrical/electronics/workshop_board/workshop_board.kicad_pcb

## KiCad design legacy/electronics/workshop_board/workshop_board.kicad_pcb (2017-01-15, an earlier design)

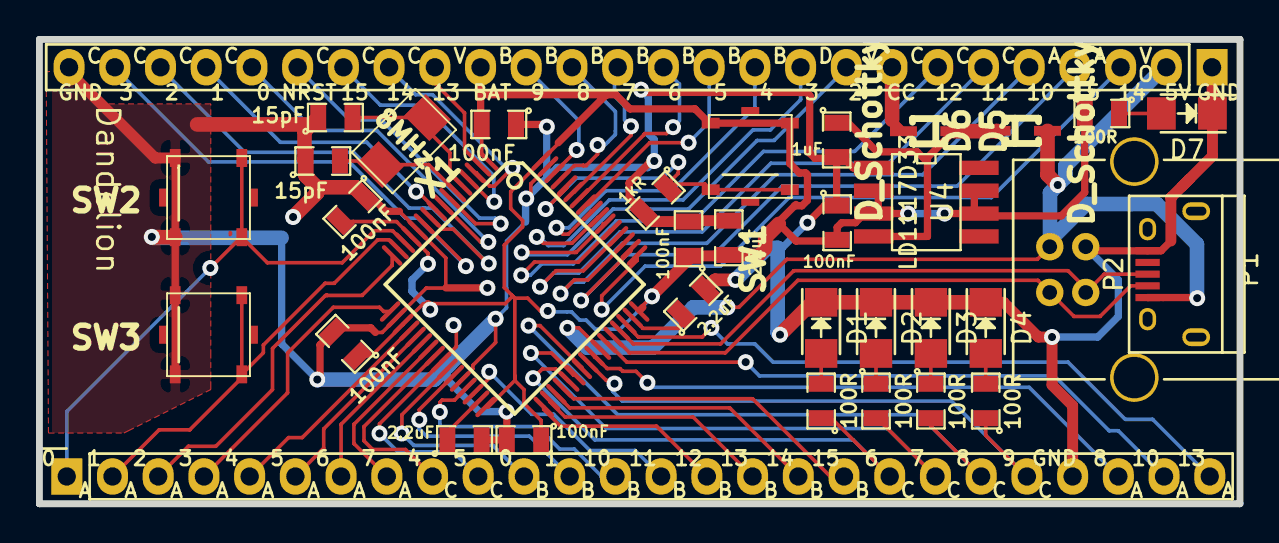
[picture p89: board workshop_board.kicad_pcb from above]

Board: 2 copper layers, 66.7 x 25.8 mm, 35 parts (0 on the bottom side), 63 nets.

Parts:
C1, C3, C4: 2.2uF; SM0805
C7, C8: 15pF; SM0805
C11: 1uF; SM0805
C13, C15, C17, C20, C21, C22: 100nF; SM0805
D1, D7: GRN; LED-1206
D2: YEL; LED-1206
D3: RED; LED-1206
D4: BLU; LED-1206
D5, D6: D_Schottky; SOD-323F
P1: USB_B
P2: USB_OTG; USB_Micro-B
R1, R2, R3, R4, R8: 100R; SM0805
R5: 1kR; SM0805
SW1, SW2, SW3: SW_PUSH; SW_SMD_TAC
U1: CONN_26_LEFT; Pin_Header_Straight_1x26
U2: STM32F405RXT_fat; TQFP_64
U3: CONN_26_RIGHT; Pin_Header_Straight_1x26
U4: LD1117D33; SO8E
X1: 8MHz; CRYSTAL_5x3.2

Connections:
+3V3: C1.1, C13.2, C15.2, C17.1, C20.2, C21.1, C22.1, R8.2, SW1.2, U1.17, U2.1, U2.13, U2.19, U2.32, U2.48, U2.64, U4.2, U4.3, U4.6, U4.7
+5V: D6.2, P1.1, P2.1, U1.2, U2.42
GND: C1.2, C3.2, C4.2, C7.1, C8.1, C11.2, C13.1, C15.1, C17.2, C20.1, C21.2, C22.2, D1.1, D2.1, D3.1, D4.1, D7.1, P1.4, P2.5, R5.2, SW2.1, SW3.1, U1.1, U1.26, U2.12, U2.18, U2.28, U2.63, U3.23, U4.1
unnamed: C3.1, U2.31
unnamed: C4.1, U2.47
unnamed: C7.2, U2.5, X1.1
unnamed: C8.2, U2.6, X1.2
unnamed: C11.1, D5.1, D6.1, U4.4
unnamed: D1.2, R1.2
unnamed: D2.2, R2.1
unnamed: D3.2, R3.1
unnamed: D4.2, R4.2
unnamed: D5.2, U1.8
unnamed: D7.2, R8.1
unnamed: P1.2, P2.2, U2.44
unnamed: P1.3, P2.3, U2.45
unnamed: R1.1, U2.37, U3.19
unnamed: R2.2, U2.38, U3.20
unnamed: R3.2, U2.39, U3.21
unnamed: R4.1, U2.40, U3.22
unnamed: R5.1, SW1.1, U2.60
unnamed: SW2.2, U2.14, U3.1
unnamed: SW3.2, U2.15, U3.2
unnamed: U1.3, U2.49
unnamed: U1.4, U2.50
unnamed: U1.5, U2.51
unnamed: U1.6, U2.52
unnamed: U1.7, U2.53
unnamed: U1.9, U2.54
unnamed: U1.10, U2.55
unnamed: U1.11, U2.56
unnamed: U1.12, U2.57
unnamed: U1.13, U2.58
unnamed: U1.14, U2.59
unnamed: U1.15, U2.61
unnamed: U1.16, U2.62
unnamed: U1.18, U2.2
unnamed: U1.19, U2.3
unnamed: U1.20, U2.4
unnamed: U1.21, U2.7
unnamed: U1.22, U2.8
unnamed: U1.23, U2.9
unnamed: U1.24, U2.10
unnamed: U1.25, U2.11
unnamed: U2.16, U3.3
unnamed: U2.17, U3.4
unnamed: U2.20, U3.5
unnamed: U2.21, U3.6
unnamed: U2.22, U3.7
unnamed: U2.23, U3.8
unnamed: U2.24, U3.9
unnamed: U2.25, U3.10
unnamed: U2.26, U3.11
unnamed: U2.27, U3.12
unnamed: U2.29, U3.13
unnamed: U2.30, U3.14
unnamed: U2.33, U3.15
unnamed: U2.34, U3.16
unnamed: U2.35, U3.17
unnamed: U2.36, U3.18
unnamed: U2.41, U3.24
unnamed: U2.43, U3.25
unnamed: U2.46, U3.26
