UBC-Thunderbots/Electrical/electronics/robot/main/main.kicad_pcb

## KiCad design legacy/electronics/robot/main/main.kicad_pcb (2017-06-04, an earlier design)

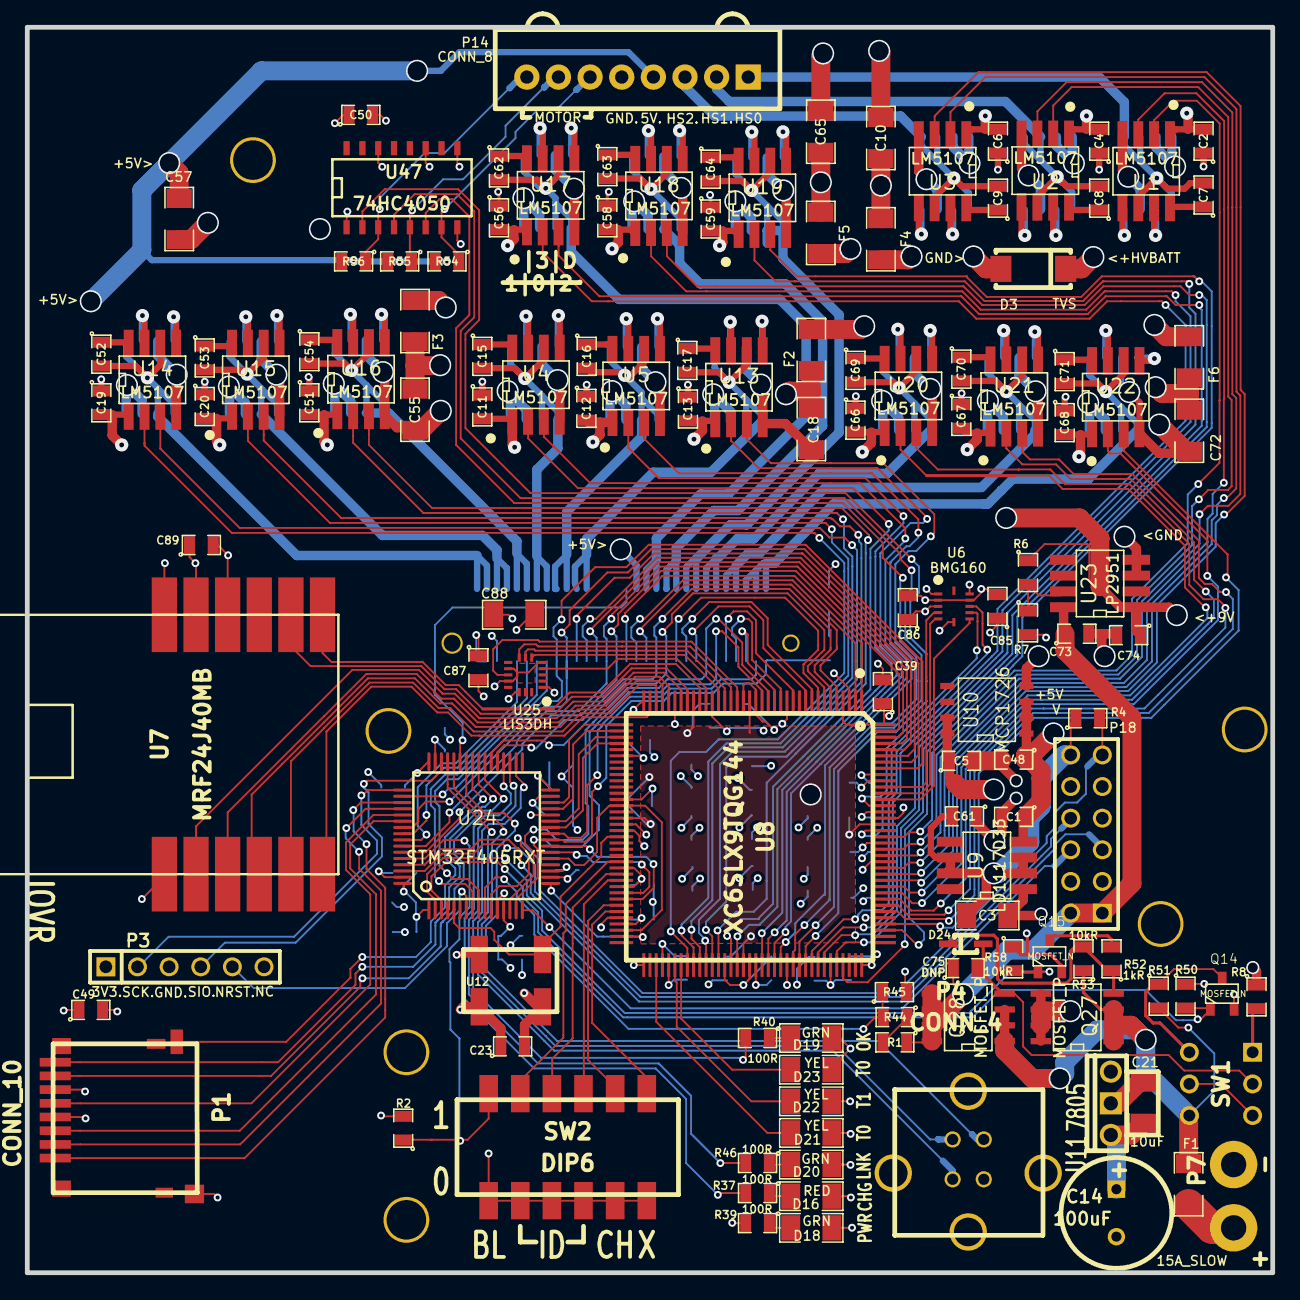
[picture p90: board main.kicad_pcb from above]

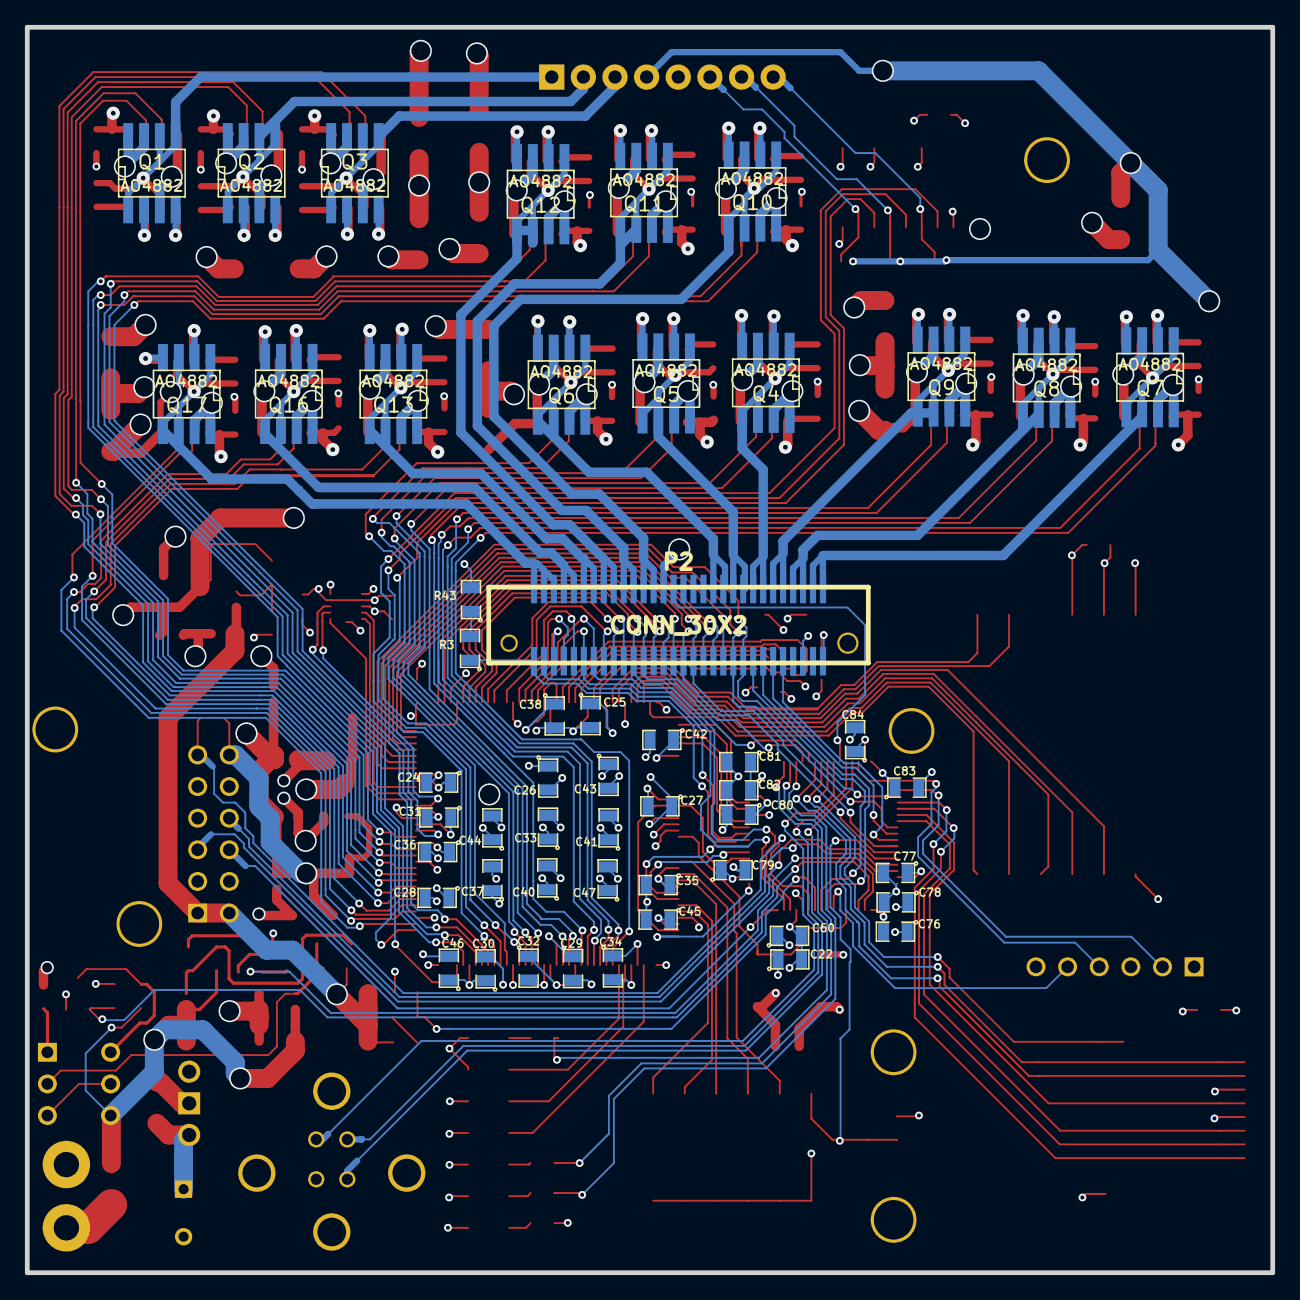
[picture p91: board main.kicad_pcb from below]

Board: 4 copper layers, 100.0 x 100.0 mm, 186 parts (52 on the bottom side), 210 nets.

Parts:
C1, C2, C4, C6, C7, C8, C9, C11, C12, C13, C15, C16, C17, C19, C20, C22, C23, C49, C50, C51, C52, C53, C54, C56, C58, C59, C61, C62, C63, C64, C66, C67, C68, C69, C70, C71, C76, C77, C79, C81, C83, C85, C86, C87, C89: 100nF; SM0805
C3, C10, C18, C21, C55, C57, C65, C72, C88: 10uF; SM1206
C5, C48, C73, C74, C75: 1uF; SM0805
C14: 100uF; C1.5V8V
C24, C25, C26, C27, C28, C29, C30, C32, C33, C34, C35, C37, C39, C41, C78, C82: 4.7uF; SM0805
C31, C36, C38, C40, C42, C43, C44, C45, C46, C47: 470nF; SM0805
C60: 10nF; SM0805
C80, C84: 2.2uF; SM0805
D3: TVS; DO-214AC
D16: RED; SM1206
D18, D19, D20: GRN; SM1206
D21, D22, D23: YEL; SM1206
D24: DIODESCH; SOD-323F
F1: 15A_SLOW; SM1206
F2, F3, F4, F5, F6: 5A; SM1206
M1, M2, M3: 5mm; M3_MOUNT
M4, M5, M6: 16mm; M3_MOUNT
P1: CONN_10; 114-00841-68
P2: CONN_30X2; FX6-60S-0.8SV
P3: CONN_6; PIN_ARRAY-6X1
P4: CONN_4; USB_B_V
P7: CONN_2; BATTERY_INLET
P14: CONN_8; EC16
P18: CONN_12; pin_array_6x2
Q1, Q2, Q3, Q4, Q5, Q6, Q7, Q8, Q9, Q10, Q11, Q12, Q13, Q16, Q17: AO4882; SO8E
Q14, Q15: MOSFET_N; SOT23_3GDS
Q27, Q28: MOSFET_P; SO8E-IRF9310
R1, R44, R50, R51, R53, R54, R55, R56, R58: 10kR; SM0805
R2, R7, R52: 1kR; SM0805
R3, R37, R39, R40, R43, R46: 100R; SM0805
R4: 100kR; SM0805
R6: 6kR; SM0805
R8: 1MR; SM0805
R45: 2.2kR; SM0805
SW1: SP3T; A27xP
SW2: DIP6; 219-6MST
U1, U2, U3, U4, U5, U13, U14, U15, U16, U17, U18, U19, U20, U21, U22: LM5107; SO8E
U6: BMG160; LGA12
U7: MRF24J40MB; MRF24J40M
U8: XC6SLX9TQG144; TQFP144
U9: LD1117D33; SO8E
U10: MCP1726; SO8N
U11: 7805; LM78XX_VERT
U12: ECS-3953M
U23: LP2951; SO8E
U24: STM32F405RXT; TQFP_64
U25: LIS3DH; LGA16
U47: 74HC4050; SO16N

Connections:
+1.2V: C5.1, C25.1, C27.1, C29.1, C31.1, U8.19, U8.28, U8.52, U8.89, U8.128, U10.7, U10.8
+3.3V: C3.1, C22.2, C23.1, C24.1, C26.1, C28.1, C30.1, C32.1, C33.1, C34.1, C35.1, C36.1, C37.1, C38.1, C39.1, C40.1, C41.1, C42.1, C43.1, C44.1, C45.1, C46.1, C47.1, C49.1, C50.1, C60.2, C61.2, C76.2, C77.2, C78.2, C79.2, C81.1, C82.1, C83.1, C85.2, C86.2, C87.2, C88.2, C89.2, P1.4, P1.9, P2.5, P3.1, P18.12, R4.1, R39.2, R43.2, SW2.1, SW2.2, SW2.3, SW2.4, SW2.5, SW2.6, U6.2, U6.10, U7.10, U8.4, U8.18, U8.20, U8.31, U8.36, U8.42, U8.53, U8.60, U8.63, U8.69, U8.76, U8.86, U8.90, U8.103, U8.122, U8.125, U8.129, U8.135, U8.144, U9.2, U9.3, U9.6, U9.7, U12.1, U12.4, U24.1, U24.13, U24.19, U24.32, U24.48, U24.64, U25.1, U25.14, U47.1
+5V: C1.1, C48.1, C57.2, P2.34, P14.4, R54.2, R55.2, R56.2, U9.4, U10.1, U10.2, U10.3, U11.VO
+9V: C2.2, C4.2, C6.2, C11.2, C12.2, C13.2, C19.2, C20.2, C51.2, C56.2, C58.2, C59.2, C66.2, C67.2, C68.2, C74.1, R6.1, U1.1, U2.1, U3.1, U4.1, U5.1, U13.1, U14.1, U15.1, U16.1, U17.1, U18.1, U19.1, U20.1, U21.1, U22.1, U23.1
+BATT: C14.1, C21.1, C73.1, C75.1, P18.1, P18.2, Q28.D, R1.1, U11.VI, U23.8
+HVBATT: D3.2, F2.1, F3.1, F4.1, F5.1, F6.1, Q27.D
/breakoutconn/BB_SENSOR: P2.59, R3.1, U24.24
/breakoutconn/LASER_DRIVE: P2.32, U24.43
/breakoutconn/LPS_DRIVE0: P2.15, U24.9
/breakoutconn/LPS_DRIVE1: P2.13, U24.8
/breakoutconn/LPS_DRIVE2: P2.11, U24.56
/breakoutconn/LPS_DRIVE3: P2.9, U24.57
/breakoutconn/LPS_SENSOR: P2.57, U24.25
/breakoutconn/M0_ENCODER0: P2.17, U8.137, U24.50
/breakoutconn/M0_ENCODER1: P2.19, U8.138, U24.55
/breakoutconn/M0_HALL0: P2.23, U8.140
/breakoutconn/M0_HALL1: P2.25, U8.141
/breakoutconn/M0_HALL2: P2.21, U8.139
/breakoutconn/M1_ENCODER0: P2.27, U8.142, U24.58
/breakoutconn/M1_ENCODER1: P2.29, U8.143, U24.59
/breakoutconn/M1_HALL0: P2.33, U8.2
/breakoutconn/M1_HALL1: P2.35, U8.5
/breakoutconn/M1_HALL2: P2.31, U8.1
/breakoutconn/M2_ENCODER0: P2.37, U8.6, U24.37
/breakoutconn/M2_ENCODER1: P2.39, U8.7, U24.38
/breakoutconn/M2_HALL0: P2.43, U8.9
/breakoutconn/M2_HALL1: P2.45, U8.10
/breakoutconn/M2_HALL2: P2.41, U8.8
/breakoutconn/M3_ENCODER0: P2.47, U8.16, U24.14
/breakoutconn/M3_ENCODER1: P2.49, U8.17, U24.15
/breakoutconn/M3_HALL0: P2.53, U8.14
/breakoutconn/M3_HALL1: P2.55, U8.15
/breakoutconn/M3_HALL2: P2.51, U8.12
/chicker/CHARGE: P18.5, U24.61
/fpga//MRF_CS: U7.8, U8.29
/fpga//MRF_RESET: U7.2, U8.30
/fpga/ACCEL_CLK: U8.26, U25.4
/fpga/ACCEL_INT: U8.21, U25.11
/fpga/ACCEL_MISO: U8.23, U25.7
/fpga/ACCEL_MOSI: U8.24, U25.6
/fpga/DONE: U8.71, U24.17
/fpga/GYRO_CLK: U6.7, U8.132
/fpga/GYRO_INT: U6.4, U8.134
/fpga/GYRO_MISO: U6.8, U8.131
/fpga/GYRO_MOSI: U6.9, U8.127
/fpga/ICB_CLK: U8.50, U8.70, U24.21
/fpga/ICB_IRQ: U8.40, U24.26
/fpga/ICB_MISO: U8.64, U24.22
/fpga/ICB_MOSI: U8.65, U24.23
/fpga/INIT_B: U8.39, U24.27
/fpga/LED_T0: D21.1, U8.75
/fpga/LED_T1: D22.1, U8.78
/fpga/LED_T2: D23.1, U8.79
/fpga/M4_HALL0: U8.97, U47.6
/fpga/M4_HALL1: U8.98, U47.4
/fpga/M4_HALL2: U8.99, U47.2
/fpga/MRF_CLK: U7.6, U8.35
/fpga/MRF_INT: U7.4, U8.33
/fpga/MRF_MISO: U7.7, U8.27
/fpga/MRF_MOSI: U7.5, U8.34
/fpga/MRF_WAKE: U7.3, U8.32
/fpga/OSC: U8.55, U12.3, U24.5
/fpga/PROG_B: U8.37, U24.30
/fpga/SW1: SW2.11, U8.59
/fpga/SW2: SW2.10, U8.61
/fpga/SW3: SW2.9, U8.62
/fpga/SW4: SW2.8, U8.66
/fpga/SW5: SW2.7, U8.67
/fpga/~ACCEL_CS: U8.22, U25.8
/fpga/~GYRO_CS: U6.5, U8.133
/fpga/~ICB_CS: U8.38, U24.29
/microcontroller/BATTERY: R44.2, R45.1, U24.10
/microcontroller/BOOT0: R2.1, SW2.12, U24.60
/microcontroller/CHICKER_CHIP: P18.6, U24.16
/microcontroller/CHICKER_KICK: P18.8, U24.62
/microcontroller/CHICKER_VOLTAGE: P18.11, R4.2, U24.11
/microcontroller/HV_PWR: Q15.G, R58.2, U24.2
/microcontroller/LED_C: R37.2, U24.36
/microcontroller/LED_L: R46.2, U24.35
/microcontroller/LED_S: R40.2, U24.34
/microcontroller/LOGIC_PWR: Q14.G, R50.2, U24.3
/microcontroller/NRST: P3.5, U24.7
/microcontroller/SD_CD: P1.10, U24.41
/microcontroller/SD_CK: P1.5, U24.53
/microcontroller/SD_CMD: P1.3, U24.54
/microcontroller/SD_D0: P1.7, U24.39
/microcontroller/SD_D1: P1.8, U24.40
/microcontroller/SD_D2: P1.1, U24.51
/microcontroller/SD_D3: P1.2, U24.52
/microcontroller/SWDCK: P3.2, U24.49
/microcontroller/SWDIO: P3.4, U24.46
/microcontroller/USB_DM: P4.2, U24.44
/microcontroller/USB_DP: P4.3, U24.45
/microcontroller/USB_VBUS: P4.1, U24.42
/microcontroller/VCAP1: C80.1, U24.31
/microcontroller/VCAP2: C84.1, U24.47
/motordriver0/HB0: C15.1, U4.8
/motordriver0/HB1: C16.1, U5.8
/motordriver0/HB2: C17.1, U13.8
/motordriver0/HG0: Q4.2, U4.7
/motordriver0/HG1: Q5.2, U5.7
/motordriver0/HG2: Q6.2, U13.7
/motordriver0/HIGH0: U4.2, U8.87
/motordriver0/HIGH1: U5.2, U8.88
/motordriver0/HIGH2: U8.92, U13.2
/motordriver0/HS0: C15.2, P2.14, P2.16, Q4.1, Q4.5, Q4.6, U4.6
/motordriver0/HS1: C16.2, P2.18, P2.20, Q5.1, Q5.5, Q5.6, U5.6
/motordriver0/HS2: C17.2, P2.22, P2.24, Q6.1, Q6.5, Q6.6, U13.6
/motordriver0/HV_BATT_F: C18.1, F2.2, Q4.7, Q4.8, Q5.7, Q5.8, Q6.7, Q6.8
/motordriver0/LG0: Q4.4, U4.5
/motordriver0/LG1: Q5.4, U5.5
/motordriver0/LG2: Q6.4, U13.5
/motordriver0/LOW0: U4.3, U8.93
/motordriver0/LOW1: U5.3, U8.94
/motordriver0/LOW2: U8.95, U13.3
/motordriver1/HB0: C52.1, U14.8
/motordriver1/HB1: C53.1, U15.8
/motordriver1/HB2: C54.1, U16.8
/motordriver1/HG0: Q7.2, U14.7
/motordriver1/HG1: Q8.2, U15.7
/motordriver1/HG2: Q9.2, U16.7
/motordriver1/HIGH0: U8.80, U14.2
/motordriver1/HIGH1: U8.81, U15.2
/motordriver1/HIGH2: U8.82, U16.2
/motordriver1/HS0: C52.2, P2.2, P2.4, Q7.1, Q7.5, Q7.6, U14.6
/motordriver1/HS1: C53.2, P2.6, P2.8, Q8.1, Q8.5, Q8.6, U15.6
/motordriver1/HS2: C54.2, P2.10, P2.12, Q9.1, Q9.5, Q9.6, U16.6
/motordriver1/HV_BATT_F: C55.1, F3.2, Q7.7, Q7.8, Q8.7, Q8.8, Q9.7, Q9.8
/motordriver1/LG0: Q7.4, U14.5
/motordriver1/LG1: Q8.4, U15.5
/motordriver1/LG2: Q9.4, U16.5
/motordriver1/LOW0: U8.83, U14.3
/motordriver1/LOW1: U8.84, U15.3
/motordriver1/LOW2: U8.85, U16.3
/motordriver2/HB0: C69.1, U20.8
/motordriver2/HB1: C70.1, U21.8
/motordriver2/HB2: C71.1, U22.8
/motordriver2/HG0: Q13.2, U20.7
/motordriver2/HG1: Q16.2, U21.7
/motordriver2/HG2: Q17.2, U22.7
/motordriver2/HIGH0: U8.118, U20.2
/motordriver2/HIGH1: U8.117, U21.2
/motordriver2/HIGH2: U8.116, U22.2
/motordriver2/HS0: C69.2, P2.48, P2.50, Q13.1, Q13.5, Q13.6, U20.6
/motordriver2/HS1: C70.2, P2.52, P2.54, Q16.1, Q16.5, Q16.6, U21.6
/motordriver2/HS2: C71.2, P2.56, P2.58, P2.60, Q17.1, Q17.5, Q17.6, U22.6
/motordriver2/HV_BATT_F: C72.1, F6.2, Q13.7, Q13.8, Q16.7, Q16.8, Q17.7, Q17.8
/motordriver2/LG0: Q13.4, U20.5
/motordriver2/LG1: Q16.4, U21.5
/motordriver2/LG2: Q17.4, U22.5
/motordriver2/LOW0: U8.115, U20.3
/motordriver2/LOW1: U8.114, U21.3
/motordriver2/LOW2: U8.112, U22.3
/motordriver3/HB0: C62.1, U17.8
/motordriver3/HB1: C63.1, U18.8
/motordriver3/HB2: C64.1, U19.8
/motordriver3/HG0: Q10.2, U17.7
/motordriver3/HG1: Q11.2, U18.7
/motordriver3/HG2: Q12.2, U19.7
/motordriver3/HIGH0: U8.100, U17.2
/motordriver3/HIGH1: U8.101, U18.2
/motordriver3/HIGH2: U8.102, U19.2
/motordriver3/HS0: C62.2, P2.36, P2.38, Q10.1, Q10.5, Q10.6, U17.6
/motordriver3/HS1: C63.2, P2.40, P2.42, Q11.1, Q11.5, Q11.6, U18.6
/motordriver3/HS2: C64.2, P2.44, P2.46, Q12.1, Q12.5, Q12.6, U19.6
/motordriver3/HV_BATT_F: C65.1, F5.2, Q10.7, Q10.8, Q11.7, Q11.8, Q12.7, Q12.8
/motordriver3/LG0: Q10.4, U17.5
/motordriver3/LG1: Q11.4, U18.5
/motordriver3/LG2: Q12.4, U19.5
/motordriver3/LOW0: U8.104, U17.3
/motordriver3/LOW1: U8.105, U18.3
/motordriver3/LOW2: U8.111, U19.3
/motordriver4/HB0: C7.1, U1.8
/motordriver4/HB1: C8.1, U2.8
/motordriver4/HB2: C9.1, U3.8
/motordriver4/HG0: Q1.2, U1.7
/motordriver4/HG1: Q2.2, U2.7
/motordriver4/HG2: Q3.2, U3.7
/motordriver4/HIGH0: U1.2, U8.126
/motordriver4/HIGH1: U2.2, U8.124
/motordriver4/HIGH2: U3.2, U8.123
/motordriver4/HS0: C7.2, P14.1, Q1.1, Q1.5, Q1.6, U1.6
/motordriver4/HS1: C8.2, P14.2, Q2.1, Q2.5, Q2.6, U2.6
/motordriver4/HS2: C9.2, P14.3, Q3.1, Q3.5, Q3.6, U3.6
/motordriver4/HV_BATT_F: C10.1, F4.2, Q1.7, Q1.8, Q2.7, Q2.8, Q3.7, Q3.8
/motordriver4/LG0: Q1.4, U1.5
/motordriver4/LG1: Q2.4, U2.5
/motordriver4/LG2: Q3.4, U3.5
/motordriver4/LOW0: U1.3, U8.121
/motordriver4/LOW1: U2.3, U8.120
/motordriver4/LOW2: U3.3, U8.119
/power/FUSE_IN: F1.1, P7.1
/power/FUSE_OUT: F1.2, Q27.S, Q28.S, R51.2, R53.1, SW1.6
GND: C1.2, C2.1, C3.2, C4.1, C5.2, C6.1, C10.2, C11.1, C12.1, C13.1, C14.2, C18.2, C19.1, C20.1, C21.2, C22.1, C23.2, C24.2, C25.2, C26.2, C27.2, C28.2, C29.2, C30.2, C31.2, C32.2, C33.2, C34.2, C35.2, C36.2, C37.2, C38.2, C39.2, C40.2, C41.2, C42.2, C43.2, C44.2, C45.2, C46.2, C47.2, C48.2, C49.2, C50.2, C51.1, C55.2, C56.1, C57.1, C58.1, C59.1, C60.1, C61.1, C65.2, C66.1, C67.1, C68.1, C72.2, C73.2, C74.2, C76.1, C77.1, C78.1, C79.1, C80.2, C81.2, C82.2, C83.2, C84.2, C85.1, C86.1, C87.1, C88.1, C89.1, D3.1, D16.2, D18.2, D19.2, D20.2, D21.2, D22.2, D23.2, P1.6, P2.1, P2.3, P3.3, P4.4, P7.2, P14.5, P18.3, P18.4, P18.9, P18.10, Q1.3, Q2.3, Q3.3, Q4.3, Q5.3, Q6.3, Q7.3, Q8.3, Q9.3, Q10.3, Q11.3, Q12.3, Q13.3, Q14.S, Q15.S, Q16.3, Q17.3, R2.2, R7.2, R8.1, R45.2, R50.1, R58.1, U1.4, U2.4, U3.4, U4.4, U5.4, U6.1, U6.3, U6.6, U6.11, U7.1, U7.11, U7.12, U8.3, U8.13, U8.25, U8.49, U8.54, U8.68, U8.73, U8.77, U8.91, U8.96, U8.108, U8.113, U8.130, U8.136, U9.1, U10.4, U11.GND, U12.2, U13.4, U14.4, U15.4, U16.4, U17.4, U18.4, U19.4, U20.4, U21.4, U22.4, U23.3, U23.4, U24.12, U24.18, U24.28, U24.63, U25.5, U25.10, U25.12, U47.8, U47.9, U47.11, U47.14
unnamed: R1.2, R44.1
unnamed: R3.2, R43.1
unnamed: R8.2, SW1.1
unnamed: D24.2, Q27.G, R52.1, R53.2
unnamed: R6.2, R7.1, U23.7
unnamed: Q15.D, R52.2
unnamed: SW1.3, SW1.5
unnamed: Q14.D, R51.1, SW1.4
unnamed: D18.1, R39.1
unnamed: C75.2, D24.1, Q28.G, SW1.2
unnamed: P14.8, R56.1, U47.3
unnamed: P14.6, R54.1, U47.7
unnamed: P14.7, R55.1, U47.5
unnamed: D19.1, R40.1
unnamed: D16.1, R37.1
unnamed: D20.1, R46.1
