UBC-Thunderbots/Electrical/electronics/robot/breakout/breakout.sch

## KiCad design electronics/robot/breakout/breakout.sch (2017-01-15, an earlier design)

Schematic: breakout.sch

Parts:
C9, C10: 10uF
K1: CONN_3; Digi-Key Part 3M9468-ND
M1, M2, M3, M4, M5, M6, M7: 5mm; Digi-Key Part 952-1496-ND
P9: CONN_11; Digi-Key Part WM7629CT-ND
P10: CONN_30X2; Digi-Key Part H10787-ND
R5: 100R

Notes on the sheet:
Up to Main Board:
Down to Midplate:
LPS3
LPS2
LPS1
LPS0
LPS sensor
BB laser
BB sensor
