UBC-Thunderbots/Electrical/electronics/robot/breakout/wheelconn.sch

## KiCad design electronics/robot/breakout/wheelconn.sch (2017-01-15, an earlier design)

Schematic: wheelconn.sch

Parts:
C1, C5: 100nF
P1: CONN_4; 53048-0410; Digi-Key Part WM1744-ND
P5: CONN_11; FH12-11S-1SH
R1: 10KR7
U1: 74HC4050; SO16N
