UBC-Thunderbots/Electrical/electronics/robot/chicker/chicker.sch

## KiCad design electronics/robot/chicker/chicker.sch (2017-07-02, an earlier design)

Schematic: chicker.sch

Parts:
C1, C5, C7: 10uF
C6: 100uF
C8, C9, C10, C11: 1mF
D1: DIODE
D2: DIODESCH; Digi-Key Part NSR0240HT1GOSCT-ND
D3: RURG3060CC; TO247
F1: 5A; Digi-Key Part F1460CT-ND
K1: RELAY_2RT; Digi-Key Part PB1163CT-ND
L1: 22uH; Digi-Key Part none
M1, M2, M3: 16mm; Digi-Key Part none
P1, P3: CONN_2; Digi-Key Part WM4300-ND
P2: CONN_12; Digi-Key Part S7074-ND
Q1: MOS_N
Q3, Q4: IGBT_N
R1, R7: 100kR
R2: 2.2kR
R3, R4, R8: 10kR
R5, R6: 68R; Digi-Key Part A103646CT-ND
U1, U2, U3: MIC5020; SO8E; Digi-Key Part 576-1818-5-ND

Notes on the sheet:
Down to Main Board:
