UBC-Thunderbots/Electrical/electronics/robot/dribbler_harness/dribbler_harness.sch

## KiCad design electronics/robot/dribbler_harness/dribbler_harness.sch (2017-01-15, an earlier design)

Schematic: dribbler_harness.sch

Parts:
D1: LED; Digi-Key Part 365-1145-ND
P1: CONN_11; Digi-Key Part dribbler-harness-to-breakout-board
P2: CONN_7; Digi-Key Part dribbler-harness-to-lps
Q1: PHOTOTRANSISTOR; Digi-Key Part 475-1419-ND

Notes on the sheet:
Components for the harness are ordered with breakout board. In dribbler-harness-connector-and-components multi-part.
LPS ground
LPS sensor
LPS3
LPS2
LPS1
LPS0
LPS +3.3V
To Lateral Position Sensor
To Mainboard
