UBC-Thunderbots/Electrical/electronics/robot/lateral_sensor/lateral_sensor.sch

## KiCad design electronics/robot/lateral_sensor/lateral_sensor.sch (2014-11-08)

Schematic: lateral_sensor.sch

Parts:
C1: 10uF
P1: CONN_7; Digi-Key Part WM7610CT-ND
R1: 88R
R2: 5R
R3, R4, R5, R6: 100R
U1: MIC7300; Digi-Key Part 576-1319-1-ND
U3, U5, U7, U9: OPB733TR; Digi-Key Part 365-1510-1-ND
