UBC-Thunderbots/Electrical/electronics/robot/main/chicker.sch

## KiCad design electronics/robot/main/chicker.sch (2017-01-15, an earlier design)

Schematic: chicker.sch

Parts:
P18: CONN_12; Digi-Key Part 952-1366-5-ND
R4: 100kR

Notes on the sheet:
RELAY
~PRESENT
