UBC-Thunderbots/Electrical/electronics/robot/main/dribblerconn.sch

## KiCad design electronics/robot/main/dribblerconn.sch (2017-04-01, an earlier design)

Schematic: dribblerconn.sch

Parts:
C50: 100nF
C57: 10uF
P14: CONN_8; EC16; Digi-Key Part 609-3321-ND
R54, R55, R56: 10kR
U47: 74HC4050; SO16L
