UBC-Thunderbots/Electrical/electronics/robot/main/fpga.sch

## KiCad design electronics/robot/main/fpga.sch (2017-01-15, an earlier design)

Schematic: fpga.sch

Parts:
C24, C25, C26, C27, C28, C29, C30, C32, C33, C34, C35, C37, C39, C41: 4.7uF
C31, C36, C38, C40, C42, C43, C44, C45, C46, C47: 470nF
D21, D22, D23: YEL
SW2: DIP6
U8: XC6SLX9TQG144; TQFP144

Notes on the sheet:
Test0
Test2
Test1
