UBC-Thunderbots/Electrical/electronics/robot/main/imu.sch

## KiCad design electronics/robot/main/imu.sch (2017-01-15, an earlier design)

Schematic: imu.sch

Parts:
C85, C86, C87: 100nF
C88: 10uF
U6: BMG160
U25: LIS3DH
