UBC-Thunderbots/Electrical/electronics/robot/main/main.sch

## KiCad design electronics/robot/main/main.sch (2017-01-15, an earlier design)

Schematic: main.sch

Parts:
C61, C89: 100nF
M1, M2, M3: 5mm; Digi-Key Part 952-1496-ND
M4, M5, M6: 16mm; Digi-Key Part 952-1507-ND
R1, R44: 10kR
R3, R43: 100R
R45: 2.2kR
U7: MRF24J40MB

Notes on the sheet:
Up to Chicker Board:
Down to Breakout Board:
