UBC-Thunderbots/Electrical/electronics/robot/main/microcontroller.sch

## KiCad design electronics/robot/main/microcontroller.sch (2017-01-15, an earlier design)

Schematic: microcontroller.sch

Parts:
C22: 10uF
C60: 10nF
C76, C77, C79, C81, C83: 100nF
C78, C82: 4.7uF
C80, C84: 2.2uF
D16: RED
D19, D20: GRN
P3: CONN_6
P4: CONN_4; Digi-Key Part ED2980-ND
R2: 1kR
R37, R40, R46: 100R
SW2: DIP6
U24: STM32F405RXT

Notes on the sheet:
Status
Charged
Link
Bootloader
