UBC-Thunderbots/Electrical/electronics/robot/main/motordriver.sch

## KiCad design electronics/robot/main/motordriver.sch (2017-01-15, an earlier design)

Schematic: motordriver.sch

Parts:
C11, C12, C13, C15, C16, C17: 100nF
C18: 10uF
F2: 5A; Digi-Key Part F1460CT-ND
Q4, Q5, Q6: AO4882
U4, U5, U13: LM5107
