UBC-Thunderbots/Electrical/electronics/robot/main/oscillator.sch

## KiCad design electronics/robot/main/oscillator.sch (2017-01-15, an earlier design)

Schematic: oscillator.sch

Parts:
C23: 100nF
U12: ECS-3953M
