UBC-Thunderbots/Electrical/electronics/robot/main/power.sch

## KiCad design electronics/robot/main/power.sch (2017-04-01, an earlier design)

Schematic: power.sch

Parts:
C1: 100nF
C3, C21: 10uF
C5, C48, C73, C74, C75: 1uF
C14: 100uF; C1.8V8V
D3: TVS; Digi-Key Part SMAJ24CABCT-ND
D18: GRN
D24: DIODESCH; Digi-Key Part NSR0240HT1GOSCT-ND
F1: 15A; SM1206; Digi-Key Part 486-1688-1-ND
P7: CONN_2; Digi-Key Part none
Q14, Q15: MOSFET_N; SOT23_3GDS
Q27: MOSFET_P
Q28: MOSFET_P; SO8E-IRF9310
R6: 6kR
R7, R52: 1kR
R8: 1MR
R39: 100R
R50, R51, R53, R58: 10kR
SW1: SP3T
U9: LD1117D33; SO8E
U10: MCP1726; SO8N
U11: 7805; LM78XX_VERT
U23: LP2951

Notes on the sheet:
Power
SP3T PCB Conn
Off
Start
Out
