UBC-Thunderbots/Electrical/electronics/robot/breakout/breakout.sch

## KiCad design legacy/electronics/robot/breakout/breakout.sch (2017-01-15, an earlier design)

Schematic: breakout.sch

Parts:
C9, C10: 10uF; C_1206_HandSoldering
K1: CONN_01X03; Pin_Header_Straight_1x03; Digi-Key Part 3M9468-ND
M1, M2, M3, M4, M5, M6, M7: 5mm; M3_MOUNT; Digi-Key Part 952-1496-ND
P9: CONN_01X11; WM7629CT-ND; Digi-Key Part WM7629CT-ND
P10: CONN_02X30; FX6-60P-0.8SV; Digi-Key Part H10787-ND
R5: 100R; R_0805_HandSoldering

Notes on the sheet:
Up to Main Board:
Down to Midplate:
LPS3
LPS2
LPS1
LPS0
LPS sensor
BB laser
BB sensor
