UBC-Thunderbots/Electrical/electronics/robot/breakout/wheelconn.sch

## KiCad design legacy/electronics/robot/breakout/wheelconn.sch (2017-01-15, an earlier design)

Schematic: wheelconn.sch

Parts:
C1, C5: 100nF; C_0805_HandSoldering
P1: CONN_01X04; 53048-0410; Digi-Key Part WM1744-ND
P5: CONN_01X11; FH12-11S-1SH
R1: 10KR7; SO14HUGE
U1: 74HC4050; SOIC-16_3.9x9.9mm_Pitch1.27mm_HandSoldering
