UBC-Thunderbots/Electrical/legacy/electronics/robot/chicker/chicker.sch

## KiCad design legacy/electronics/robot/chicker/chicker.sch (2017-07-02, an earlier design)

Schematic: chicker.sch

Parts:
C1, C5, C7: 10uF; C_1206_HandSoldering
C6: 100uF; C_Radial_D8_L11.5_P3.5
C8, C9, C11: 1mF; ESMQ251VSN102MQ45S_HORIZONTAL
D1: D; D2PAK-DIODE-BACKWARDS
D2: D_Schottky; SOD-323; Digi-Key Part NSR0240HT1GOSCT-ND
D3: RURG3060CC; TO-247_Horizontal_Neutral123
D5: RED; LED_1206
F1: 5A; Fuse_SMD1206_HandSoldering; Digi-Key Part F3539CT-ND
K1: RELAY_2RT; PB1163CT-ND; Digi-Key Part PB1163-ND
L1: 22uH; SRP1770TA; Digi-Key Part none
M1, M2: 16mm; M3_MOUNT; Digi-Key Part none
P1, P3: CONN_01X02; Pin_Header_Straight_1x02; Digi-Key Part WM4300-ND
P2: CONN_02X06; Pin_Header_Straight_2x06; Digi-Key Part S7074-ND
Q1: Q_NMOS_GSD; TO-263-2Lead
Q3, Q4: Q_NIGBT_GCE; TO-247_Vertical_Neutral123
R1, R7: 100kR; R_0805_HandSoldering
R2: 2.2kR; R_0805_HandSoldering
R3, R4, R8: 10kR; R_0805_HandSoldering
R10, R11: 160R; R_0805_HandSoldering
R12, R13: 2kR; PF2203
U1, U2, U3: MIC5020; SO8E; Digi-Key Part 576-1818-5-ND

Notes on the sheet:
Down to Main Board:
