UBC-Thunderbots/Electrical/electronics/robot/main/chicker.sch

## KiCad design legacy/electronics/robot/main/chicker.sch (2017-01-15, an earlier design)

Schematic: chicker.sch

Parts:
P18: CONN_02X06; Pin_Header_Straight_1x12; Digi-Key Part 952-1366-5-ND
R4: 100kR; R_0805

Notes on the sheet:
RELAY
~PRESENT
