UBC-Thunderbots/Electrical/electronics/robot/main/microcontroller.sch

## KiCad design legacy/electronics/robot/main/microcontroller.sch (2017-01-15, an earlier design)

Schematic: microcontroller.sch

Parts:
C22: 1uF; C_0805
C60, C76, C77, C79, C81, C83: 100nF; C_0805
C78, C82: 4.7uF; C_0805
C80, C84: 2.2uF; C_0805
D16: RED; LED-1206
D19, D20: GRN; LED-1206
P3: CONN_01X06; Pin_Header_Straight_1x06
P4: USB_B; USB_B_V; Digi-Key Part ED2980-ND
R2: 1kR; R_0805
R37, R40, R46: 100R; R_0805
SW2: DIP6; 219-6MST
U24: STM32F405RXT; TQFP-64_10x10mm_Pitch0.5mm

Notes on the sheet:
Status
Charged
Link
Bootloader
