UBC-Thunderbots/Electrical/electronics/robot/main/power.sch

## KiCad design legacy/electronics/robot/main/power.sch (2017-04-01, an earlier design)

Schematic: power.sch

Parts:
C1: 100nF; C_0805
C3, C21: 10uF; C_1206
C5, C48, C73, C74, C75: 1uF; C_0805
C14: 100uF; C_Radial_D8_L11.5_P3.5
D3: TVS; SMA_Standard; Digi-Key Part SMAJ24CABCT-ND
D18: GRN; LED-1206
D24: D_Schottky; SOD-323; Digi-Key Part NSR0240HT1GOSCT-ND
F1: 15A; Fuse_SMD1206_Reflow; Digi-Key Part 486-1688-1-ND
P7: CONN_01X02; BATTERY_INLET; Digi-Key Part none
Q14, Q15: Q_NMOS_GSD; SOT-23_Handsoldering
Q27, Q28: IRF9310PbF; SOIC-8_3.9x4.9mm_Pitch1.27mm_HandSoldering
R6: 6kR; R_0805
R7, R52: 1kR; R_0805
R8: 1MR; R_0805
R39: 100R; R_0805
R50, R51, R53, R58: 10kR; R_0805
SW1: SP3T_6PIN; A27xP
U9: LD1117D33; SO8E
U10: MCP1726; SOIC-8_3.9x4.9mm_Pitch1.27mm
U11: 7805; LM78XX_VERT
U23: LP2951; SOIC-8_3.9x4.9mm_Pitch1.27mm_HandSoldering

Notes on the sheet:
Power
SP3T PCB Conn
Off
Start
Out
Off: Q28 open: gate pulled to battery positive via SW1 pin 2, 3, 5, 6. Q27 open: gate pulled to battery positive via D24 and SW1 pin 2, 3, 5, 6. On: Q28 gate under firmware control via SW1 pins 2, 3, 5, 4, R51 pull-up, Q14 to ground. Q27 gate under firmware control via R53 pull-up, R52+Q15 to groun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
