UBC-Thunderbots/Electrical/electronics/robot/main/sdcard.sch

## KiCad design legacy/electronics/robot/main/sdcard.sch (2017-01-15, an earlier design)

Schematic: sdcard.sch

Parts:
C49: 100nF; C_0805
P1: 114-00841-68; Digi-Key Part 114-00841-68-1-ND
