UBC-Thunderbots/Electrical/electronics/robot/optical_encoder/optical_encoder.sch

## KiCad design legacy/electronics/robot/optical_encoder/optical_encoder.sch (2017-01-15, an earlier design)

Schematic: optical_encoder.sch

Parts:
P1: CONN_01X04; Digi-Key Part none
P2, P3: CONN_01X04; Digi-Key Part optical-encoder-plug
U1: E4P; Digi-Key Part none

Notes on the sheet:
Connecting Cable
Optical Encoder
