UBC-Thunderbots/Electrical/electronics/robot/solenoid/solenoid.sch

## KiCad design legacy/electronics/robot/solenoid/solenoid.sch (2017-01-15, an earlier design)

Schematic: solenoid.sch

Parts:
L1: INDUCTOR; Digi-Key Part none
P1: CONN_01X02; Digi-Key Part solenoid-plug
