UBC-Thunderbots/Electrical/electronics/oven_controller/Kicad/oven_controller2.sch

## KiCad design electronics/oven_controller/Kicad/oven_controller2.sch (2015-03-13)

Schematic: oven_controller2.sch

Parts:
1:12: TR1-SO8
Buzzer1: SD1209T3-A1
C1, C1-2: 15pF
C2: 10nF
C3, C3-2: 1uF
C4, C4-2, C4-3, C4-4, C4-5: 100nF
C5, C5-2: 2.2uF
C6, C6-2: 4.7uF
C7: 0.1uF
C8: 200uF
C9: 2uF
D4: DIODE
P1: CONN_14
P2: CONN_4
Q1, Q2: BC847A; SOT-23-3
R1, R8: 1kR
R2: 200R
U1: STM32F405RXT
U2: MAX6675
U3: RECTIFIER
U4: SSR
U5, U6: DUO_CONNECTOR_
U7: THERMOCOUPLE_CONNECTOR
U8: REGULATOR
X1: 8MHz
