UBC-Thunderbots/Electrical/(commit log)

2010-11-26 Add target velocity parameter to AI::HL::W::Player::move() and allow retrieving it through AI::Nav::W::Player::target_velocity().
2010-11-26 Convert to UNIX line endings.
    [chicker.sch, dribblerconn.sch, flash.sch, fpga.sch, main.sch, motordriver.sch, oscillator.sch, pic.sch]
2010-11-26 Specify precise part number for dribbler auxiliary connector.
    [main.sch]
2010-11-26 Add some parts used on the main board.
2010-11-27 Add a missing annotation.
    [chicker.sch]
2010-11-27 Fix some odd stuff.
    [motorcontroller_test_board.sch]
2010-11-27 Clean up a lot of temporary files and set svn:ignore property on all directories.
    [$savepcb.brd]
2010-11-27 Get everything into native line ending mode.
    [chicker.brd, chicker.sch, motorcontroller_test_board.brd]
2010-11-28 Lots of bugfixing. Handled the case where kickoff execute is called without proper preparation.
2010-11-28 Adding thermal reliefs back to chicker board polygons
    [chicker.brd]
2010-11-28 Drive Train: - Added Drawings for Wheel - Made changes to several parts while drawing.
2010-11-29 Drive Train: - Wheels are fully modelled and drawings are ready to be sent out.
2010-11-30 Add zone cutouts around mounting holes.
    [main.brd]
2010-12-01 updated code to send each sensor data separately with pin flag for each at the end of the data
2010-12-01 Changed excel formulas to account for the new design of crossing sensors also updated code to handle each sensor data separately to get the correct angle direction
2010-12-01 updated OrderSheet.xlsx for the maxon motors
2010-12-02 added a matlab example of a kalman filter
2010-12-03 Switch to XC3S50AN instead of XC3S50A as the former is out of stock.
2010-12-03 Fix an out-of-stock USB cable.
2010-12-04 Clear the teams when the swap colours button is clicked.
2010-12-04 Placed orders for screw extractor and loctite 222
2010-12-06 Updated speed measurement to angle measurement by separating sensors data serially also updated to control angle of kicking using delay instead of pwm
2010-12-06 Updated code and excel sheet for the new angle measurement device that is insensitive to friction Test measurements included for straight kicking
2010-12-06 measuring speed using a single sensor feature included multiple kickers controls feature added using pwm
2010-12-06 solenoid force vs gap using data sheet of solenoid
2010-12-06 Created a MATLAB model of kicker circuit and control behaviour
2010-12-06 Prototype for STP based strategy.
2010-12-10 removed dribbler joint from the robot model
2010-12-10 Add RURG3060CC schematic symbol.
2010-12-10 Swap out diodes with RURG3060CC (available replacement) and add some Digikey part numbers.
    [chicker.sch]
2010-12-10 Added high voltage cap into Digikey order for chicker board
2010-12-15 Added circuit prototypes to OrderSheet.xlsx
2010-12-15 Added IGBTs, Photo-couplers, and break-beam sensors
2010-12-18 Implement generic computation caching framework.
2010-12-19 added a simulink model for the current solenoids
2010-12-19 Label which pin of the stereo connector is tip, which is ring, and which is sleeve on the schematics.
    [dongle.sch, estop.sch]
2010-12-19 solenoid model with controller for a 10 m/s kick at only 110 volts
2010-12-21 Add the parasitic body diodes on the MOSFET symbols.
2010-12-21 Fix MOSFET polarity bug.
    [main.brd, motordriver.sch]
2010-12-25 Use slightly larger pins in SIP headers.
    [main.brd]
2010-12-25 Add SO8S footprint and add it to the footprint filter for the SPI Flash.
2010-12-25 Add and use TO220_123 footprint with pins in non-fucked order.
    [main.brd]
2010-12-25 Make the dongle board use CVPCB instead of hardcoded footprint fields. Also, update to use TO220_123 footprint.
    [dongle.brd, dongle.sch]
2010-12-27 Implement stage-2 configuration.
2010-12-28 Put a surface-mount-style alignment marker on the SO8S footprint.
2010-12-28 removed a couple of un-used classes
2010-12-29 Implement activity LEDs and outbound main data transport receiving on USB.
2010-12-29 Eliminate a couple of compiler warnings.
2010-12-29 adding SPI ADC datasheet for ADC
2010-12-29 added order 30 mcmaster solder order
2010-12-30 Use #defines for the interrupt/state transfer and bulk endpoints.
2010-12-30 Separate interrupt and state transfer buffers from bulk buffers to achieve better flow control and QoS.
2010-12-30 Rename XBee2 stuff to XBee0.
    [main.sch, pic.sch, xbee.sch]
2010-12-31 Call the configuration exit callback if a bus reset occurs while the device is configured.
2011-01-01 fixed some schematic bugs namely motor controllers add the rest of the pins to the ucf
    [chicker.sch, dribblerconn.sch, flash.sch, fpga.sch, main.brd, main.sch, motordriver.sch, oscillator.sch]
2011-01-01 I didn't want to commit this bunk
    [main.cpp]
2011-01-01 Make pwm.c nonexecutable.
2011-01-01 Clean up the UCF and add some virtual rails (just the configuration mode and variant select pins).
2011-01-02 Checking in UNTESTED SuperSimpleBoostConverter (constant on time, constant off time, no PWM, slow charging) code
2011-01-02 some general clean up a connector for the breakbeam datasheet
2011-01-02 Remove Digikey part field from PIC on dongle board.
    [dongle.sch]
2011-01-03 Make sure to restart the interrupt out endpoint when a buffer is freed if it was stuck before.
2011-01-03 Fix a race condition on /CTS between enabling transmit interrupts and disabling the polling timer.
2011-01-03 Optionally set the kick power through the shoot function On the kickoff don't kick the ball as hard as shooting normally
2011-01-03 Implement inbound interrupt message delivery.
2011-01-03 Avoid floating units C and D of U21.
    [main.brd, main.sch, motordriver.sch]
2011-01-03 Extensively clean up power rails.
    [main.brd]
2011-01-03 Make the 5V line thicker.
    [main.brd]
2011-01-03 added a cut out below the inductor
    [chicker.brd]
2011-01-03 updated chicker to have a non inverting driver and use a pull down resistor
    [chicker.brd, chicker.sch]
2011-01-04 Cleaned up sheets
    [18FPIC.sch, boostconverter.brd, boostconverter.sch]
2011-01-04 Substitute an out-of-stock component.
    [chicker.sch]
2011-01-04 Rename ~CHARGE to CHARGE to reflect new active-high model.
    [chicker.brd, chicker.sch]
2011-01-04 Set the output drive level to 16mA for the chicker charge line to have more headroom over the ~10mA sunk through the pull-down resistor. Also set the virtual ground and VDD pins to 16mA instead of 24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
2011-01-04 Add module SIL-12-BIGPINS to footprint library and use it and SIL-18-BIGPINS in chicker board layout.
    [chicker.brd]
2011-01-05 misc electrical parts for 1 robot
    [misc_bom.tsv]
2011-01-05 Added library part for ADS7866IDBVT ADC, and changed chicker board to use it
    [chicker.brd, chicker.sch]
2011-01-05 Use Digibom for off-board components.
    [misc_bom.tsv]
2011-01-05 Add full board run components.
2011-01-05 Finishing up business around ADC switch.
2011-01-07 Fix failure to initialize SPI transceiver and failure to append CRC16 of parameter block.
2011-01-07 Fix failure to initialize SPI transceiver.
2011-01-08 Enforce halting of robots when the emergency stop switch is not in the Run position.
2011-01-09 an example C++ kalman filter with a high precision matrix library class
2011-01-11 a c++ kalman filter, no it does not compile yet
2011-01-11 Basic toplevel for testing new boards.
2011-01-11 it helps not to put the filter class inside the running loop, history is usually important.
2011-01-13 Provide an assembly-language CRC16 that is over twice as fast.
2011-01-13 Apply a functional stall to the OUT state transport endpoint if the emergency stop switch is triggered.
2011-01-14 updated OrderSheet.xlsx for bearings and mass circuit Order
2011-01-15 Clean up interrupt handling a bit, swap CTS polling from timer 1 to timer 4, and use timer 1 as a scram timeout.
2011-01-15 Swap net names for N- and P-channel FETs on mainboard and update UCF to match.
    [fpga.sch, main.brd, motordriver.sch]
2011-01-16 Replace LED output with proper error reporting.
2011-01-17 Renumber the motors in the proper order.
    [fpga.sch, main.brd, motordriver.sch, wheelconn.sch]
2011-01-17 Renumber the optical encoders in the proper order.
2011-01-17 Clean up encoder handling.
2011-01-17 aram's kalman filter changes
2011-01-17 Clean up and finish a lot of stuff.
    [dribblerconn.sch, fpga.sch, main.brd, main.sch, motordriver.sch, wheelconn.sch]
2011-01-17 Implement test modes that can display various useful information on the LEDs.
2011-01-18 kalman filter
2011-01-18 1. change "current_control = *(inputs_itr).value;" to "current_control = (*inputs_itr).value;"
    2. remove all the ".get_d()" since we no longer use multiple precision library.
    3. change "<< matrix " to "matrix.toString()" in main.cpp
    4. add gsl library to Makefile.
    Note: to compile the code, you need to download gsl library (I downloaded libgsl0-dev from synaptic manager). BLAS library may be needed.
2011-01-18 add README file and a sample output file.
2011-01-19 make predictor use kalman filter, old code is commented out
2011-01-19 Cleanup and implement wheel controller and stuff.
2011-01-20 Implement dribbler temperature monitoring.
2011-01-20 added angle mod to kalman filter, use with caution: bring down measurement and state estimate AT THE SAME TIME!!
2011-01-20 Increase charger timeout to 3.5s.
2011-01-20 Make dribbler power a tunable parameter.
2011-01-21 changes to kicking power
2011-01-21 Fix default kicking power for shooting
2011-01-21 Add a world for robot controllers whence they can get the current time.
2011-01-21 Send the current time for normal movement so that the robot will try to go as fast as it can Send a slightly slower time for dribbling
2011-01-22 added UI adjustable parameters to rrt_navigator on byron's computer because he was screwing up thins for the past 3 hours. some of his other crap is on here that he wanted to keep. will clean up code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
2011-01-22 Change TMR1 interrupts from high to low priority in an attempt to reduce hardware overrun errors.
2011-01-22 Log ignored endpoint stalls.
2011-01-22 Remove a check for player size to be 0, so that the goalie can use the velocity prediction all the time
2011-01-22 changed kicking power and temp sol to hl bot x not moving problem
    -Terence
2011-01-22 made one extra pin RA1 as control for charging.
2011-01-27 Optimize FPGA bitstream by removing explicit plumbing of the reset line.
    [motor.vhd, top.vhd]
2011-01-27 Optimize PWM generators.
2011-01-27 Make the chicker power level smaller.
2011-01-28 Have fuzzy2 controller take into account the milliseconds portion of the time, previously it was only considering seconds Have rrt navigator move towards the ball slower so it doesn't hit it too far 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
2011-01-29 Drive Train - Added motor mount drawings from last year.
2011-01-29 Push the negation of motors and encoders into the proper places.
2011-01-29 Chicker Test Board Added
    [Chicker Test Board.brd, Chicker Test Board.sch]
2011-01-29 Add a clamp to motor power level.
2011-01-29 Changed chicker test board crystal cap values and other caps footprints
    [Chicker Test Board.sch]
2011-01-29 - Updated reference problem where these files referenced to /tag before - Modified motor mounts bottom hole locations
2011-01-30 - Added an order for a smaller battery
2011-01-30 made Logos and Promotional Material folder in admin
2011-01-31 Add a register level to a tight-timing combinational path.
    [motor.vhd]
2011-02-05 updated Nav::Util to add a function to calculate the next timespec (example on SimpleNavigator), also updated BNavigator to not screw up
2011-02-05 Added fat pins SIL-2 footprint to modules library
2011-02-05 Added LM67XX_VERT footprint to modules library
2011-02-05 PCB trace complete for Chicker Test Board
    [Chicker Test Board.brd, Chicker Test Board.sch]
2011-02-05 Fixed VDD core and art work :)
    [Chicker Test Board.brd, Chicker Test Board.sch]
2011-02-06 Replaced 18 pin header and added IO pins to header
    [Chicker Test Board.brd, Chicker Test Board.sch]
2011-02-12 Chicker Test Board - Added extra header for I/O pins & added SIL-10-BIGPINS
    [Chicker Test Board.brd, Chicker Test Board.sch]
2011-02-15 new code that controls Loktin charger circuit
2011-02-19 -Added another battery (11.1V with 1300mAh)
2011-02-20 new sensor system
    [Sensor.sch]
2011-02-21 added kicker circuit testing components
2011-02-23 added high wattage resistor
2011-02-26 updated sensor pads and footprint
    [Sensor.sch]
2011-02-26 Add battery charger manual.
2011-02-27 Added pin numbers for 74AHC74
2011-02-27 Routed breakbeam board
    [Sensor.brd, Sensor.sch]
2011-02-28 Added a second solenoid for chipping purposes. Changed teh dimension of the kicking head to ensure there is proper reach to kick the ball. Added mates to restrict the movement of the solenoid to mimi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
2011-03-03 added current discharge circuit diagram for kicker
2011-03-04 Implement low-voltage cutoff.
2011-03-10 Implement CRC16 in VHDL and use it to compute the SPI flash build signature.
2011-03-10 Clean up LEDs and avoid marking feedback as valid until all ADC channels have run.
2011-03-12 updated driver
2011-03-12 Remove a register in SPI flash MISO.
2011-03-12 Changed chicker to use MCP1415 on charge, kick, and chip. Improved layout and routing for ground current from chipping.
    [chicker.brd, chicker.sch]
2011-03-12 Oops. Forgot to save before committing (R5088).
    [chicker.sch]
2011-03-12 -Raising the robot by 1.5mm from the ground
2011-03-12 Thickened PCB traces on breakbeam board.
    [Sensor.brd]
2011-03-12 adjusted optical sensor postions a little bit
    [Sensor.brd]
2011-03-17 Added serial port to Chicker Test Board
    [Chicker Test Board.brd, Chicker Test Board.sch]
2011-03-18 Pay attention to the SPI flash contents parameter.
2011-03-18 Fix possible race condition where data not yet delivered over the interrupt in USB pipe could be overwritten by a subsequent XBee packet.
2011-03-19 Added CAD for shock absorber and mount. Modified middle plate (didn't fix errors). Added shock absorber and mount to fullassembly.
2011-03-19 If stop calculates a point outside of the field boundary then force the point to be within the boundary so the robots won't get lost by the cameras
2011-03-19 Avoid turning on the dongle LED until the channels are set and the XBees configured.
2011-03-19 Document explaining possible full 4 quadrant motor control - For Jon
2011-03-19 - Added 2 configurations to the FullAssembly.SLDASM: Dribbler1 config has sandy/bonnie's dribbler Dribbler2 config has capstone dribbler - Fixed Shock absorber/SA Mount not being in the centre issue -
2011-03-20 changed serial communication to 255,Sensor 1,Sensor 2
2011-03-20 fixed serial communication issue by using string to long integer conversion [255,Sensor 1,Sensor 2]
2011-03-21 intermediate work
    [dongle.brd, dongle.sch]
2011-03-21 edited diode footprint
    [dongle.brd]
2011-03-22 fixed encoding problem in sending numbers > 128 ASCII from excel sheet. digit numbers are sent separately with '|' as number end flag and decoding in wiring
2011-03-23 Fully separate the control path for braking the dribbler from that for braking the wheels.
2011-03-23 Kill the dribbler laser on low battery.
2011-03-25 from now onwards, adhoc is known as PID
2011-03-25 Fixed dongle board routing (via not connected to net, moved buzzer away from USB signals)
    [dongle.brd]
2011-03-26 Fix name case.
2011-03-26 Fix some math to be slightly more accurate for ADC data.
2011-03-26 Added acute dribbler to the full assembly.
2011-03-26 Dribbler: - Fixed the mates in the full assembly. Dribbler can now flexibly move.
2011-03-26 Removed a redundant copy of the full assembly.
2011-03-26 Do the ADC math properly.
2011-03-26 Start moving towards merged interrupt-bulk protocol.
2011-03-26 small changes
    [dongle.sch]
2011-03-26 Expand the period of time the battery needs to be low for before it cuts out.
2011-03-26 added capacity to adjust for a constant delay in the xbee backend
2011-03-27 Added ground jumper to chicker
    [chicker.brd, chicker.sch]
2011-03-27 Fixed motorcontroller test board
    [motorcontroller_test_board.brd, motorcontroller_test_board.sch]
2011-03-27 Fix some routing issues.
    [dongle.brd]
2011-03-28 Small layout tweaks to make stronger connections between plane areas for GND and +3.3.
    [dongle.brd]
2011-03-28 Updated the full assembly: constrained the dribbler, removed the current kicking device and removed errors from middle plate.
2011-03-28 [chicker] Fixed floating IGBT jumper
    [chicker.brd, chicker.sch]
2011-03-28 changed SA mount from 3/16" to 1/8" steel added holes for SA mount placement correctly set hole locations for SA mounts to midplate In the process of adding bend stopper device
2011-03-28 Rename files to sensible name.
    [sensor.brd, sensor.sch]
2011-03-28 placed holes for M5 bolt stopper put in capstone solenoid design made changes to dimensions to suit design added centering dribbler.
2011-03-28 Update the status of the battery order
2011-04-02 added a bunch of planner classes to the navigator package, currently unused
2011-04-02 Modified the width of the dribbler and adjusted the base plate to fit the resized dribbler.
2011-04-02 switch an && that should have been an ==
2011-04-03 Deleted hole on SA mount. Moved SA to proper position. Corrected dimensions of SA (last commit).
2011-04-05 fixed initial buttons setup and added error display when failed to read serial
2011-04-06 Set up jumper wire components to work with digibom.
    [chicker.sch]
2011-04-06 Deleted 4 holes, added 3 holes on SA mount and middle plate.
2011-04-06 Get the new dongle board ready for DigiBOM.
    [dongle.sch]
2011-04-06 Make some parts more DigiBOM compatible.
    [sensor.sch]
2011-04-06 Connected PRESENT and KICK signals to PIC, added pull down resistor for PRESENT, left crystal on board. Add crystal only if we need later
    [Chicker Test Board.brd, Chicker Test Board.sch]
2011-04-06 connected ENVREG to 3.3V
    [Chicker Test Board.brd, Chicker Test Board.sch]
2011-04-07 I changed the base plate to remove interferences between the solenoids and the dribbler assembly. Also modified the dribbler assembly to be easier to align and manufacture. If the changes are undesir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
2011-04-07 Add BAT54W diode datasheet.
2011-04-09 Remove a couple of unused files.
2011-04-09 Created holes for SA mount on middle plate.
2011-04-09 -Add CAD for the new battery
2011-04-09 Change middle plate.
2011-04-09 Changed location of M4 holes for SA mount.
2011-04-09 Updated Battery to 2011 version
2011-04-09 Added fasteners for the dribbler on the full assembly.
2011-04-09 Changed screw position for securing dribbler outward position.
2011-04-09 Changed position of power switch.
2011-04-09 Adding ball position sensor into the repository.
2011-04-09 Added new (shorter) top standoff part.
2011-04-09 Created nut for shock absorber.
2011-04-09 Replaced the top standoffs in the full assembly with shorter parts.
2011-04-09 Added fasteners to full assembly (except for wheels)
2011-04-09 Changed the Mid-plate altered configurations
2011-04-10 add snippet to draw velocity, uncomment code to enable
2011-04-10 Fix path name generation for parameter printing.
2011-04-10 Implement visualization of robot velocities and allow individual visualizations to be turned on and off.
2011-04-11 Dimensioned holes on middle plate for SA mount in a different way. (Nothing changed)
2011-04-11 Widen space between holes on midplate for SA mount so screws don't overlap.
2011-04-11 Adjusted shock absorber nut to the right size.
2011-04-11 Added nut to shock absorber. Readjusted position of SA relative to dribbler.
2011-04-11 Take away one nut from shock absorber.
2011-04-11 Tweaks to display CAD in Full Assembly
2011-04-12 added wheel prototypes to OrderSheet.xlsx
2011-04-15 -Mad drawing session is coming, so impose a filename for all the CAD files to organize
2011-04-15 Correct boss feature on left and right dribbler mount to better fit the ball laser
2011-04-15 -Added relief holes for the dribbler plates
2011-04-15 fix when ball velocity is too high
2011-04-16 [Chicker test board] Changed crystal caps values to 27pF. Fixes Ticket #495.
    [Chicker Test Board.brd, Chicker Test Board.sch]
2011-04-16 Finished drawings for Backplate. Unfinished drawings for Left and Right Plate and SA Mount.
2011-04-16 cap plate Drawings
2011-04-16 Changed all capacitor values to have positive numerical parts
    [Chicker Test Board.brd, Chicker Test Board.sch]
2011-04-16 - Drawings for BasePlate, ScrewPlate - Add unit into file convention
2011-04-16 [Chicker Test Board] made it BOMmable
    [Chicker Test Board.brd, Chicker Test Board.sch]
2011-04-16 Added Chicker Test Board, chicker, and dongle component orders (#42)
2011-04-16 Move Motor Mount Right
2011-04-16 Move montor mount
2011-04-16 Renamed DXF Files for all Motor Mounts
2011-04-17 a couple of functions to be implemented in actions.h and actions.cpp
2011-04-17 - Added power switch stand drawings
2011-04-17 Updated FullAssembly.SLDASM to remove errors and screws
2011-04-17 shock absorber mount drawings upload.
2011-04-17 finished drawing for right plate of Dribbler/April 14 2011/Rightplate_Al_3-16in_13_000.SLDDRW
2011-04-17 Update Shock absorber/SA Mount (Hole).SLDPRT
2011-04-17 Instead of software shutting down the robot when the battery gets low, just have it show a warning.
2011-04-17 Hi all, I just added the Capstone dribbler, and made a slight adjustment to the middle plate so that it fits The drawings for it are there as well I moved one of the solenoid brackets, so two holes o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
2011-04-20 Fix a kick power limit.
2011-04-23 wrote this a while ago...its the linear voltage control stuff for the motors
2011-04-23 Get rid of the low battery warning if the robot is not powered up at all.
2011-04-23 update pid comments
2011-04-23 new log file: ball seems to move backward on the kalman filter output
2011-04-24 Added new solenoids and new shafts
2011-04-24 Add xbeeconfig utility to change channels on locally-attached dongle.
2011-04-24 added scollbar for viewing different frames, added help menu
2011-04-24 removed the secondary addition of the mosfet control document, if loktin adds it again I'm going to smack him one
2011-04-25 added standoffs
2011-04-26 Added pcb board mount holes to the middle plate and updated drawings for the midplate
2011-04-27 Edit dimensioning of dribbler left side plate for waterjetting.
2011-04-27 Drive Train: - Minor changes to drawings. Included material info.
2011-04-28 Created dxf for SA mount file for waterjetting. Created pdf files for leftplate and rightplate with full dimension.
2011-04-28 fixed tapered roller order and removed un-machined shafts for kickers
2011-04-28 Added new machined kicker shafts
2011-04-29 Edited the dxf files for motor mounts for water-jetting.
2011-04-30 added new stp pass defensive play (copy of pass offensive currently) -Terence
2011-04-30 Add a (0,0)-lookaside to Predictor to improve performance in the common case.
2011-05-02 Updated dribbler DXFs to undersize holes
2011-05-02 Fixed DXF for right plate of dribbler
2011-05-02 created dxf. files for middle plate
2011-05-03 Revised left plate of dribbler to oversize back plate slots
2011-05-03 Revised right plate of the dribbler to oversize the back plate slots
2011-05-04 Added mickey mouse ears to corners of the dribbler's back plate
2011-05-05 Created holes on Midplate and Baseplate for switch stand and damping bases.
2011-05-05 Created revision 1 for CAD and dxf of baseplate.
2011-05-06 Edited position of motor hole on rightplate.
2011-05-07 Undeprecate the old all-inclusive move() function as it seems people may still want it and, in any case, it makes a lot of pointless noise during compiles.
2011-05-07 [Motorcontroller board] Added P loop and reverse
2011-05-07 Double-checked dimensions of all holes on baseplate.
2011-05-07 Changed all tapped holes to M3x0.5 on the midplate.
2011-05-07 Updated midplate DXF according to new tap hole dimensions (all M3)
2011-05-07 Avoid spewing errors when a dribbler thermistor is unconnected.
2011-05-07 fixed a spelling error in the mosfet control document
2011-05-08 [chicker] removed jumper, added trace instead
    [chicker.brd, chicker.sch]
2011-05-09 Increased distance between roller and motor by 0.25mm.
    Moved motor position such that gear doesn't block screw for back plate.
2011-05-10 Resolved dribbler design issues:
    -side plate extended forward 2mm
    -pivot pin raised 2.5mm
    -repositioned dribbler housing support screw hole on midplate to accommodate M3
    moved damping base 2 mm backwards to fit within the constraint circle
2011-05-10 Moved dribbler 0.5mm backwards in FullAssembly.SLDASM to fit within the constraint circle
2011-05-10 Created dxf for baseplate for 2nd prototype.
2011-05-10 Created baseplate SLDDRW for 2nd prototype. Edited leftplate SLDDRW for 2nd prototype.
2011-05-10 Created 4 different dxf for SA Mount. Edited Leftplate dxf.
2011-05-11 Revised DXFs for SA mount (fixed screw hole sizing)
2011-05-11 Revised right plate DXF to correct dimensions
2011-05-11 Revised right plate of dribbler to correct dimensions
2011-05-11 -Updated right and left dribbler plates to correct dimensions (changed back plate holes) -corrected left dribbler plate DXF to reflect correct dimensions
2011-05-11 Slightly undersized backplate holes on side plates of dribbler (4.7625mm to 4.762mm) for waterjetting.
2011-05-11 Added revised DXF for dribbler's left plate (undersized width of back plate slots for waterjet)
2011-05-11 Added revised DXF for dribbler's right plate (undersized width of back plate slots for waterjet)
2011-05-14 Increased solenoid slot length by 1 mm in SLDPRT.
2011-05-14 - Updated budgets with robot component orders + new spending estimates - Added wheel prototypes to order sheet
2011-05-14 goalie switch between top and bottom depending on the ball position
2011-05-15 Decreased the thickness of the solenoid restraints to fix interference with the pivot base
2011-05-15 Changed the screw size for the back solenoid restraint from M4 to M3
2011-05-15 Updated base plate to fit the decreased thickness of the solenoid restraints
2011-05-15 Increased diameter of holes for self-aligning bearings on the dribbler side plates by 0.1mm (because bearings fit a bit too tightly, movement not as smooth once bearing is press fit into the side pla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
2011-05-15 Deleted mysterious holes from midplate. Edited mates on acutedribbler and fullassembly for SA Mount.
2011-05-15 Increased size of access slots to shock absorber on midplate.
2011-05-15 Increased size of access slot to shock absorber.
2011-05-15 Edited dimensioning of access slots for ease of later adjustment on M4 holes on midplate.
2011-05-15 Added multiple holes on midplate for dribbler position adjustment.
2011-05-16 -Increased height of dribbler rollers by 2.5mm. -Adjusted slots for break beam such that outer-most position detects ball at straight edge, innermost position detects ball at center
2011-05-16 Added WJ drawings for dribbler side plates
2011-05-16 Double checked motor mount dxf and put into THIRD PROTOTYPE file.
2011-05-16 Adjusted screw position for block SA Mount moving backward.
2011-05-17 Recommitted midplate dxf.rev 5. Moved rev 4 to drawings-chassis folder.
2011-05-17 Fixed dribbler side plate DXFs
2011-05-17 Restored fillet on dribbler left plate, and updated DXF accordingly
2011-05-19 - hid some of the unnecessary planes shown in the assembly - fixed the dribbler 20% rule (with 10 deg damping angles) - the dribbler angle limit is currently set to 100deg
2011-05-19 dxf and SLDDRW for backplate and SA Mount.
2011-05-19 dxf file for motor mounts.
2011-05-19 added DXF and SLDDRW files for mid and base plate
2011-05-24 modified CAD -changed length of solenoid slots from 51.2mm to 52mm -widened slots for the emitter by 1mm -lengthened emitter and receiver slots by 3.5mm
    created DXFs
    -updated drawings all went into "Final drawings for Summer 2011" folder
    -BasePlate_StainlessSteel_1-8in_11_006_WJ,Leftplate_Al_3-16in_13_006_WJ, and Rightplate_Al_3-16in_13_007_WJ now reflects the CAD changes listed above.
2011-05-24 Created drawing and PDF for machining dribbler left plate (for submitting to ECE)
2011-05-24 Created drawing and PDF for machining dribbler right plate (for submitting to ECE)
2011-05-24 Created drawing and PDF for machining dribbler back plate (for submitting to ECE)
2011-05-27 Kick with both solenoids simultaneously.
2011-05-28 Adding multi-stage timing for SuperSimpleBoostConverter
2011-05-29 Rename "Chick" to "Kick" and name by left/right to reflect current reality.
2011-05-30 Rename some nets and change some silkscreen text.
    [chicker.brd, chicker.sch]
2011-05-30 Small cleanup of a couple of RefPtr-managed classes.
2011-05-30 Renamed measurement speed device CAD folder
2011-05-30 [main board] Widened motor traces to 25 mil to decrease magic blue smoke leakage.
    [main.brd]
2011-05-31 Give the mainboard a 12-pin header to match the kicker board's 12-pin header instead of a pointless 18-pin header.
    [chicker.sch, main.brd]
2011-05-31 Reverse-merge r5842 and r5832 (they were done in the wrong place).
    [chicker.sch, main.brd]
2011-06-01 Updated flat kicker head to fit an M4 shaft
2011-06-01 adjusted wheel angles to reflect reality plummed wheelspeeds to controller and limiter fixed a delay bug in the controller added some decimal places to ensure float math
2011-06-03 [chicker] Added part number for HV cap to partinfo.xml and chicker.sch
    [chicker.sch]
2011-06-04 Reintegrate branches/dual-rail-pwm.
    [chicker.sch, main.brd, motordriver.sch]
2011-06-08 Shortened solenoid rubber stopper by 0.5mm; changes are reflected in the SLDPRT and new DXF
2011-06-08 Added 2mm Drill Bit Order (Round 5).
2011-06-09 Added DXF for rubber stopper (enlarged hole) and MDK (smaller triangle)
2011-06-09 -Added part for shaved MDK head, MDK head jig -Added jig + MDK head assembly
2011-06-09 Added dxf's for single solenoid flat kicker waterjetting
2011-06-10 [mainboard] added digibom part number for chicker connector on main board
    [chicker.sch, dribblerconn.sch, flash.sch, fpga.sch, main.sch, motordriver.sch, oscillator.sch, pic.sch]
2011-06-11 [OrderSheet] updated main board digikey order
2011-06-12 Increase charge timeout a little bit (it seems a bit sensitive).
2011-06-14 Added temporary tester for kalman filter. Algorithm developped in this folder will eventually make its way into the navigator. Koko
2011-06-15 Clean up some kicker handling code to prevent issues around double-kicks causing charge timeouts.
2011-06-17 Created part and DXF for double flat kicker head (one plate for each solenoid)
2011-06-17 Added part and DXF for revised kicker stopper (1mm wider, added notches for rubber bands)
2011-06-18 some messy hacks but is 10 pm and I want to go home, pelase revert test_pass I am tired!
2011-06-18 [OrderSheet] added diodes, IGBTs, and 0.1uF caps
2011-06-18 tuned up pid
2011-06-19 parse serval types of data at the same time, leave data that below to one frame on the same line
2011-06-19 added Chipper Base Plate & Dual Flat Head - June 20th to mech waterjet drawings
2011-06-19 [OrderSheet] Removed 5V switching regs from order sheet
2011-06-21 PID parameters
2011-06-21 adjust plot to include data from other camera
2011-06-21 Drive Train: - Added jig needed for Pressing Bearings
2011-06-21 Simon's local changes on vision machine that added the I term to PID whith I an adjustable parameter
2011-06-22 some testing with the new filter
2011-06-22 new chicker mosfet datasheet
2011-06-22 committing partially complete tactic that is currently not called
2011-06-23 Implement mixed straight and multi-directional kicking with proper formulæ for powers and offsets.
2011-06-23 should have a way to run new pass in stp now. currently called through a test hl that calls a couple of non-applicable plays, but otherwise is plumbed throught the AI
2011-06-24 Added schematics for sensor harness
    [sensor_harness_sch.sch]
2011-06-24 removed changes to scoring function that crashed AI by timer overflow
2011-06-25 Implement a thermal limit on kicker charging rate.
2011-06-25 Added color plate dxf to new directory to be WJ.
2011-06-25 add new plot for orientation velocity stuff, kalman output looks noisy
2011-06-25 Add filtering to the Hall sensor lines.
2011-06-27 Fix experiment reader to print some stuff to cerr which should be rather than cout.
2011-06-28 Fix crash when parameter categories have names that differ only in case.
2011-06-29 Actually connect CE on the regulator.
    [dongle.brd, dongle.sch]
2011-06-29 add the dual rail pwm data ... finally updated the cpp robot model
2011-07-01 Fix the jittery encoder problem by eliminating the 128MHz clock in the FPGA and going down to 12.5MHz.
    [motor.vhd, thunderbots.ucf, top.vhd]
2011-07-04 Allow transfer errors as well as stalls to occur up to a limit.
2011-07-05 reset button in stp
2011-07-05 Implement safe discharge and display the capacitor charge state and break beam state on LEDs.
2011-07-05 camera calibration with ball
2011-07-05 pid accel units
2011-07-05 make units correct for pid
2011-07-06 removed a couple lines of dead code
2011-07-06 Implement bar graphs beside robots to show battery and capacitor voltages.
2011-07-06 Clamp some values in the tester to avoid assertion failure messages.
2011-07-07 wheel control
2011-07-07 good PID control
2011-07-07 PID 5
2011-07-07 Allow setting the navigator from the command line. Save the current ball filter, high level, navigator, robot controller, field end, and colour and restore them at startup.
2011-07-07 Implement a better wheel controller. Also, allow running robots with or without the controller.
2011-07-08 pid fixes
2011-07-08 Implement new wheel controller along with encoder failure detection.
    [motor.vhd]
2011-07-08 Updated parameters for pid
2011-07-10 Change PID6 to have a parameter for conversion from motor to field distances.
2011-07-21 Switch to new VHDL parser frontend and clean up some crud.
2011-07-22 ode45 model of solenoid
2011-07-22 modified solenoid model to use flux instead of current and fixed indenting
2011-07-22 moved matlab solenoid model into a class, iterface is nicer now
2011-07-23 Check for an error case.
2011-07-28 -Moved 2011 CAD drawings into one folder, created folder for 2012 files -Begun 2012 baseplate (45 deg wheels)
2011-08-03 Added SLD drawings for flat solenoid.
2011-08-03 added flat solenoid folders.
2011-08-04 Restored archive of 2011 CAD
2011-08-05 Editted Flat Solenoid SLD.
2011-08-06 convert angular velocity and acceleration to Angles, add very simple path time estimate function
2011-08-09 Removed the two slots for solenoids on Base Plate.
2011-08-09 Hide all components in Full Assembly besides Base Plates and Drive Trains.
2011-08-09 Inserted Flat Solenoid Assembly into Full Assembly.
2011-08-09 Roughly fitted Flat Solenoid into space.
2011-08-10 Shortened flat solenoid's length.
2011-08-10 Shortened flat solenoid assembly length to 70 mm.
2011-08-10 Shortened sides from 10mm to 7mm.
2011-08-10 Changed all sides of flat solenoid to 10mm wide.
2011-08-10 Moved flat solenoid to centered position in the full assembly.
2011-08-10 Moved flat solenoid's position to approximately the center.
2011-08-11 Related the dimensions of flat solenoid parts to one another through equations.
2011-08-11 Changed flat solenoid's dimension.
2011-08-11 Moved solenoid to roughly the center.
2011-08-11 Changed to a different viewing angle. No change in solenoid dimensions.
2011-08-11 Created 4 through-all holes in flat solenoid model.
2011-08-16 Changed flat solenoid 'extra support' to 8mm.
2011-08-16 Updated Mech budget 2012 adding price of solenoid cores
2011-08-18 Updated the Mech budget. Summed up individual component costs and corrected flat solenoid costs.
2011-08-18 added aggressiveness parameter to PID6 PID now looks at path times
2011-08-21 Added Motor mount 1.1.SLDPRT to Mech/2012 CAD for Sandy to review
2011-08-22 Added a mech NMP: emergency stop housing
2011-08-22 Added a mech NMP: solenoid winder
2011-09-04 inputs to kalman are now velocities and added parameters to deal with acceleration time constants
2011-09-10 added some kick data
    [moded.csv]
2011-09-14 Add buttons to import and export logs to avoid people having to find the directory themselves.
2011-09-15 Updated the CAD for the Motor mount. Made the thickness constant
2011-09-16 modified solenoid model to be functional in octave
2011-09-17 model SOLENOID2 added some plot titles modified core saturation
2011-09-17 [Dribbler Test Board] initial commit
    [dribbler_testboard.sch]
2011-09-23 Removed the hole in the motor mount to see if uni-axle was possible
2011-09-23 Added possible version of motor mount.
2011-09-26 Finished motor mount dimensioning for prototyping, as well as added it to the drive train to see how it fits in the full assembly
2011-10-01 updated changes to dribbler to show mounting of the breakbeam + fixed the old cad somewhat to use as my own sandbox since we will be starting a new cad for 2012 anyway
2011-10-01 fixed more errors in the CAD ^______^
2011-10-03 -Marked "taken" project proposals off (they have been picked by new members already) -Added a project proposal for a radio dongle enclosure
2011-10-08 Added suppressed feature to midplate (cut inner circle to make the plate a ring)
2011-10-08 Created a simple base plate from which more detail can be added as necessary.
2011-10-08 Added full assembly
2011-10-08 Updated full assembly
2011-10-08 Added very rough chipping plate to find approximate dimensions
2011-10-09 new navigator that controller the flow of robots that drives in a straight line
2011-10-13 Shaved front of base plate (rough)
2011-10-14 dribbler test board initial checkin
    [dribbler_testboard.brd, dribbler_testboard.sch]
2011-10-14 Changed the base plate Christian to Solidworks 2011 version
2011-10-14 missing connections added to dribbler testboard pcb
    [dribbler_testboard.brd]
2011-10-19 Updated solenoid winder project to include collaboration with an Elec member.
2011-10-22 Decreased width of chip plate to accomodate pivot tabs
2011-10-22 Updated baseplate and motor mounts for prototyping
2011-10-22 Added pushbuttons to the board
    [dribbler_testboard.brd, dribbler_testboard.sch]
2011-10-22 - created new dribbler assembly WITHOUT THE EDUCATION VERSION BS
2011-10-23 Updated the motor mounts and added the DriveTrainAssemblyChristian.SLDASM to see how assembly looks
2011-10-25 Added files for prototyping chipper prototype
2011-10-25 - Added old open house event files - Organized and added all logos (current and obsolete) - Added Presentations
2011-10-25 - Added Print Media (business cards, jerseys, etc) - Added some sample images for marketing
2011-10-25 - Deleted some old PR materials
2011-10-25 -added lots of goodies to the dribbler assembly (roller, bearings, pins, pivot base etc.) -don't know why this is modifying stuff in tags folder though
2011-10-25 Added cuts to chipper plate
2011-10-25 Adjusted length of chipper plate (closer to ground)
2011-10-25 -Widened cut for kicker in chip plate -Made rough outline of test kicker head
2011-10-27 -Renamed "Drawings" to "2011 Drawings", and made a folder for 2012 Drawings -Added DXFs (revision 000) for chicker Prototype A
2011-10-27 Added in drawings for a hole I need drilled into 2011 dribbler side plates for Chicker prototype A
2011-10-27 Updated chicker prototype drawings to include dribbler hole diameter.
2011-10-29 Updated base plate assembly with drive train.
2011-10-29 Added solenoid core slot into kicker head.
2011-10-29 Added revision 1 of kicker heads for chicker prototype A. It adds a clearance hole for fastening with the solenoid core.
2011-10-30 Updated CAD for the drive train assembly.
2011-10-30 Created a possible motor mount for newer solenoids and non-existing capacitor plate.
2011-10-31 Added silkscreen description for connectors, added decoupling for motor connector and more LEDs
    [dribbler_testboard.brd, dribbler_testboard.sch]
2011-11-02 Fixed motor mount thickness
2011-11-02 Added DXF files for WJ/manufacturing (prototypes) of motor mounts
2011-11-02 Updated the third design of the motor mount
2011-11-04 Added debouncing to pushbuttons
    [dribbler_testboard.brd, dribbler_testboard.sch]
2011-11-04 Fixed dribbler test board border
    [dribbler_testboard.brd]
2011-11-04 Fixed borders on PCB edge for dribbler testboard
    [dribbler_testboard.brd]
2011-11-05 If the ball velocity is below a certain threshold then go to it on the first interval
2011-11-10 updated drive train CAD for documentation
2011-11-10 Created SLDPRT for Plunger 20mmx40mm, M3 tap hole
2011-11-10 Changed M3 tap hole position.
2011-11-10 change to through-all tap hole
2011-11-10 plunger thickness = 3.57mm
2011-11-10 no changes (18mm x 90mm x 3.57mm , M3x0.5 tap hole 4.5mm from edge)
2011-11-10 changed Plunger to 28mm x 90mm
2011-11-10 Added Hole Callout, corrected dimension in inches
2011-11-10 Changed M3 clearance hole to "Through All" and "Close".
2011-11-10 changed thickness to 3mm. Changed width to 18 mm.
2011-11-10 Edited thickness to 3mm
2011-11-10 Edited thickness to 3mm.
2011-11-10 Changed file name (thickness to 3mm) for all plunger drawings / dxf files.
2011-11-10 changed width to 28mm
2011-11-10 Created drawing with full dimensions for Chip Plate.
2011-11-12 -fit 2012 dribbler wip into 2012 full assembly
2011-11-14 Kicker head slot width changed to 19mm from 25mm
2011-11-14 Updated project proposal for solenoid winder (increased budget and finalized deadline)
2011-11-16 Created the Drive Train folder under 2012 Drawings. Created a dimensioned drawing for Motor Mount 1.3 SLDPRT. Created PDF for MotorMount1.3.
2011-11-16 Moved Motor mount 1.1.DXF and Motor mount 1.3.DXF to folder 2012 Drawing.
2011-11-16 Moved Motor mount 1.1.DXF and Motor mount 1.3.DXF to folder Drive Train under 2012 Drawings.
2011-11-18 Renamed radio dongle enclosure projec tproposal to show that it's TAKEN (by Milind)
2011-11-19 changed dimension names in Equation. Adjust some dimensions to match current prototypes.
2011-11-19 Adjusted dimensions to fit current prototype model.
2011-11-20 -figuring out lateral position sensor stuff on dribbler assembly -aligned baseplate on fullassembly cad
2011-11-21 Deleted M3 clearance holes.
2011-11-21 Replaced clearance system with slots. Deleted linear pattern, mirroring, and all mates.
2011-11-21 Rebuilt the whole solenoid model with "linear pattern" and "mirroring".
2011-11-21 Added Clip.SLDPRT to the assembly.
2011-11-21 Attached 4 clips to the solenoid assembly.
2011-11-21 Fixed dimensions of the solenoid assembly.
2011-11-22 changed slot from 2mm to 2.1mm to accommodate the waterjet taper.
2011-11-22 Created PDF and DXF files for Short Side with 2.1mm slot
2011-11-22 Created PDF and DXF for Long Side with 2mm slot.
2011-11-22 Created PDF and DXF for Long Side with 2.1mm slot.
2011-11-22 Created PDF for solenoid assembly.
2011-11-22 Changed slot back to 2mm.
2011-11-23 Changed related dimension to 2.1mm for Body and Clip. Created PDF and DXF of changed SLDPRT.
2011-11-24 Created the SLDPRT for the solenoid attachment to plates.
2011-11-25 Add STM32 datasheets.
2011-11-28 Add STM32 bootloader DFU file format specification.
2011-11-29 Changed pieces' thickness to 1.63. Redoing whole assembly to fix mating issues.
2011-11-29 Updated the full assembly and base plate for drive train.
2011-11-29 deleted copies of motor mounts and base plate named christian
2011-11-29 Updated Motor mount to base plate holes' location
2011-11-30 Created right side of drive train and changed positioning of motor mounts
2011-11-30 Created a mirrored motor mount for right side of the robot
2011-11-30 Increased number of pieces of support. Confirmed the number of pieces needed for centering kicker and wraping all wire.
2011-11-30 Inserted solenoid.
2011-12-01 Fixed motor mount hole location for new base plate, and updated full assembly
2011-12-01 Changed drive train assemblies from mech 2011 to mech 2012
2011-12-01 Updated motor mount material and width of it
2011-12-01 Fixed base plate rotation in full assembly and updated the motor mount material for right side
2011-12-01 Fixed issue of missing piece for motor mount right side
2011-12-01 Updated ground floor for drive train assembly
2011-12-01 made rectangular slot to base plate, mated solenoid to base plate
2011-12-01 widened solenoid support. deleted a mate between solenoid and baseplate.
2011-12-01 Redid one of the solenoid mate with distance.
2011-12-01 finished mating solenoid to base plate
2011-12-01 Added a plane for positioning clearance holes.
2011-12-01 created 3 M3 clearance holes.
2011-12-01 created M3 tap holes on base plate corresponding to the solenoid M3 clearance holes.
2011-12-01 fixed solenoid clip mating problem.
2011-12-01 added fillet to solenoid pieces.
2011-12-01 redefined y axis.
2011-12-01 redirected y axis. got assembly back into its correct shape.
2011-12-01 holes, fillets, mates, all pieces done. dimensions checked.
2011-12-03 inserted plunger and fix its position as the initial position into solenoid.
2011-12-03 reinserted and mated the plunger into solenoid
2011-12-04 inserted nonferrite part into solenoid assembly
2011-12-04 inserted the push solenoid into the solenoid assembly
2011-12-04 switched the names of Plunger_Pull.SLDASM and Plunger_Push.SLDASM
2011-12-04 mated push-plunger with solenoid assembly
2011-12-04 marked the 35mm line on the plunger
2011-12-04 saved a solenoid assembly with the push plunger as the Flat Solenoid/Flat_Solenoid_Assembled_Push.SLDASM
2011-12-04 Created Flat Solenoid/Flat_Solenoid_Assembled_Pull.SLDASM
2011-12-04 mated the pull-plunger with the solenoid assembly in Flat_Solenoid_Assembled_Pull.SLDASM
2011-12-04 Switched names between Flat_Solenoid_Assembled.SLDASM and Flat_Solenoid_Assembled_Pull.SLDASM.
2011-12-05 correctly named the flat solenoid files
2011-12-05 inserted pull solenoid into fullassembly
2011-12-05 deleted pull solenoid from fullassembly
2011-12-05 decreased number of pieces for push solenoid. fixed equations errors in push solenoid file
2011-12-05 Created plates for solenoid shell.
2011-12-06 Updated the location to a rough estimate of the middle plate connectors
2011-12-10 deleted all flat solenoid files
2011-12-10 Lowered the position of the motors relative to the base plate and put the cantilever in the front concentric with plate axis
2011-12-10 Created the short sides for push and pull solenoid
2011-12-10 Created assembly for pull flat solenoid.
2011-12-10 created assembly for push flat solenoid.
2011-12-10 Created SLDPRT for body, clip, long, support for both push and pull flat solenoid.
2011-12-10 set the dimensions of long_push. inserted long and body into assembly.
2011-12-10 set dimensions for short side. inserted 2 short into assembly.
2011-12-10 mated components within assembly.
2011-12-10 deleted solenoid assembly from fullassembly.
2011-12-11 added fillet and set dimensions for support SLDPRT. mated supports to assembly.
2011-12-11 set dimensions for clips and mated clips with assembly_push
2011-12-13 inserted plunger into push_assembly.
2011-12-13 committing in case SLDWRKS doesn't work.
2011-12-13 optimal ferrite insertion = 31 , extra length = 4 , nonferrite length = random
2011-12-13 fixed mysterious mating problem with plunger in solenoid.
2011-12-13 set dimensions of solenoid slot on base plate with equations.
2011-12-13 fixed mysterious linear pattern problem with pushsolenoid assembly. mated pushsolenoid with baseplate.
2011-12-13 added stopper 'device' to push plunger
2011-12-14 stopped working again. this commit may include the mating of lateral position between plunger and solenoid (push).
2011-12-14 Deleted all previous drawings for solenoid assem to avoid confusion.
2011-12-14 Added 0.5mm fillet to some edges.
2011-12-14 Created clearance hole on support pieces for baseplate attachment.
2011-12-14 Adjusted clearance hole position on support pieces. Created "DownAxis" vs. "UpAxis" to try fix the mysterious linear pattern problem.
2011-12-14 Added 0.5mm fillet to all suitable edges. lengthened distance between clip's 2 sides.
2011-12-14 created tap holes on baseplate for solenoid.
2011-12-14 Created SLDDRW, PDF, and DXF files for manufacturing push solenoid housing.
2011-12-16 added CAD for stainless steel + ferrous kicker solenoid plunger
2011-12-16 Added tetris T kick plunger to full assembly, removed kicker head from prototype A
2011-12-18 (pull) insert into assembly and set dimensions of body, clip, long, and short part.
2011-12-19 Created a foam and temporary M3 fastener for pull solenoid.
2011-12-19 Added in stopper mechanism into pull solenoid.
2012-01-10 - Fixed Motor mount 1.3.SLDPRT encoder holes
2012-01-11 Mated kicker solenoid to base plate.
2012-01-14 Moved push solenoid 2mm closer to front. Changed mates (solenoid and base plate) to fix error from change above.
2012-01-26 Moved the solenoid to be 22.5mm from the front edge of the BasePlate Altered the shape of the plunger/kicker head (such that initial position is >10mm from ball, length accounts for welding and the s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
2012-01-28 parallel sensor updates
    [sensor.brd, sensor.sch]
2012-01-28 parallel sensor again...
    [sensor.brd]
2012-01-28 parallel sensor again
    [sensor.brd, sensor.sch]
2012-01-28 Add ability to float the capacitors rather than always charging or discharging them.
2012-01-29 Revert r6502 as it breaks the code.
    [motor.vhd, top.vhd]
2012-01-29 Created Clip2 and changed the push solenoid assembly for using the laser cutter.
2012-01-29 Correctly mated push solenoid assembly to fullassembly.
2012-01-29 Created drawing files for all new and old parts of push solenoid.
2012-02-01 Edited dimensions for new kicker solenoid model.
2012-02-01 Edited Solenoid dimension
2012-02-01 Put Pull solenoid dimensions on push solenoid.
2012-02-01 added 0.5mm fillet on Plunger.SLDPRT
2012-02-01 change to kicker solenoid version with chipper solenoid design.
2012-02-01 drawings for chipper and kicker solenoid housing pieces and plunger
2012-02-01 created a shorter version of plunger for pull solenoid.
2012-02-03 Switch to using Octopart for DigiBOM.
2012-02-04 Added temporary CAD of chipper solenoid, and its advanced mates to the chipper.
2012-02-04 Bent sides of chipper (less likely to bend when hitting ball). Updated "cut" in chipper for solenoid plunger to slide along.
2012-02-04 Lots of changes uploaded now since Tortoise wasn't working till 2am!!!!!!!! -made chipper subassembly (rather than assembled in full assembly) -changed chipper solenoid distance from pivot (so plunge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
2012-02-04 - new baseplate and assembly
2012-02-04 - added breakbeam cad files
2012-02-04 Added a ghettoass way of supporting the angled chipper solenoid
2012-02-04 "par sensor update"
    [sensor.brd]
2012-02-04 par sensor
    [sensor.brd]
2012-02-09 - fixed ball position relative to ground plane and dribbler
2012-02-09 Narrowed and added cutouts to chipper plate to stop interference with front wheels
2012-02-11 - adjusted some stuff in Dribbler (bumper position, added new space above for changing up the spring position)
2012-02-11 Spring removed.
2012-02-11 Fix another socket address issue.
2012-02-11 don't generate path to catch ball only if ball intersection isn't found and the ball's velocity is over some threshold
2012-02-12 Add connector datasheet.
2012-02-12 Modified to reduce weight and moved shaft hole to the top.
2012-02-12 Side plates are modified to reduce weight and moved shaft hole to the top. Added midplate mount for springs.
2012-02-13 Added rear drive train to 2012 cad
2012-02-13 Updated all assemblies to add rear drive train assembly
2012-02-14 Added new gears and commercial parts folder to drive train folder. Also updated the base drive train to show new gears with gear ratio of 5:4
2012-02-15 Updated and fixed distance of front drive trains to the ground. Now wheels are indeed "on" the ground...
2012-02-18 Added final pinion to the assembly and updated it
2012-02-18 - updated the dribbler assembly with shaft diameter and side plate geometry
2012-02-20 - updated dribbler cad - updated Requisition Form.xlsx again...
2012-02-22 Changed MountingToPlateScrew Sketch
2012-02-22 Saved with full assembly, no idea why.
2012-02-22 Moved the hex nuts on dribbler midplate mount.
2012-02-24 - updated the dribbler mid plate holes
2012-02-27 add datasheet of led and photo-transistors pair used in new breakbeam. photo diode datasheet is added for future reference
2012-02-28 Edited pull solenoid Body, deleted support and clip.
2012-02-28 Edited pull solenoid Assem
2012-02-28 shape-wise ready for pull solenoid.
2012-02-28 edited assem for pull solenoid
2012-02-29 finished pull solenoid assem.
2012-02-29 Created stands for Pull Solenoid
2012-02-29 RENAMED ASSEMBLY FOR PULL SOLENOID
2012-02-29 add board edge and screw holes
    [breakbeam.brd, breakbeamreceiver.brd]
2012-02-29 2 slots ready for slanted stand
2012-02-29 inserted chipper solenoid and stand into full assembly
2012-03-01 Move PCB edges on breakbeam receiver from Eco2 layer to PCB Edges layer.
    [breakbeamreceiver.brd]
2012-03-01 Small tweaks to get values and part numbers right on sensor and break beam boards.
    [breakbeam.sch, breakbeamreceiver.sch, sensor.sch]
2012-03-01 Fix a couple of DigiBom messages.
2012-03-03 Added Back Plate drawing
2012-03-03 Added Back Plate water jet drawing
2012-03-03 Added material used in the drawing
2012-03-03 Update full assembly
2012-03-03 Updated full assembly 2011
2012-03-05 Added the chicker back into the full assembly. Organized features into folders.
2012-03-05 Fixed height of chipper solenoid
2012-03-05 Added screws for attaching the chipper to the base plate
2012-03-05 Modified chipper plate (cutout for kicker). Changed chipper base to require a nut and bolt (instead of a threaded hole + screw)
2012-03-07 deleted 4 holes on slanted slab for solenoid chipper stand
2012-03-07 changing stand design for chipper solenoid.
2012-03-07 coming up: adjustment of chipper solenoid stand within fullassembly.
2012-03-07 deleted useless push solenoid file
2012-03-07 renamed files within push solenoid (FS_Kick)
2012-03-07 primarily finished kicker solenoid shape and size
2012-03-07 deleted solenoid slot and related equations
2012-03-08 using hanger instead of stand for chipper solenoid.
2012-03-08 added 10mm fillet to chipper solenoid
2012-03-08 Changed length of kicker plunger to correspond with new kicker solenoid position
2012-03-09 partially fixed the solenoids problem.
2012-03-10 Widened cut in chipper to accommodate new shape of chipper plunger.
2012-03-10 Narrowed kicker plunger to accommodate new solenoid width.
2012-03-10 Cut back corners of chipper so as to not interfere with new height of back wheel motors
2012-03-10 Added 2011 motor mounts model to 2012 folder
2012-03-10 Added wheel folder to 2012 folder
2012-03-10 Added part encoderpinion to commercial parts
2012-03-10 Added cantilever shaft to 2012 folder
2012-03-10 Added motor to 2012 folder
2012-03-10 Updated full drive train assembly
2012-03-10 Updating drive train.. Removed it from the full assembly for now
2012-03-10 Updated drive train assembly right and left. Removed the original one that I used previously
2012-03-10 Removed base drive train. Now mating parts directly into full assembly
2012-03-10 Added Motor mount/MotorMount,FrontRight2011.SLDPRT
2012-03-10 Deleted Motor mount 1.3 Right.SLDPRT
2012-03-10 Updated the full drive train assemblies
2012-03-10 smoothened chipper solenoid plunger
2012-03-10 Removed rear drive train assembly and now have 2 different ones for left and right
2012-03-10 Updated the mates in the full drive train assembly right
2012-03-10 Updated full assembly, added the drive train assembly
2012-03-10 Added motor mounts left and right for rear
2012-03-10 Updated Motor mount/MotorMount,FrontRight2011.SLDPRT
2012-03-10 Added rear left motor mount
2012-03-10 Deleted old motor mount design from June 2011
2012-03-10 Put drivetrain into a folder in the full assembly.
2012-03-10 Increased length of cut for screw to acommodate M3x0.5x12
2012-03-10 Fixed sketch relations on base plate
2012-03-10 Added drawings for the chipper plate
2012-03-14 deleted all previous flat solenoid drawings to avoid confusion.
2012-03-14 Moved bending guides on chipper plate to appropriate spot. made width of slots consistent (1.5mm)
2012-03-14 Added drawings and DXF for revised chipper plate (see prev revision) Fixed advanced mating in chipper plate
2012-03-15 Add MCP3004 schematic symbol.
2012-03-15 Add LD1117D33 schematic symbol.
2012-03-15 WIP mainboard.
    [adc.sch, chicker.sch, dribblerconn.sch, flash.sch, fpga.sch, main.sch, motordriver.sch, oscillator.sch]
2012-03-15 done basic drawings for solenoid.
2012-03-16 Fixed dia hole in chipper base to fit igus bearings (changed from 3mm to 4.5mm) Updated drawings to match ^
2012-03-16 Updated encoder pinion assembly with new pinion
2012-03-16 Updated drivetrain
2012-03-17 Added MotorMount,FrontLeft2011 Drawing
2012-03-17 Added MotorMount,FrontLeft2011_Aluminum_1_000 pdf drawing
2012-03-17 Updated both rear motor mounts to fit new pinion
2012-03-17 Updated the full assembly 2012 with the new drive train/pinion 70:36
2012-03-17 Added drawings for the rear motor mount, both SW and pdf
2012-03-17 Use SO8E-LONG_PADS footprint for LD1117D33.
2012-03-17 Mainboard WIP.
    [adc.sch, chicker.sch, dribblerconn.sch, flash.sch, fpga.sch, main.sch, motordriver.sch, oscillator.sch]
2012-03-17 removed new pinion to insert again..
2012-03-17 Added drawings (pdf and dxf) for all motor mounts.
2012-03-17 changed screw plate
2012-03-17 Added Cad files for solenoid winder
2012-03-17 Add NKK A series switches datasheet.
2012-03-17 Added screw plate drawings
2012-03-17 - updated standoff holes
2012-03-19 Created upper case and made a new copy of horiz. stand clip
2012-03-19 inserted upper case.
2012-03-19 Created Bottom Case.SLDPRT
2012-03-19 finished slot for bottom case.
2012-03-19 Fixed Bottom Case' Constraint Issue.
2012-03-20 edited mid and base plates for appropriate holes
2012-03-21 Rework power inlet and switching and attach break beam LED to a GPIO.
    [adc.sch, chicker.sch, dribblerconn.sch, flash.sch, fpga.sch, main.sch, motordriver.sch, oscillator.sch]
2012-03-21 Add a PICkit2 ICSP header attached to the SPI Flash.
    [adc.sch, chicker.sch, dribblerconn.sch, flash.sch, fpga.sch, main.sch, motordriver.sch, oscillator.sch]
2012-03-21 Add an MRF24J40MB.
    [adc.sch, chicker.sch, dribblerconn.sch, flash.sch, fpga.sch, main.sch, motordriver.sch, oscillator.sch]
2012-03-21 Update the chicker sheet with the new connector layout and add a spare firing channel.
    [adc.sch, chicker.sch, dribblerconn.sch, flash.sch, fpga.sch, main.sch, motordriver.sch, oscillator.sch]
2012-03-21 Add pull-up resistors to dribbler Hall sensor lines.
    [adc.sch, chicker.sch, dribblerconn.sch, flash.sch, fpga.sch, main.sch, motordriver.sch, oscillator.sch]
2012-03-21 Add a fuse.
    [adc.sch, chicker.sch, dribblerconn.sch, flash.sch, fpga.sch, main.sch, motordriver.sch, oscillator.sch]
2012-03-21 Add some LEDs.
    [adc.sch, chicker.sch, dribblerconn.sch, flash.sch, fpga.sch, main.sch, motordriver.sch, oscillator.sch]
2012-03-21 Clean up the dibbler harness and add a connection for the lateral position sensor.
    [adc.sch, chicker.sch, dribblerconn.sch, flash.sch, fpga.sch, main.sch, motordriver.sch, oscillator.sch]
2012-03-21 Decouple the Hall sensors and optical encoders.
    [adc.sch, chicker.sch, dribblerconn.sch, flash.sch, fpga.sch, main.sch, motordriver.sch, oscillator.sch]
2012-03-21 Add a header on PROGRAM_B to allow holding the FPGA unconfigured while accessing Flash.
    [adc.sch, chicker.sch, dribblerconn.sch, flash.sch, fpga.sch, main.sch, motordriver.sch, oscillator.sch]
2012-03-21 Bypass the FPGA as per its manual.
    [adc.sch, chicker.sch, dribblerconn.sch, flash.sch, fpga.sch, main.sch, motordriver.sch, oscillator.sch]
2012-03-21 Beef up the logic/chicker domain master FET.
    [adc.sch, chicker.sch, dribblerconn.sch, flash.sch, fpga.sch, main.sch, motordriver.sch, oscillator.sch]
2012-03-21 Switch MCP1416s to 1415.
    [adc.sch, chicker.sch, dribblerconn.sch, flash.sch, fpga.sch, main.sch, motordriver.sch, oscillator.sch]
2012-03-22 Add BATTERY_INLET, WM7629CT-ND, and A27xP footprints.
2012-03-22 Fix footprint for AO4616.
2012-03-22 Do component footprint selection and fix some components to have proper DigiKey part numbers.
    [adc.sch, chicker.sch, dribblerconn.sch, flash.sch, fpga.sch, main.sch, motordriver.sch, oscillator.sch]
2012-03-23 Rename TBOTS_TQFP144 footprint to TQFP144 (cleaner).
2012-03-23 Rename SO8E-LONG_PADS to SO8E (cleaner).
    [adc.sch, chicker.sch, dribblerconn.sch, flash.sch, fpga.sch, main.sch, motordriver.sch, oscillator.sch]
2012-03-23 Clean up a couple of SOT23 footprints.
    [chicker.brd]
2012-03-23 Remove BAT54JW as we no longer use it, and the two SOT363 footprints.
2012-03-23 Remove unused SOT89 footprint.
2012-03-23 Add ECS-2033 footprint.
2012-03-23 WIP PCB layout.
    [adc.sch, chicker.sch, dribblerconn.sch, flash.sch, fpga.sch, main.brd, main.sch, motordriver.sch]
2012-03-26 all holes on mid and bottom plates are ready, just need to check those for fs
2012-03-28 Add new FPC connector footprint.
2012-03-28 Use new FPC connector footprint.
    [adc.sch, chicker.sch, dribblerconn.sch, flash.sch, fpga.sch, main.brd, main.sch, motordriver.sch]
2012-03-28 Explode components.
    [main.brd]
2012-03-29 Fix which field contains the DigiKey part # for 74HC4050.
    [adc.sch, chicker.sch, dribblerconn.sch, flash.sch, fpga.sch, main.sch, motordriver.sch, oscillator.sch]
2012-03-29 Add SO16E footprint with local customizations for easier soldering.
2012-03-29 Switch to CD4504BM level shifters instead of MCP1415 FET drivers.
    [adc.sch, chicker.sch, dribblerconn.sch, flash.sch, fpga.sch, main.sch, motordriver.sch, oscillator.sch]
2012-03-29 Bring in the new level shifters and explode them.
    [main.brd]
2012-03-29 Use the ADC 3.3 V regulator for the break beam and thermistor dividers instead of the dirtier main 3.3 V rail.
    [adc.sch, chicker.sch, dribblerconn.sch, flash.sch, fpga.sch, main.brd, main.sch, motordriver.sch]
2012-03-29 Allocate ADC channels.
    [adc.sch, chicker.sch, dribblerconn.sch, flash.sch, fpga.sch, main.sch, motordriver.sch, oscillator.sch]
2012-03-29 Fix backwards FET in power control circuit.
    [adc.sch, chicker.sch, dribblerconn.sch, flash.sch, fpga.sch, main.sch, motordriver.sch, oscillator.sch]
2012-03-29 Add bypass cap for MRF24J40MB.
    [adc.sch, chicker.sch, dribblerconn.sch, flash.sch, fpga.sch, main.sch, motordriver.sch, oscillator.sch]
2012-03-29 Set SM0805 footprint for new cap.
2012-03-29 Allocate MISO, MOSI, and SPI clock pins on FPGA.
    [adc.sch, chicker.sch, dribblerconn.sch, flash.sch, fpga.sch, main.sch, motordriver.sch, oscillator.sch]
2012-03-29 Board WIP.
    [main.brd]
2012-03-31 Added Base Plate drawings
2012-03-31 Added base plate drawings (for reals)
2012-03-31 a ring for mid plate
2012-04-02 Mainboard routed.
    [adc.sch, chicker.sch, dribblerconn.sch, flash.sch, fpga.sch, main.brd, main.sch, motordriver.sch]
2012-04-03 created screwplate with no cross
2012-04-03 drawings for screw plate.
2012-04-03 HOUSING PIECES WITH TABS
2012-04-04 deleted missing-holes midplate drawing
2012-04-04 Update ADG3123 to have more-accessible power rail pins on the schematic symbol.
2012-04-04 Switch to ADG3123 level shifters for FETs.
    [adc.sch, chicker.sch, dribblerconn.sch, flash.sch, fpga.sch, main.brd, main.sch, motordriver.sch]
2012-04-04 Add revision keyword to silkscreen layer of mainboard.
    [main.brd]
2012-04-04 Changed dimensions of sensor mount, side plate and side plate motor.
2012-04-06 DigiBOMize mainboard.
    [adc.sch, chicker.sch, dribblerconn.sch, flash.sch, fpga.sch, main.sch, motordriver.sch, oscillator.sch]
2012-04-06 Rename a project.
    [sensor_harness_sch.sch]
2012-04-06 Rename file to match directory.
    [dribbler_harness.sch]
2012-04-06 M2 clearance holes for kicker solenoid on baseplate.
2012-04-06 1 mm reduce on slanted support
2012-04-06 stand changed from 2mm to 1mm
2012-04-07 Move part numbers for dribbler harness into schematic instead of misc bom.
    [dribbler_harness.sch]
2012-04-07 Rename "sensor" directory to "lateral_sensor.
    [lateral_sensor.brd, lateral_sensor.sch]
2012-04-07 Reorganize some electronics directories.
    [adc.sch, chicker.brd, chicker.sch, dribbler_harness.sch, dribblerconn.sch, flash.sch, fpga.sch, lateral_sensor.brd]
2012-04-07 Include lateral sensor connector in dribbler_harness.
    [dribbler_harness.sch]
2012-04-07 Move optical encoder connections into a schematic.
    [optical_encoder.sch]
2012-04-07 Move stuff for the solenoid into a schematic.
    [solenoid.sch]
2012-04-07 Set fake DigiKey part # for kicker solenoid.
    [solenoid.sch]
2012-04-07 Massively clean up the connectors datasheets.
2012-04-07 Fixed the wheels
2012-04-07 Updated all chipper drawings with material specified.
2012-04-08 Pull new STM32F4 datasheets.
2012-04-17 Changed dimensions of mount to mid plate and sensor mount. Deleted unnecessary files.
2012-04-18 changed plunger thickness to 3.175mm and renamed plunger files.
2012-04-18 Changed dimensions of holes and slots for dribbler.
2012-04-18 adjusted baseplate slot for kicker solenoid.
2012-04-19 changed M2 tap holes to clearance holes on baseplate.
2012-04-19 remated bottom case to BasePlate.
2012-04-19 changed baseplate solenoid slot length to match 95 degree bottom case
2012-04-19 - fixed base plate to make it work with the dribbler
2012-04-21 Update dribbler side plate CAD and drawings
2012-04-22 Modified chipper base to use an M2.5x10, and removed one leg.
2012-04-22 Switched sides the leg of the chipper base was on (the baseplate cut to accommodate this would be further away from cut for kicker)
2012-04-24 Updated dribbler CAD and drawings.
2012-04-24 dxf files for chipper solenoid.
2012-04-24 changed cad for chipper solenoid.
2012-04-25 shortened pdf file name for solenoid pieces
2012-04-25 renamed housing pieces for all-robot-number
2012-04-26 changed base plate mount
2012-04-27 Added CAD for a modified version of the chipper plate. This plate is extended at the front, and then bent to give it greater stiffness. This modification was in response the testing that resulted in 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
2012-04-27 Fixed revision name of the modified chipper plate.
2012-04-27 Fixed specified thickness of the chipper plate.
2012-04-27 Changed the pivot bearings for the chipper to be specced to McMasterCart part 7804K126. Changed the mount to accommodate change in dimension.
2012-04-27 Added chipper mount drawings that correspond to the change in chipper pivot bearings (specced to McMasterCart part 7804K126)
2012-04-27 revised base plate mount
2012-04-27 Changed wj feature on chicker base as Don pointed out that they would screw up water jet path. Widen the width of screw n bolt cut to have enough clearance for screw.
2012-04-28 Updated base plate mount. Added drawing for machining assist.
2012-04-29 - added spot weld plate for chipper plate
2012-04-30 - added shaft collar to dribbler
2012-04-30 cut off more from chipplate due to motor mount interference.
2012-04-30 added new chip plate dxf
2012-05-01 - minor fixes to parts before water jetting - updated mid plate drawing
2012-05-01 - edited motor mounts so that solenoid can slide out - added dxf's and ord's of various water jet files
2012-05-01 - added new solenoid plunger
2012-05-05 Corrected dribbler base plate mount position
2012-05-09 - fixed the base plate slightly for new stopper
2012-05-10 - added dxf for solenoid casings
2012-05-19 organize breakbeam folder
    [breakbeam.brd, breakbeam.sch]
2012-05-20 Add a power control circuit on the chicker board controlled by pin 7, formerly known as the "spare" pin.
    [adc.sch, chicker.brd, chicker.sch, dribblerconn.sch, flash.sch, fpga.sch, main.brd, main.sch]
2012-05-20 Disable the FPGA's built-in pullups (with option to re-enable easily later) and add a couple of resistors where needed to handle the situation sensibly.
    [adc.sch, chicker.sch, dribblerconn.sch, flash.sch, fpga.sch, main.sch, motordriver.sch, oscillator.sch]
2012-05-20 Switch to a better MOSFET for capacitor charging (much lower RDSon).
    [chicker.sch]
2012-05-20 Get part number of long-pin headers into the repo.
    [chicker.sch]
2012-05-20 Add revision number keyword substitution in chicker board.
    [chicker.brd]
2012-05-20 Add KICK and CHIP markers to chicker silkscreen to identify connectors.
    [chicker.brd]
2012-05-21 Fix footprint for dongle C1.
2012-05-21 Replace the 4 MHz crystal with an 8 MHz crystal because DFU mysteriously fails with 4 MHz.
    [dongle.sch]
2012-05-21 Switch dongle to LD1117D33 regulator.
    [dongle.brd, dongle.sch]
2012-05-21 Remove obsolete SOT89-5 footprint.
2012-05-21 Add a single-wire debug connector to the dongle board.
    [dongle.brd, dongle.sch]
2012-05-21 Add a silkscreen revision number to dongle board.
    [dongle.brd]
2012-05-21 Connect a forgotten ground pin.
    [adc.sch, chicker.sch, dribblerconn.sch, flash.sch, fpga.sch, main.sch, motordriver.sch, oscillator.sch]
2012-05-21 Make the battery ADC divider resistors larger.
    [adc.sch, chicker.sch, dribblerconn.sch, flash.sch, fpga.sch, main.sch, motordriver.sch, oscillator.sch]
2012-05-21 Reorganize SPI.
    [adc.sch, chicker.sch, dribblerconn.sch, flash.sch, fpga.sch, main.sch, motordriver.sch, oscillator.sch]
2012-05-21 One more SPI tweak.
    [adc.sch, chicker.sch, dribblerconn.sch, flash.sch, fpga.sch, main.sch, motordriver.sch, oscillator.sch]
2012-05-21 Mark configuration mode pin M0 as do-not-use.
    [adc.sch, chicker.sch, dribblerconn.sch, flash.sch, fpga.sch, main.sch, motordriver.sch, oscillator.sch]
2012-05-21 Annotate unannotated components
    [adc.sch, chicker.sch, dribblerconn.sch, flash.sch, fpga.sch, main.sch, motordriver.sch, oscillator.sch]
2012-05-21 breakbeam processor board
    [breakbeam-processor.brd, breakbeam-processor.sch]
2012-05-21 add module used in breakbeam boards
    [breakbeam-processor.sch]
2012-05-21 Fix footprints for high-to-low level shifters.
    [adc.sch, chicker.sch, dribblerconn.sch, flash.sch, fpga.sch, main.brd, main.sch, motordriver.sch]
2012-05-21 Switch to better EC16 connector footprint.
    [adc.sch, chicker.sch, dribblerconn.sch, flash.sch, fpga.sch, main.brd, main.sch, motordriver.sch]
2012-05-21 thicken traces
    [breakbeam-processor.brd]
2012-05-21 Switch to better EC16 connector footprint
    [dribbler_testboard.brd]
2012-05-21 moved breakbeam to be speedsensor, modified processor to use relative paths
    [breakbeam-processor.brd, breakbeam-processor.sch, breakbeam.brd, breakbeam.sch, breakbeamreceiver.brd, breakbeamreceiver.sch]
2012-05-21 Replace ECS-2033 oscillator (hard to solder) with ECS-3953M (bigger)
    [adc.sch, chicker.sch, dribblerconn.sch, flash.sch, fpga.sch, main.brd, main.sch, motordriver.sch]
2012-05-21 Switch to RB521G-30 Schottky diode in power control circuit for easier soldering
    [adc.sch, chicker.sch, dribblerconn.sch, flash.sch, fpga.sch, main.brd, main.sch, motordriver.sch]
2012-05-21 Switch to a surface-mount fuse
    [adc.sch, chicker.sch, dribblerconn.sch, flash.sch, fpga.sch, main.brd, main.sch, motordriver.sch]
2012-05-21 Add resistor arrays to optical encoder and Hall sensor inputs
    [adc.sch, chicker.sch, dribblerconn.sch, flash.sch, fpga.sch, main.sch, motordriver.sch, oscillator.sch]
2012-05-21 Derp, dribbler already had pullup resistors
    [adc.sch, chicker.sch, dribblerconn.sch, flash.sch, fpga.sch, main.sch, motordriver.sch, oscillator.sch]
2012-05-21 Add part numbers for headers on mainboard
    [adc.sch, chicker.sch, dribblerconn.sch, flash.sch, fpga.sch, main.sch, motordriver.sch, oscillator.sch]
2012-05-21 Move dribbler motor and harness connectors to avoid IGBT interference
    [main.brd]
2012-05-21 Add mounting holes for a standoff between the boards
    [adc.sch, chicker.brd, chicker.sch, dribblerconn.sch, flash.sch, fpga.sch, main.brd, main.sch]
2012-05-21 Add keepouts for radio module
    [main.brd]
2012-05-21 Add silkscreen markers for wheel numbers
    [main.brd]
2012-05-21 Clean up the lateral sensor
    [lateral_sensor.brd]
2012-05-21 Add revision number to lateral sensor board
    [lateral_sensor.brd]
2012-05-21 Make some unwanted silkscreen text invisible
    [lateral_sensor.brd]
2012-05-21 Move vias off pads
    [lateral_sensor.brd]
2012-05-21 Get rid of the tiny annular ring around the mechanical hole for the RURG
    [chicker.brd]
2012-05-21 Move a via out of a pad
    [main.brd]
2012-05-21 Add an ignore list to speed sensor processor board directory
2012-05-22 changes to breakbeam board
    [breakbeam-processor.brd, breakbeam-processor.sch]
2012-05-22 thicken traces in breakbeam board
    [breakbeam-processor.brd]
2012-05-22 Add second multipart for long pin male headers to ignore the second connector Add empty multipart for M3 mounting holes
2012-05-22 Add part number for SWD header
    [dongle.sch]
2012-05-22 Add part number (of empty multipart) for second (mechanical) header Add part numbers (of empty multipart) for M3 mounting holes
    [chicker.sch]
2012-05-22 Add some missing Digi-Key part numbers
    [adc.sch, chicker.sch, dribblerconn.sch, flash.sch, fpga.sch, main.sch, motordriver.sch, oscillator.sch]
2012-05-27 Added capacitor holders
2012-05-28 Implement the control request to enter bootloader mode, thus eliminating the last remaining cable plug cycle
2012-05-28 Modified capacitor holder multiple
2012-05-29 Permit status stage to start in more cases, thus increasing compatibility with slightly odd OS semantics during initial enumeration and also handling a lost-ACK case properly
2012-05-29 Modified capacitor holder. Updated full assembly
2012-05-29 Implement control transfers with IN and OUT data stages
2012-05-29 Kill a warning about an interrupt we have no use for
2012-06-01 Allow multiple ARM target names
2012-06-01 Fix screwup
2012-06-01 Implement buzzer using timer 2
2012-06-01 Change clock frequencies to allow higher SPI bit rate
2012-06-01 Separate interrupt and exception handlers into separate vector tables
2012-06-01 Let hardware ensure 8-byte stack alignment to avoid interrupt issues; set up interrupt 50 for timer 5 in every way except actually enabling the interrupt
2012-06-02 Enable clock to timer 5
2012-06-03 Cleanup; call usb_process() by interrupt
2012-06-04 Set lower-power built-in regulator scale to save a bit of power
2012-06-04 Add explicit addresses for exception and interrupt vector tables (useful in case the exception table is incomplete)
2012-06-04 Fix regulator mode setting (the register in question is behind an RCC-controlled clock domain)
2012-06-06 Rework a lot of the top-level stuff to have independently-buildable architectures for various tests
    [motor.vhd, top.vhd]
2012-06-06 Add a couple of missing files
2012-06-08 Add VPP control to be compatible with new boards
2012-06-08 Added PCB spacer
2012-06-09 updated the wheel mats
2012-06-09 Modify the SPI module to allow SPI clock ≠ host clock
2012-06-10 Add a pull-up resistor to the chicker MISO pin
2012-06-10 added some motor helper functions
2012-06-10 some adc helper functions
2012-06-10 encoder reader
2012-06-10 added device dna reading block
2012-06-10 fix a bug in device_id
2012-06-10 some more bugs, tested readout and seems more or less okw
    [top.vhd]
2012-06-10 - Added print media (brochures, posters, buttons, postcards) Thunderbots FB page logo, and NAO logos
2012-06-10 More verbose printing
2012-06-11 Disable every free kick play except for one so that they don't keep switching
2012-06-11 Added solenoid housing (one piece)
2012-06-11 Fix flow control
2012-06-11 Remove the silly stall count thing
2012-06-12 Change to work with no stall handling
2012-06-12 Bring in basic MRF dongle driver
2012-06-12 Switch to sign-magnitude in drive packet
2012-06-12 Replace slew rate with float spec for input pin
    [thunderbots.ucf]
2012-06-13 Turn on power when activating wheels or the dribbler
2012-06-13 Eliminate MOSFET shoot-through by doubling dead band time
2012-06-13 Allow the tester to both brake and coast the motors
2012-06-13 Fix bit manipulation so brake brakes rather than going closed-loop
2012-06-13 Port 2011 wheel controllers
2012-06-13 changed device id zero initialization
2012-06-13 Implement LED control in MRF tester
2012-06-13 Implement remote LED control
2012-06-13 Fix MCP3004 ADC reading code
    [mcp3004.vhd]
2012-06-14 fixed up the shift for the lfsr
    [top.vhd]
2012-06-14 bracketed to ensure correctness because of unknown priority of ternery vs OR operator
2012-06-14 Implement more of LED control and also, untested, remote firmware upgrade
2012-06-14 Fix incorrect sensitivity list
    [top.vhd]
2012-06-14 Implement transport-layer retransmission and, theoretically, charger control
2012-06-14 Implement charged LED and stopping of discharge pulses at 30 V
2012-06-15 Implement manual kicking/chipping and switch around the drive packet protocol a bit
2012-06-15 changed torque clamping
2012-06-17 Refactor capacitor dangerous status
2012-06-17 Fix a missing sensitivity list element
    [top.vhd]
2012-06-17 - Added datasheet for new Maxon EC45 motors
2012-06-17 - Cleanup of obsolete filename (Maxon EC45 (Drivetrain).pdf)
2012-06-17 Tidy up and refactor Device DNA VHDL, add a firmware API for it, and display it over the debug port at startup
2012-06-17 - Added: -- Truss CAD for NA Open -- 2008/Thunderbots Structure and Mission Outline.doc -- TLEF 2012 extension request doc -- NAO Media Advisory Draft.docx -- EDC bay field and mini-field CAD (with w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
    - Changed name of 2012 Summer (Henry's NSERC) to match naming convention
2012-06-17 Implement (untested) LED readout of break beam status and autokick arm
2012-06-18 Implement reboot at end of remote firmware burn (untested)
    [top.vhd]
2012-06-18 Implement ability to force chicker or motor power on without activating other pieces of functionality
2012-06-18 just added some comments for device dna stuff
2012-06-19 - Added: -- Old conference notes -- Old instructional material -- Presentations and meeting minutes from previous year -- Old recruitment docs -- Old sponsorship files -- Old capstone project reports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
2012-06-20 adjusted current limit value for the robots
2012-06-20 - Added May Mech ledger - Added admin job and volunteer position descriptions for recruitment
2012-06-20 Separate discharge threshold from capacitor-charged LED threshold to avoid blinking after discharge
    [top.vhd]
2012-06-20 Fix a couple of wrong bit fields
2012-06-20 - Added new logo (version 5) -- Similar to previous logo (version 3), but smaller lightning bolt and more compact text for better use of space.
2012-06-20 Add documentation of which timers are being used for what purpose
2012-06-20 adjusted the distance to velocity metric
2012-06-20 New parameters for pid 6 2012
2012-06-21 Pid 6 2012 parameter update
2012-06-21 Set goalie hug switch to true for now so that the goalie will be more in the middle of the net on enemy free kicks
2012-06-21 Switch to 4 MHz bus clock for MRF
2012-06-21 Add emergency stop switch capability
2012-06-21 changed to a linear velocity metric for pid6
2012-06-21 Coast instead of brake on estop
2012-06-22 Changed free kick pass to take a speed ratio so that you can change the power regardless of whether it's a chip or kick
2012-07-01 Use clamp_symmetric() where appropriate
2012-07-01 Switch Cacheable to use a hashtable instead of an ordered map
2012-07-01 Switch to C++-standard <chrono> for some timing stuff
2012-07-02 Get rid of the controls for the obsolete dribbler power control over XBee
2012-07-15 Add title to parameters frame in MRF tester
2012-07-19 - Added RoboFEI game notes from Mexico - Added June Mech ledger
2012-08-03 Cut sensitivity in low-sensitivity mode
2012-08-07 Added capacitor holder (horizontal) and solenoid housing (one piece)
2012-08-11 new project
    [flashburner.brd, flashburner.sch]
2012-08-26 Hardcode arm-linux-gnueabi instead of using the shell script
2012-09-17 - Added PAF and Shell final reports, Mech 2012/2013 @Home application, July and Aug ledgers, Terence's offer letter
2012-09-24 add image 7seg.png, it maps led segment to microcontroller output
2012-09-29 Move relevant connectors to the breakout board, including eliminating the thermistor and making the break beam laser permanently-driven (fixes #769, #939)
    [adc.sch, breakout.sch, breakoutconn.sch, chicker.sch, dribbler_harness.sch, dribblerconn.sch, flash.sch, fpga.sch]
2012-09-29 Change enum to reflect new usage of ADC channel zero; compile fails intentionally!
2012-09-29 Remove nonexistent ENABLE hierarchical pins
    [main.sch]
2012-09-29 Remove ADC from chicker board and route divider output to mainboard ADC instead
    [chicker.sch, fpga.sch, main.sch]
2012-09-29 Chicker emergency discharge plus power-out charged indicator LED (fixes #799 and #838)
    [chicker.sch, fpga.sch, main.sch]
2012-09-29 Remove faulty part numbers from C5, C7 (fixes #775)
    [chicker.sch]
2012-09-29 Add L6234 schematic symbol
2012-09-29 Renumber motors from zero on mainboard (fixes #776)
    [fpga.sch, main.sch, motordriver.sch]
2012-09-29 Add L6234 motor driver datasheet
2012-09-29 Switch to L6234 motor drivers (fixes #824)
    [fpga.sch, main.sch, motordriver.sch, power.sch]
2012-09-29 Replace D24 with a non-sucky diode
    [motordriver.sch, power.sch]
2012-09-29 Lengthen pads for MRF24J40M footprint
2012-09-29 Add a capacitor to +HVBATT to accomodate the capacitor coming on +BATT being behind a diode
    [power.sch]
2012-09-29 Reverse-merge r8474; stupid idea
    [power.sch]
2012-09-30 Adjust emergency discharge circuit
    [chicker.sch]
2012-09-30 Rename a net
    [fpga.sch, main.sch]
2012-09-30 Fix C6 mismatches
    [chicker.sch]
2012-09-30 Remove R57 as we will be using non-pull-up mode (fixes #944)
    [fpga.sch]
2012-09-30 Add a transient voltage suppressor (fixes #830)
    [power.sch]
2012-09-30 Add a Schottky diode to the battery monitor to prevent overvoltage
    [adc.sch, main.sch]
2012-09-30 Switch to MIC5020 for chicker level shifters
    [chicker.sch]
2012-09-30 Reverse-merge r8481; will use a different divider ratio instead
    [adc.sch, main.sch]
2012-09-30 Change battery voltage divider to avoid exceeding 3.3 V out at 30 V in
    [main.sch]
2012-09-30 Move selection of 1% resistors out into digibom
    [chicker.sch]
2012-09-30 Add two more pins to the ICSP header for the new flash burner board to use (fixes #942)
    [flash.sch, fpga.sch, main.sch]
2012-09-30 Add µSD card connector to mainboard
    [adc.sch, breakoutconn.sch, chicker.sch, dribblerconn.sch, flash.sch, fpga.sch, main.sch, motordriver.sch]
2012-10-01 Change 100 nF bypass cap on ADC supply to 1 µF as per MCP3004 datasheet
    [adc.sch]
2012-10-01 Add missing 10 nF capacitor for voltage doubler
    [main.sch]
2012-10-01 Add back-EMF diode to relay
    [chicker.sch]
2012-10-01 Add capacitors to breakout board
    [breakout.sch]
2012-10-01 Change Hall sensor pull-up resistors to 10 kR to eliminate a part number
    [dribblerconn.sch]
2012-10-01 Use 100 R on LEDs to reduce unique part numbers
    [fpga.sch]
2012-10-02 Change all the 56 and 82 ohm resistors on non-robot boards to 100 ohms to reduce part number count
    [dongle.sch, dribbler_testboard.sch, flashburner.sch]
2012-10-02 Make all resistors 1%, coalesce a few part numbers, and remove unused parts
    [breakout.sch, chicker.sch, lateral_sensor.sch, main.sch, wheelconn.sch]
2012-10-03 [DigiBOM projinfo.xml] Changed ceramic caps to X5R/X7R 50V where cost is similar. Added 220nF for L6234 charge pump.
2012-10-05 Add SOD-323F footprint
2012-10-05 Add DO-214AC footprint
2012-10-05 Annotate schematic
    [adc.sch, breakoutconn.sch, chicker.sch, dribblerconn.sch, flash.sch, fpga.sch, main.sch, motordriver.sch]
2012-10-05 Switch diodes to have fewer footprints
    [chicker.sch, power.sch]
2012-10-05 Add part number to SD card connector
    [power.sch, sdcard.sch]
2012-10-05 Pick some footprints
2012-10-05 Set a footprint
2012-10-05 Add part number for interboard connector on chicker board
    [chicker.sch]
2012-10-05 Add part numbers for three connectors
    [breakoutconn.sch, chicker.sch, flash.sch]
2012-10-05 Add a part number for a connector
    [breakout.sch]
2012-10-05 Use Octopart BOM API (fixes #955)
2012-10-06 Spec fuses
    [adc.sch, breakoutconn.sch, chicker.sch, dribblerconn.sch, flash.sch, main.sch, motordriver.sch, oscillator.sch]
2012-10-06 Switch to direct-drive LPS connections on breakout board and dribbler harness (leaving LPS for owner)
    [breakout.sch, breakoutconn.sch, dribbler_harness.sch, fpga.sch, main.sch]
2012-10-06 Add FX6 connector datasheet
2012-10-06 this is a test
    [flashburner.sch]
2012-10-06 added two more buttons
    [flashburner.sch]
2012-10-06 added diodes yayay
    [flashburner.sch]
2012-10-06 schematic saved after digibom
    [flashburner.sch]
2012-10-08 Swap buttons to ones that are in stock
    [flashburner.sch]
2012-10-13 Add SM5329 footprint
2012-10-13 Add PCB library search path and list
2012-10-13 Most footprint selections
2012-10-13 added sdcard footprint to thunderbots modules
2012-10-13 added 60 pin connector to thunderbots footprint lib
2012-10-14 added solenoid footprint
2012-10-14 Add PowerSO20 footprint
2012-10-14 Fix up FX6 footprints
2012-10-14 Finish footprint selection
2012-10-14 Add robot shell drawings as base for PCBs
    [breakout.brd, chicker.brd, main.brd]
2012-10-14 Fix M3_MOUNT footprint to use proper NPTH pad type
2012-10-14 Fix Flash programming header footprint choice
2012-10-14 Explode components
    [main.brd]
2012-10-14 Lengthen MRF24J40 pads (fixes #773)
    [main.brd]
2012-10-15 Route mainboard
    [adc.sch, breakoutconn.sch, chicker.sch, dribblerconn.sch, flash.sch, fpga.sch, main.brd, main.sch]
2012-10-15 Add screw holes
    [main.brd]
2012-10-15 Reduce size of slug to match datasheet—sinking will be done through vias
2012-10-15 Ground the slug
    [motordriver.sch]
2012-10-15 Fix a handful of board bugs and reroute
    [adc.sch, breakoutconn.sch, chicker.sch, flash.sch, fpga.sch, main.brd, main.sch, motordriver.sch]
2012-10-15 More small fixes
    [breakoutconn.sch, main.brd]
2012-10-15 Split the ground plane
    [main.brd]
2012-10-15 Increase drill size for SIL-8
    [main.brd]
2012-10-16 Do not use the power ground for the breakout connector
    [breakoutconn.sch, main.brd]
2012-10-16 Move anchor to centre of PowerSO20 footprint
    [main.brd]
2012-10-16 Add outlines to PowerSO20 footprint and move a conflicting part
    [main.brd]
2012-10-16 Add a couple of missing dimensions
    [main.brd]
2012-10-16 Route chicker board
    [chicker.brd, chicker.sch]
2012-10-16 Move a via
    [main.brd]
2012-10-16 Removed traces directly between pins
    [main.brd]
2012-10-18 Route the breakout board
    [breakout.brd, breakout.sch, breakoutconn.sch, fpga.sch, main.brd, motordriver.sch, wheelconn.sch]
2012-10-20 Tidy some traces running between adjacent pads
    [main.brd]
2012-10-20 Get rid of everything underneath the charging coil
    [chicker.brd]
2012-10-20 Add a ground plane cutout to help route high current
    [chicker.brd]
2012-10-20 Cut out the ground plane above the MRF
    [chicker.brd]
2012-10-20 Eliminate the tiny thermals on the ground plane to the IGBTs
    [chicker.brd]
2012-10-20 Make CAP+ trace to P1 equidistant between adjacent traces
    [chicker.brd]
2012-10-20 Clear more plane above the radio
    [chicker.brd]
2012-10-20 Reduce width of some power traces to increase clearance
    [chicker.brd]
2012-10-20 Random fixes
    [chicker.brd, main.brd]
2012-10-20 added 2013 cad folder
2012-10-20 added chassis folder for 2013 cad
2012-10-20 added CAD for 2013 files (base plate, new solenoid, golf ball)
2012-10-20 Add a power connector for debugging the breakout board
    [breakout.brd, breakout.sch, wheelconn.sch]
2012-10-20 Added solenoid on the baseplate
2012-10-20 Add more mounting screws
    [breakout.brd]
2012-10-20 Make slugs on PowerSO20 wider
    [main.brd]
2012-10-20 Change heatsinking vias
    [main.brd]
2012-10-21 Added SolidWorks models (breakout and main done, chicker and assembly WIP)
    [breakout_board.SLDPRT, chicker_board.SLDPRT, electrical_asm.SLDASM, main_board.SLDPRT]
2012-10-21 Finished electrical SolidWorks model
    [breakout_board.SLDPRT, capacitor_board_mounted.SLDPRT, chicker_board.SLDPRT, electrical_asm.SLDASM, main_board.SLDPRT]
2012-10-21 Moving electrical SolidWorks model to Mech as per Henry's request
    [breakout_board.SLDPRT, capacitor_board_mounted.SLDPRT, chicker_board.SLDPRT, electrical_asm.SLDASM, main_board.SLDPRT]
2012-10-22 Move solenoid connectors apart and add silkscreen labels
    [chicker.brd]
2012-10-22 Move dribbler harness connector left so it is less under the dribbler motor connector
    [breakout.brd]
2012-10-24 Updated connector locations
2012-10-26 Move connectors based on mech feedback
    [breakout.brd]
2012-10-26 Move encoder connectors and uncut two corners
    [breakout.brd]
2012-10-28 PCB DONE for now
    [flashburner.brd]
2012-10-28 Updated electrical SolidWorks model to match new breakout board shape and connector positions
2012-10-28 added kicker assembly
2012-11-03 Changed LPS schematic to use new 4 pin interface
    [lateral_sensor.sch]
2012-11-03 added spring cad
2012-11-03 mated kicker assembly to full assembly
2012-11-03 Added dribbler cad
2012-11-03 Dribbler in full assembly
2012-11-03 finished LPS schematics and began PCB routing
    [lateral_sensor.brd, lateral_sensor.sch]
2012-11-06 updated kicker stopper and chassis baseplate
2012-11-10 Fix the null-world Coordinate copy construction case
2012-11-10 [LPS] Finished routing LPS
    [lateral_sensor.brd]
2012-11-10 Unify the WHEEL_MATRIX in one place.
2012-11-10 Include the pseudo-inverse of the wheel matrix.
2012-11-12 Updated electrical assembly to reflect 5mm separation between main and breakout board
2012-11-16 Make ball filtering not suck.
2012-11-20 PCB is kind of done; look in folder Flashburner 2
    [flashburner.brd]
2012-11-23 YAYAYAYYA NEW COMMIT
    [flashburner.brd, flashburner.sch]
2012-11-24 -added chipper solidworks assemblies
2012-11-24 added new chipper parts/assemblies
2012-11-24 Added unmodified 2012 chipper plate to 2013 chipper assembly
2012-11-25 Determined new length of chipper plate
2012-11-25 Update VHDL/firmware for Eindhoven boards.
2012-11-25 Modify chipper plate dimensions
2012-11-25 Modified 2012 chipper plunger to fit 2013 chipper solenoid
2012-11-27 Motor mount was suppressed
2012-11-27 edited chipper assembly! yay
2012-11-29 Added Drive train to the full assembly
2012-11-29 Added encoder covers to parts
2012-12-03 Suppressed wheels and shafts as I'm going to be changing the CAD of it
2012-12-07 Print out the runtime types of unhandled exceptions as well as their detail messages.
2012-12-09 Update for Eindhoven prototype robot status packet layout which omits dribbler thermistor data.
2012-12-13 Updated chipper plate top edge
2012-12-13 Added drawings for the 2013 chipper plate.
2012-12-14 Fix polarity of some chicker signals and implement emergency relay control.
    [top.vhd]
2012-12-14 within the mech folder -Thunderbots Solidworks Guideline DRAFT.docx placed in resources/ -WDM for kicker 2011.xls placed in 2011 CAD/Chicker/Kicker/ -an excel file was added for torsion spring select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
2012-12-15 Add a minimum pulse width constraint due to maximum operational frequency of the MIC5020 gate drivers.
2012-12-16 added solenoid + stand
2012-12-16 Switch to new model where emergency relay is opened immediately at boot.
2012-12-22 Change maximum capacitor voltage to 240.
2012-12-30 reorganizing the mech folder (it was a bit messy) -new folders: 2011 Bot, 2012 Bot, 2013 Bot -all relevant CAD, Drawings, Reports, Docementation, etc, to a generation of bot is located in its relevan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
2012-12-30 -more reorganizing -moved contents of /Test data/ into /2011 Bot/ as they are 2011 bot development documents -moved contents of /Motor Selection/ to /2011 Bot/ as they are 2011 bot development docume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
2013-01-01 Fix the full assembly crash problem
2013-01-01 -updated the chipper and full assembly
2013-01-03 Move dribbler harness connector out from under dribbler motor connector.
    [breakout.brd]
2013-01-03 Rotate the bottom row of pads on the two 60-pin interboard connectors by 180° (allows for easier bulk editing).
2013-01-03 Reduce size of pads on FX6-60P.
    [breakout.brd]
2013-01-03 Add solder paste to FH12-11S-1SH EC45 connector mechanical stability pads.
    [breakout.brd]
2013-01-03 Move and make visible component value texts in breakout board.
    [breakout.brd]
2013-01-03 Get rid of the power gate on the chicker board.
    [chicker.brd, chicker.sch]
2013-01-03 Move and make visible component value texts on chicker board.
    [chicker.brd, chicker.sch]
2013-01-03 Use longer headers for chicker connector.
    [chicker.sch]
2013-01-03 Update mainboard schematic to reflect the fact that mainboard/chicker pin 7 is now PRESENT not POWER_CTL.
    [chicker.sch, fpga.sch, main.sch]
2013-01-03 Add interlock override jumper to mainboard schematics.
    [adc.sch, breakoutconn.sch, chicker.sch, dribblerconn.sch, flash.sch, fpga.sch, motordriver.sch, oscillator.sch]
2013-01-03 Rotate the µSD card connector.
    [fpga.sch, main.brd]
2013-01-03 Finish some unfinished routing.
    [main.brd]
2013-01-03 Make FX6-60S-0.8SV pins a millimetre shorter.
    [main.brd]
2013-01-03 Move mainboard D24 slightly north to get it further away from some vias.
    [main.brd]
2013-01-03 Move some vias out of capacitor pads.
    [main.brd]
2013-01-03 Add SO14E footprint to library with slightly longer pads, and use it on the mainboard.
    [main.brd]
2013-01-03 Move Q14 north away from the power switch.
    [main.brd]
2013-01-03 Move and rotate C48 away from possibly touching U11.
    [main.brd]
2013-01-03 Slightly increase drill size of A27xP through holes.
    [main.brd]
2013-01-03 Add a note to not order back side soldermask.
    [main.brd]
2013-01-03 Make component values visible on silkscreen.
    [main.brd, motordriver.sch, power.sch]
2013-01-03 Mark pin 1 of the power switch with a square pad.
    [main.brd]
2013-01-05 [mainboard] Moved 2 capacitor values onto silkscreen
    [main.brd]
2013-01-05 Changed SM5329 footprint to reflect actual size of resistor on silkscreen, and made pads smaller
2013-01-05 [chicker] Changed discharge resistors to use new footprint, and moved them apart + away from the relay
    [chicker.brd]
2013-01-05 -updated chipper assembly and parts
2013-01-06 working speed sensor
2013-01-07 Add FPGA control of the laser
    [breakout.brd, breakout.sch, breakoutconn.sch, fpga.sch, main.brd, main.sch]
2013-01-07 Simplify some routing.
    [main.brd]
2013-01-07 Move a standoff. Make standoff texts invisible. Move some components.
    [breakout.brd, chicker.brd, main.brd]
2013-01-07 Position-lock some standoff holes and hide some silkscreen text.
    [breakout.brd, chicker.brd, main.brd]
2013-01-10 [mainboard] Increased power supply clearance on the ADC. There's a corner DRC violation not caught by kicad.
    [main.brd]
2013-01-11 Tidy some ground traces.
    [main.brd]
2013-01-11 PCB fab does not do NPTH, so make NPTH holes into standard holes.
    [breakout.brd, chicker.brd, main.brd]
2013-01-11 [LPS] moved silkscreen refdes out of components
    [lateral_sensor.brd]
2013-01-11 Clean up Digi-Key part specs for a lot of parts. Also include M3_MOUNT parts in schematics so they get ordered.
    [adc.sch, breakbeam.sch, breakbeamreceiver.sch, breakout.brd, breakout.sch, breakoutconn.sch, chicker.brd, chicker.sch]
2013-01-11 Fix svn:ignore on speed sensor files.
2013-01-11 Add missing Digi-Key parts to schematic and Digi-Bom.
    [lateral_sensor.sch]
2013-01-12 Need better diodes for the Flash burner.
    [flashburner.sch]
2013-01-13 Modified dribbler baseplate mount and baseplate
2013-01-16 Modified base plate, removed old rubber band holder holes
2013-01-16 Decreased width of chipper plate by 2mm to 58mm.
2013-01-16 Moved pivot hole on chipper plate backwards 1.2mm
2013-01-16 Updated drawings for chipper plate
2013-01-16 Update the height to be 75mm
2013-01-16 Added top and bottom standoffs
2013-01-16 add bottom standoff
2013-01-17 [LPS] Reverse merging to r8696 for compatibility with old kicad
    [lateral_sensor.brd]
2013-01-17 Modified the mounts
2013-01-17 [LPS] adding dimensions
    [lateral_sensor.brd]
2013-01-18 Adding symbol for SPST relay
2013-01-18 Added footprint for G5CA-1A-E (SPST relay)
2013-01-18 Added HUGE PIN footprint (CONN_1). Designed for 15A.
2013-01-18 Fixing huge pin footprint
2013-01-18 [Oven Controller] Initial checkin
    [oven_controller.brd, oven_controller.sch]
2013-01-18 [Oven Controller] Improved layout (more clearance, zone fill)
    [oven_controller.brd]
2013-01-19 renamed controls directory
    [fuzzy.tsv, kick-old.tsv, one-ball-rolling-across-both-cam-multiple-times.tsv, one-ball-rolling-across-both-cam-multiple-times2.tsv, one-ball-rolling-across-both-cam-multiple-times3.tsv, one-ball-rolling-overlay-area.tsv, one-ball-rolling-straight1.tsv, one-ball-rolling-straight2.tsv]
2013-01-20 changed the power input value of the boost controller for the new mosfets.
2013-01-22 -updated chipper assembly and full assembly
2013-01-23 Modified dribbler back bar added LPS model and mount
2013-01-23 added Shell.SLDPRT, ScrewPlate.SLDPRT,
2013-01-27 Added a protector and updated the mid plate mount.
2013-01-30 Factor out USB bulk and interrupt IN endpoint handling and improve some transfer handling in some areas.
2013-01-30 -added drawings and waterjetting files for chassis and chipper mount
2013-02-02 Abstract out the bulk/interrupt OUT endpoint handling.
2013-02-07 Rework bulk/interrupt IN endpoint data handling.
2013-02-07 Adjust polling interval for debug mode interrupt notification.
2013-02-07 Change MDR endpoint from interrupt to bulk to increase potential throughput and reduce probability of scheduling issues.
2013-02-10 [mainboard] Changed motor charge pump diodes to same Schottky as the rest
    [main.sch]
2013-02-10 [chicker] moved ground via near mainboard connector slightly to not eat up silkscreen
    [chicker.brd]
2013-02-13 Make firmware faster and smaller by replacing a floating-point divide by 3 with a multiply by ⅓.
2013-02-15 footprint revised
    [flashburner.brd]
2013-02-16 added the wheel angles
2013-02-16 Removed add-ons for fastening the chipper to the base plate.
2013-02-16 Removed features to fastener chipper to base plate.
2013-02-16 Extended chipper mount towards front of robot
2013-02-17 Update for new prototype boards.
2013-02-18 Added tapped holes to chipper mount to mount to dribbler mount. Editted mates in full assembly to mate chipper mounts with dribbler mounts.
2013-02-18 Added drawings for modified 2013 chipper mount
2013-02-21 Centralize halt feature handling for IN bulk/interrupt endpoints.
2013-02-21 Centralize halt feature handling for OUT bulk/interrupt endpoints.
2013-02-21 Get rid of a no-longer-needed filter in the Makefile.
2013-02-21 Pull stuff useful for other STM32F4 projects into a library.
2013-02-21 Make device_state volatile as it can be accessed around/beside interrupt handlers.
2013-02-22 Provide the option to leave the board powered after burning a bitstream.
2013-02-22 Use the LEDs for Flash activity.
2013-02-22 Implement burning to the Flash burner’s onboard memory.
2013-02-22 Implement reporting abort causes on LEDs and translating CPU exceptions to aborts.
2013-02-23 Move resistor R2 and increase its value so that the Flash burner has precedence over the FPGA when deciding how to control board power.
    [main.brd, main.sch]
2013-02-23 Add a thermistor to the mainboard to measure motor driver ground plane temperature.
    [adc.sch, breakoutconn.sch, chicker.sch, dribblerconn.sch, flash.sch, fpga.sch, main.brd, main.sch]
2013-02-23 Make thermal vias under motor drivers bigger.
    [main.brd]
2013-02-23 [Mainboard] Moved ground plane thermistor to back side
    [main.brd]
2013-02-23 1. moved L6234 decoupling caps to the chip side of the fuses on the schematic (lower impedance to chip) 2. moved M1 and M2 phase traces down 3. moved HVBATT and VBOOT traces up (and mostly to top lay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
    [adc.sch, breakoutconn.sch, chicker.sch, dribblerconn.sch, flash.sch, fpga.sch, main.brd, main.sch]
2013-02-23 [LPS] Moved mounting holes away from components
    [lateral_sensor.brd]
2013-02-23 [Mainboard] Moving things apart where ever possible
    [main.brd]
2013-02-23 multiparts to solenoid connector
2013-02-24 Get some more clearance between traces and slugs (killed r8989).
    [main.brd]
2013-02-24 modify chicker solenoid connector to contain mating connector and crimp pins
    [breakbeam-processor.sch, chicker.sch]
2013-02-24 Don't bother disabling the SPI module between transactions (leads to better waveforms).
2013-02-24 Handle parameter tPUW for SPI Flash.
2013-02-24 Reroute signal traces away from inductor and diode conductive back.
    [chicker.brd]
2013-02-24 [Mainboard] Moved things apart where possible
    [main.brd]
2013-02-24 Change some LEDs from green to yellow for easier reading and add colour and functional labels to silkscreen.
    [adc.sch, breakoutconn.sch, chicker.sch, dribblerconn.sch, flash.sch, flashburner.brd, flashburner.sch, fpga.sch]
2013-02-24 Remove a couple of errant silkscreen texts.
    [flashburner.brd]
2013-02-24 Add an extension to the Flash burner board so it reaches the main board better. Add a pin 1 marker to the burner board. Improve the visibility of pin 1 markings on the main board.
    [flashburner.brd, main.brd]
2013-02-24 Add labels for the pushbuttons on the Flash burner.
    [flashburner.brd]
2013-02-24 Swap LPS and breakbeam inputs on main board to match their positions on breakout board.
    [breakoutconn.sch, main.brd]
2013-02-25 Handle cable plugging and unplugging while powered.
2013-02-25 [LPS] Changed dribbler harness to use the correct connector on Digikey (7 pins instead of 6 pins)
    [lateral_sensor.sch]
2013-02-25 Added components for dribbler harness to multi-part dribbler-harness-connector-and-components, and included it in breakout board.
    [breakout.sch, dribbler_harness.sch, wheelconn.sch]
2013-02-25 [Mainboard] Removed ground plane cutout, added 4x10uF to decouple motor drivers + motors
    [adc.sch, breakoutconn.sch, chicker.sch, dribblerconn.sch, flash.sch, fpga.sch, main.brd, main.sch]
2013-02-26 [Mainboard] Increased clearance on mounting holes to 1.2mm (standoff is max 5mm radius, hole is 3mm). Added soldermask off area for potential heatsink mounting.
    [main.brd]
2013-02-26 [Mainboard] Changing interboard connection holes to standard
    [main.brd]
2013-02-26 [Chicker] Increased mounting holes clearances to 1.2mm
    [chicker.brd]
2013-02-26 [FlashBurner] Moved component values out and set visible
    [flashburner.brd]
2013-02-26 [FlashBurner] Set USB post drill to standard
    [flashburner.brd]
2013-02-26 [LPS] Changing mounting holes to standard
    [lateral_sensor.brd]
2013-02-27 [Mainboard thermal] Adding mainboard thermal model
    [Assem1.SLDASM, Part1.SLDPRT, board.SLDPRT, copper.SLDPRT, heat_source.SLDPRT]
2013-02-27 Fix BOM stuff to put parts where they actually exist.
    [adc.sch, breakout.sch, breakoutconn.sch, chicker.sch, dribbler_harness.sch, dribblerconn.sch, flash.sch, fpga.sch]
2013-02-27 dos2unix ALL THE THINGS.
    [breakbeam.brd, chicker.brd, lateral_sensor.brd, main.brd, oven_controller.brd, oven_controller.sch]
2013-02-27 [Dribbler Harness] Updated phototransistor to new part (old part obsolete)
    [dribbler_harness.sch]
2013-03-01 Fix PendSV preempting hardware interrupts.
2013-03-01 [LPS] Added Digi-Key part numbers
    [lateral_sensor.sch]
2013-03-01 [projinfo] Changed default STM32 part to the better stocked STM32F415 (instead of F405)
2013-03-01 Improve dribbler mount screw access feature
2013-03-01 Modified dribbler integration holes
2013-03-02 Annotate non-PCB schematics with reference numbers so CSV BOM output works properly.
    [dribbler_harness.sch, optical_encoder.sch, solenoid.sch]
2013-03-02 Use deferred functions instead of a timer to poll the status register for write and erase completion.
2013-03-03 Enable power to SYSCFG module at startup.
2013-03-09 change male molex connector on lateral sensor to right angle version
    [lateral_sensor.sch]
2013-03-13 updated shock absorber CAD
2013-03-16 Modify CPU I/O registers to allow direct control over individual motor phases.
2013-03-16 initial stage of tri_offense works. Tri_attack primary, secondary and tertiary work. must make better
2013-03-17 [breakout board solidworks model] Fixed a hole position
2013-03-17 Created configurations in the full assembly, and updated shell and electrical board CAD
2013-03-17 fixed the misaligned hole
2013-03-18 SOLENOID WORKS NOW
2013-03-20 修改了電磁閥的一部分
2013-03-23 Removed Chicker Test Board dir
    [Chicker Test Board.brd, Chicker Test Board.sch]
2013-03-23 Added Chicker test board code+schematic
    [Chicker_Test_Board.sch]
2013-03-26 Clean up a bunch of stuff and get the testbenches back on track.
2013-03-29 Implement synchronous reset and lower clock frequency for Device DNA reader.
2013-03-30 Read device DNA once instead of 15 times at startup.
2013-03-30 Implement independent motor phase control.
2013-03-30 Do not brake for a PWM output of zero.
2013-04-06 Read and report the board temperature.
2013-04-08 Add a couple of warnings.
2013-04-12 Implement UART mode on the Flash burner.
2013-04-12 Make exception printing better.
2013-04-13 Fix polarity of writes to clear MOTOR_STATUS bits.
2013-04-14 Implement error reporting and use it to report stuck Hall sensors (detected) and non-commutating optical encoders (not yet detected).
2013-04-14 Implement SPI transceiver for SD card.
2013-04-14 Ignore serial input when external Flash chip select is asserted indicating the FPGA is talking SPI instead of serial.
2013-04-14 refactor speedsensor firmware to refer to the stm32lib
2013-04-14 Implement board and SD card presence detection.
2013-04-14 Move spi.vhd to synth/ as it uses the ODDR2 primitive which is not available in ghdl.
2013-04-14 Add command to run Trace and generate a timing report.
2013-04-14 Move indexing of the optical encoder counts from the write-to-index-register path to the read-from-data-register path to increase slack on the 40 MHz clock.
2013-04-20 Add software control of SPI CS.
2013-04-20 Implement encoder failure detection and motor coasting on encoder failures.
    [top.vhd]
2013-04-20 Update board temperature gauge when robot liveness changes.
2013-04-20 Power the drivetrain when braking, as the chips should be powered before enable goes high.
2013-04-20 Disable drivetrain power when all motors are coasting and drivetrain power is not forced on.
2013-04-20 Implement low battery shutdown.
2013-04-21 Remove average battery debug output.
2013-04-21 Added the sd card functions and the initial initialization stub to entry, this can hang if something goes very wrong, ie the card is removed in the middle of initialization.
    [thunderbots.ucf]
2013-04-27 Implement strobes on ADC lines for later use.
2013-04-29 Updated break beam mounting
2013-04-30 Add strict aliasing warnings and fix a couple of strict aliasing violations.
2013-04-30 updated break beam mount
2013-05-06 -created 2013 chipper plate reinforcement -updated 2013 midplate to stop chipper plunger from flying out from torsion springs -updated 2013 chipper plate to resolve interference with chipper plunger
2013-05-07 Update break beam handling for Ellis’s modulator.
2013-05-09 finalized das solenoid
2013-05-10 -cleaned up 2013_chipper_plate.SLDPRT CAD -Cleaned up all 2013 motor mount cad
2013-05-10 -added revision drawings for 2013 chipper plate -added revised drawings for 2013 motor mounts
2013-05-11 Colour: Made chassis dark grey
2013-05-11 Fix backwards assignment of autonomous burn buttons.
2013-05-15 Laser control is switched from software to hardware. The voltage difference between laser-on state and laser-off state is compared to a threshold to determine whether ball is present. This implementa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
2013-05-17 Add a clamp call to avoid GTK+ assertion failures on negative break beam readings.
2013-05-18 LPS now has 7-pin connector instead of 6-pin, footprint added to t-bots lib
    [lateral_sensor.brd, lateral_sensor.sch]
2013-05-18 Renaming LPS datasheet to also reflect 7-pin header
2013-05-19 fixed sensor positions and mapped them to the order found in the dribbler harness schematic. Redesigned PCB with thicker traces and matching ordering of OPB parts
    [lateral_sensor.brd, lateral_sensor.sch]
2013-05-19 added datasheet for right-angled 7-pin molex connector for LPS
2013-05-21 Reverse-merge r9284 and r9286 because they will not be present on the RoboCup 2013 boards.
    [lateral_sensor.brd, lateral_sensor.sch]
2013-05-23 Verify in testbench that DMA read channels don’t write to memory.
2013-05-23 Implement Secure Digital DMA capability.
2013-05-24 Allow DMA transfers to be more than 255 bytes long.
2013-05-24 Fix bug sending wrong flags when initializing high capacity SD card.
2013-05-24 added proper spacer for dribbler stopper
2013-05-24 -modified chipper reinforcement bar -added a drawing for the chipper plate
2013-05-25 Add another test case to CRC16 testbench.
2013-05-25 Add CRC16 to SD DMA operation.
2013-05-25 Rewrite SD module to fix a few bugs, do more error checking, use DMA, and do full CRC checking.
2013-05-25 Fix decoding of motor values from SD log.
2013-05-26 Adjust break beam sensitivity and frequency.
    [breakout.brd, breakout.sch, wheelconn.sch]
2013-05-27 Tidy and fix a couple of comments.
2013-05-27 Fix driving the wrong pin for the estop switch.
2013-05-27 Scram on broken/disconnected estop switch (we have plenty of estop switches in the locker).
2013-05-27 Add an annunciator message for missing/broken estop switch.
2013-05-27 Fix both ends of the USB cable to handle estop properly, to match each other and the new documentation on the wiki.
2013-05-28 Make MOTOR_STATUS read-only.
2013-05-28 Report optical encoder and Hall sensor failure in SD card records.
2013-05-29 -updated 2013 drivetrain drawings
2013-06-01 Send battery average voltage instead of instantaneous voltage over the radio.
2013-06-01 Move low battery warning message handling into Drive::Robot so it works with the tester as well as the AI, and add high board temperature warning message.
2013-06-02 Reset peripheral inputs before executing each pAVR test case.
2013-06-02 Use fences instead of volatiles to handle DMA more correctly.
2013-06-02 Enable multithreaded map and PAR stages for VHDL synthesis.
2013-06-02 Add test case 13 to ensure fixes to test case 12 don’t break other code sequences.
2013-06-02 Fix pAVR test case 15 and add test case 16, testing SBRC.
2013-06-02 Add another pAVR test case.
2013-06-06 Apply Koko’s patch fixing SBIC/SBIS followed by a 32-bit instruction.
2013-06-06 Fix test case 19 to have proper wrong jump target.
2013-06-07 Add stalls to all call-like instructions except CALL, fixing test case 19.
2013-06-07 Added 180mm diameter restriction sketch
2013-06-09 Add Z axis driving mode to the tester.
2013-06-09 Add an annunciator message for low capacitor voltage.
2013-06-09 Reduce DMA controller pipeline depth as the extra depth is not needed to achieve timing closure.
2013-06-12 Retry stalled transfers a few times.
2013-06-14 Use named constants for VID/PID.
2013-06-15 got the robot inertial coefficient inserted
2013-06-15 Reorganize battery voltage related constants.
2013-06-15 Pass battery voltage to controller.
2013-06-15 Reorganize wheel handling to make future thermal model work easier.
2013-06-16 Reset button labels 3 seconds after a button in the parameters panel has been pushed.
2013-06-17 forgot a couple
2013-06-19 fixed some locks due to a terminated commit which was caused by a loose ethernet cable
2013-06-21 Cap discharge now happens only with the kicker solenoid, this is by mech request because they were colliding
    [top.vhd]
2013-06-22 Allow power levels to be specified for chipping.
2013-06-22 Clear wheel speed array in halt mode to avoid Kalman being misled about robot movement.
2013-06-22 To save power, leave the capacitors charged in the halt play type.
2013-06-22 Ensure the robot is treated as halted for Kalman purposes when the emergency stop switch is set to stop position.
2013-06-22 Do not try to catch up on overflowed AI ticks; for timing purposes it’s better to get back to proper phase alignment ASAP.
2013-06-24 Changed maximum chip power to 800us
2013-06-24 Changed maximum kick power to 825us (8 m/s)
2013-06-24 better config and better defend switch
2013-06-24 made changes to free_kick_chip play to have a waiting offender down near the landing of the chip
2013-06-25 better commenting and tdefender switch 3
2013-06-25 reset hall stuck high error as soon as the error message is sent over radio
2013-06-25 Add relay datasheet.
2013-06-25 Increase maximum delta voltage for dribbler.
2013-06-27 Report stuck Hall sensors to the SD card by cache instead of directly from hardware register, due to read side effects.
2013-06-27 Make stuck Hall sensor calculation combinational and actually set the internal signals properly.
    [motor.vhd]
2013-06-27 Clear stuck Hall sensor latches on system reset.
2013-06-28 If no camera can accurately place the ball, try to place it using break beams instead.
2013-07-11 Exclude ai/hl/stp/play from Doxygen because the plays are all written with macros which Doxygen doesn’t parse.
2013-07-11 Remove simulator speed modes (they’re pointless and will be really annoying in future).
2013-07-11 Remove timestamp from simulator socket packets and use physical time instead.
2013-07-12 - Added APEGBC sponsor logo - Added 2012-2013 jersey silkscreening files
2013-07-28 Updated the CAD with the kicker stopper hack/fix from the Eindhoven competition
2013-07-31 Make teams iterable and use square brackets.
2013-08-07 Replace “> >” with ”>>”.
2013-08-08 Set clear channel energy threshold to a value appropriate for the gain of the LNA and antenna.
2013-08-09 Rework fbuart to use asynchronous transfers, handle SIGINT, and be capable of powering the board on at startup and off at shutdown if requested to do so.
2013-08-09 Remove unnecessary “static” qualifier from some functions.
2013-08-13 Add a framework for protocol versioning on the dongle and Flash burner.
2013-08-16 Prepopulate robot configuration parameters in tester with their (obvious) current values.
2013-08-17 add prototype board to repository
    [SingleMotorDriver.brd, SingleMotorDriver.sch]
2013-08-17 This is the project for the recruitment soldering workshop board. It only has a schematic for now. This schematic is derived from the flashburner schematic.
    [workshop_board.sch]
2013-08-17 Updated some digikey part number and fixed the library.
    [workshop_board.sch]
2013-08-18 Added basic layout and associated library for soldering workshop board.
    [workshop_board.brd, workshop_board.sch]
2013-08-18 add small crystal footprint, and shuffle around components on the workshop board
    [workshop_board.brd]
2013-08-18 change switch part number
    [workshop_board.sch]
2013-08-20 Increase fbuart kill delay as 300 milliseconds is insufficient when motors are running.
2013-08-23 Did a bit of routing. Commit because I don't know how to merge.
    [workshop_board.brd, workshop_board.sch]
2013-08-23 Made changes to schematic so that I don't need a four layer board.
    [workshop_board.brd, workshop_board.sch]
2013-08-24 Updated soldering workshop board.
    [workshop_board.brd]
2013-08-28 Made slight changes to satisfy clearance standards.
    [workshop_board.brd]
2013-08-30 Silkscreened and fixed some issues.
    [workshop_board.brd]
2013-08-31 Added zaber and thunderbots logo to the board
    [workshop_board.brd]
2013-09-07 DRAFT of new member orientation material, adapted from Sandy's co-op presentation
2013-09-07 Slow down the battery LPF.
2013-09-07 Avoid sudden speed readings on motors by initializing positions at startup.
2013-09-11 Changed variable, power from being initialized in a static way which causes compilation errors in older compilers to making it initialized as part of the initializer list of the constructor
2013-09-24 Update SO8E footprint based on Alpha and Omega Semiconductor’s larger recommended land sizes.
2013-09-24 Replace a couple of passives with cheaper alternatives.
2013-09-24 Switch from L6234 packaged motor drivers to separate gate drivers and FET pairs.
    [adc.sch, breakoutconn.sch, chicker.sch, dribblerconn.sch, flash.sch, fpga.sch, main.sch, motordriver.sch]
2013-09-24 Fix STM32F4 schematic symbol to avoid overlap between value and reference fields.
2013-09-24 Dump the board presence and oscillator enable lines and tie the chicker emergency relay coil to the 3.3 volt rail, as there’s no reason for these to be GPIOs.
    [breakoutconn.sch, chicker.sch, fpga.sch, main.sch, oscillator.sch]
2013-09-25 Add main board soft-start circuit to limit inrush current.
    [adc.sch, breakoutconn.sch, chicker.sch, dribblerconn.sch, flash.sch, fpga.sch, main.sch, motordriver.sch]
2013-09-25 Add a microcontroller.
    [adc.sch, breakoutconn.sch, chicker.sch, dribblerconn.sch, flash.sch, fpga.sch, main.sch, microcontroller.sch]
2013-09-25 Add a 5-switch DIP switch set for configuring robot.
    [breakoutconn.sch, chicker.sch, dribblerconn.sch, fpga.sch, main.sch, microcontroller.sch, motordriver.sch, oscillator.sch]
2013-09-26 Add a gyro and accelerometer.
    [breakoutconn.sch, chicker.sch, dribblerconn.sch, fpga.sch, imu.sch, main.sch, microcontroller.sch, motordriver.sch]
2013-09-26 Add datasheets for accelerometer and gyroscope.
2013-09-26 Add pin assignment spreadsheet.
    [STM32 Pins.xls]
2013-09-29 Switch to new toolchain tuple.
2013-10-04 add LGA footprints
2013-10-04 lock down connectors and screw holes that arent meant to be moved
    [main.brd]
2013-10-04 re-import net list
    [main.brd]
2013-10-04 move packages into sensible clusters
    [main.brd]
2013-10-05 moved some data around and commited previous tsvs
    [backlash.tsv, checking_gains.tsv, dirp.tsv, free_matrix.tsv, ground_matrix.tsv, harlem_shake.tsv, jitter.tsv, new_kalman.tsv]
2013-10-05 Add dribbler's pwm value to the sd card log.
2013-10-12 Add ARM toolchain building script.
2013-11-01 Switch from STM32F415 to STM32F405, a cheaper part which omits the hash and crypto modules which we don’t need.
2013-11-12 Fix missing pulse LED in crash handler.
2013-11-23 Implement STM32F4 core dumping.
2013-12-06 Remove unnecessary setting of STUPCNT which doesn’t actually affect reception of packets.
2013-12-06 Implement stack switching at startup in a more sensible way.
2013-12-15 Shift initialization code out of per-application main functions and into a common file in stm32lib.
2013-12-16 Get rid of stack switching in firmware.
2014-01-19 Moved the screw holes of solenoid housing.
2014-01-19 Add a couple of memory barriers to the core dump code.
2014-01-25 Shape the corner where the wire of the 4th motor was being scratched
2014-01-25 Remove a couple of no-connect crosses.
    [breakbeam-processor.sch]
2014-01-25 Bunch of holes added: - Added two through holes for the BaseplateMountBar, - Added a through hole for the transverse screw for chipper mount.
2014-01-25 Widen the mount to prevent bending
2014-01-26 Added a transverse screw hole. Added cutout to widen the front for better ball receiving
2014-01-26 MidPlate changes: - Added the ground M3 screw hole - Removed the front bar of dribbler harness cut out
    Chipper changes:
    - Added mirrored chipper mount
    Full assembly:
    - Fixed the electrical assembly mate using concentric holes instead of distances
2014-01-27 routing progress
    [STM32 Pins.xls, breakoutconn.sch, chicker.sch, dribblerconn.sch, fpga.sch, imu.sch, main.brd, main.sch]
2014-01-28 swap LED pins with sw pins
    [breakoutconn.sch, chicker.sch, dribblerconn.sch, fpga.sch, imu.sch, main.brd, main.sch, microcontroller.sch]
2014-01-28 share encoder signal between stm and fpga
    [breakoutconn.sch, chicker.sch, dribblerconn.sch, fpga.sch, imu.sch, main.brd, main.sch, microcontroller.sch]
2014-01-28 route shared encoder bus between stm and fpga
    [breakoutconn.sch, chicker.sch, dribblerconn.sch, fpga.sch, imu.sch, main.brd, main.sch, microcontroller.sch]
2014-01-29 routed all signal to fpga
    [breakoutconn.sch, chicker.sch, dribblerconn.sch, fpga.sch, imu.sch, main.brd, main.sch, microcontroller.sch]
2014-02-01 Made the kicker head slightly thicker on top and bottom of the screw hole
2014-02-08 #1231 - Replaced bubble sort with insertion sort.
2014-02-08 Created drawings for chassis
2014-02-11 Fixed the thin wall on kicker solenoid
2014-02-16 moving wires arround to make room for capacitors
    [breakoutconn.sch, chicker.sch, dribblerconn.sch, fpga.sch, imu.sch, main.brd, main.sch, microcontroller.sch]
2014-02-18 home for all capacitors belong to the fpga
    [main.brd]
2014-02-19 Remove incorrect change of pin mode.
2014-02-20 board mostly routed with some fly wires that requires moving things around
    [breakoutconn.sch, chicker.sch, dribblerconn.sch, fpga.sch, imu.sch, main.brd, main.sch, microcontroller.sch]
2014-02-23 all connections routed
    [breakoutconn.sch, chicker.sch, dribblerconn.sch, fpga.sch, imu.sch, main.brd, main.sch, microcontroller.sch]
2014-02-24 Remove pull-down resistor on PA9 because new STM32F4 datasheet recommends not using pull resistors on pins that are exposed to 5 volts.
2014-03-01 1201: completed test case functions in cppunit/geom/util.cpp
2014-03-03 -updated draft materials for 2014 TDP
2014-03-09 Adding standard deviation of ball position and velocity to logger
2014-03-09 board done
    [breakoutconn.sch, chicker.sch, dribblerconn.sch, fpga.sch, imu.sch, main.brd, main.sch, microcontroller.sch]
2014-03-15 added the spi receiver for the MCU communication
2014-03-15 Add silkscreen to DIP switches.
    [fpga.sch, main.brd, motordriver.sch]
2014-03-15 change part for dip switch to be side way
    [breakoutconn.sch, chicker.sch, dribblerconn.sch, fpga.sch, imu.sch, main.brd, main.sch, microcontroller.sch]
2014-03-17 Fix a couple of compile errors in less-used firmware.
2014-03-23 fix annular ring size
    [main.brd]
2014-03-29 Clean up the encoder buses.
    [breakoutconn.sch, chicker.sch, dribblerconn.sch, fpga.sch, imu.sch, main.brd, main.sch, microcontroller.sch]
2014-03-29 Add missing traces.
    [main.brd]
2014-03-31 cleared some erc errors but not all of them
    [breakoutconn.sch, chicker.sch, dribblerconn.sch, fpga.sch, imu.sch, main.brd, main.sch, microcontroller.sch]
2014-04-03 mode vias
    [main.brd]
2014-04-04 Replace 1µF capacitors with 100nF in motor drivers. Fixes #1227.
    [main.brd, motordriver.sch]
2014-04-06 update part number
    [breakoutconn.sch, chicker.sch, dribblerconn.sch, fpga.sch, imu.sch, main.sch, microcontroller.sch, motordriver.sch]
2014-04-06 Implement inventory-on-hand handling for digibom. Fixes #1273.
    [inventory.csv]
2014-04-13 Added DMA into SDcard. It may be incomplete and have errors in the implementation, please check before use.
2014-04-18 update silkscreen
    [main.brd]
2014-04-25 close mrf cap ticket
    [breakoutconn.sch, chicker.sch, dribblerconn.sch, fpga.sch, imu.sch, main.brd, main.sch, microcontroller.sch]
2014-04-25 fix usb footprint and other tickets
    [breakoutconn.sch, chicker.sch, dribblerconn.sch, fpga.sch, imu.sch, main.brd, main.sch, microcontroller.sch]
2014-04-26 fix mounting hole offset
    [main.brd]
2014-05-06 Fix a couple of comments and incorrect driving polarity of RESET and WAKE wires on dongle.
2014-05-06 update inventory
    [inventory.csv]
2014-05-11 Cherry-pick r10118 from new board branch.
2014-05-16 Sarah's new ball filter
2014-05-21 added param to allow disabling kalman input to ball filter
2014-06-01 Add support for robots that report dribbler temperature in feedback packets.
2014-06-11 Fix value of a resistor on chicker connector page.
    [chicker.sch]
2014-06-11 Replace all the 270° pads with -90° pads as new KiCad expects.
2014-06-11 Tweaked footprint of TQFP144
2014-06-11 Updated module files for radio and piano so we don't reflow them.
    [main.brd]
2014-06-11 added machineable kicker head + configuration of assembly
2014-07-10 Add receive timeout in case host shuts down unexpectedly.
2014-07-12 Reorganize radio frame transmission priority. Add anti-spam mechanism to avoid spam on breakbeam changes. Maybe fixes #1400.
2014-07-15 Add backend for “read-only” robots.
2014-07-20 matrix to correct for long term bot behaviour with the 4 wheel corrections
2014-07-21 Fix up gyro reading support.
2014-07-21 added violent collision test. you can modify which velocity constitutes a violent collision at the top of autoref.cpp
2014-07-21 fixes to the particle filter for when the ball goes off the field
2014-07-21 commendted dbgout in particle filter
2014-07-21 Remove the “SD card missing” message.
2014-07-22 Implemented average filter
2014-07-22 taking out debugging messages from particle filter and fixing some warnings
2014-07-22 Brake the dribbler instead of coasting when stopped.
2014-07-22 changing particle filter weights back to doubles
2014-07-22 Add code to use the gyro
2014-07-30 Correct the kicker and chipper connector order
2014-08-02 Implement dribbler power control. Fixes ticket:1411.
2014-08-02 commit last modifications
    [breakoutconn.sch, chicker.sch, dribblerconn.sch, fpga.sch, imu.sch, main.sch, microcontroller.sch, motordriver.sch]
2014-08-02 Remove manual commutation capability which we never use and is always half broken.
    [motor.vhd]
2014-08-02 electrical inventory, last checked before 2014 Brazil competition
    [inventory.csv]
2014-08-09 Updated arm toolchain build script to include building GDB
2014-09-18 Clean up Subversion properties.
    [dongle.brd]
2014-09-20 Added the baseplate mount bar
2014-10-25 2014/2015 Button Update
2014-10-25 fixing tyle in particle filter classes and warnings
2014-10-27 Add some global variables in exception to make getting at stack frames from a core dump easier.
2014-10-27 Upgrade to CRC32s on the ICB, which appears to fix the SD-card-related hangs. Fixes #1427. Fixes #1387.
    [top.vhd]
2014-11-01 STM32F405 Schematic Library
    [STM32F405.SchLib]
2014-11-01 Altium Library STM32F405
2014-11-02 Added dcmi and i2c register definitions for camera. Also added some unfinished i2c initialization code.
2014-11-03 When using OpenOCD, write to some debug control registers to keep system clocks running at all times (thus preventing JTAG dropouts in sleep mode) and stop certain peripherals (to prevent unwanted in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
2014-11-05 Here is the testing apparatus. It's currently missing the holes between the Rod Holder.SLDPRT and Lid.SLDPRT. Moreover, the Rod Holder.SLDPRT will only support the Thin Plunger.SLDPRT. Are there chan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
2014-11-07 Avoid using an ISR to signal DMA transfer completion in the SD card module. DMA transfer completion comes so very soon after SD DPSM completion that it is slower to take the interrupt than to just bu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
2014-11-07 Reduce powerup delay for SD card to specification-mandated amount.
2014-11-07 Do not detach the D3 pull-up resistor when initializing the SD card, allowing it to be reused for card detect after a system reset without power cycle.
2014-11-08 Fixed pin assignment on lateral sensor to agree with main board and changed footprint of 7 pin connector to actually have 7 pins
    [lateral_sensor.sch]
2014-11-09 Added initialization files for the discovery board. Added empty file for a bit bang version of i2c.
2014-11-15 Switch peripherals to sharable device memory type. Fixes #1457.
2014-11-15 Add some barriers to synchronize between the CPU and the DMA engine. Fixes #1458.
2014-11-15 Improve DMA interrupt handling. Fixes #1465.
2014-11-15 Bed - Added tolerance to the sides of sliding slots - Added chamfer on the sliding slots - Changed to cross pattern to replace the horizontal through hole
    Rear
    - Removed vertical through hole
    - Took out unnecessary volume to save material
    Base
    - Moved the vertical screw location
    - Added slots for rubber bands
    Rod Holder Bottom
    - Changed to cross pattern to replace the vertical through hole
    - Took out unnecessary volume to save material
    Rod Holder
    - Changed the semicircle to half hexagon
    - Took out unnecessary volume to save material
    Slider
    - Added slots for rubber bands
2014-11-15 Switch from -std=gnu++11 to -std=c++11.
2014-11-16 Eliminate unnecessary save of CONTROL on each task’s stack. Fixes #1461.
2014-11-21 Redid PCB layout
    [lateral_sensor.brd]
2014-11-22 Enlarged the hole for magnet
2014-11-22 Ground Plane should now be better
    [lateral_sensor.brd]
2014-11-23 November 22, 2014 Added the buzzer and crystal to the oven controller. Included MAX6675 and the LCD component
    [oven_controller_VNov222014.sch]
2014-11-23 added gnd to max6675
    [oven_controller.sch]
2014-11-23 Made some progress on trying to bring up chip and blink LED
2014-11-23 Add a couple of additional warning flags and fix most of the warnings they generate.
2014-11-29 Lowered max capacitor discharge pulse width
2014-11-29 Fix stack pointer in core dumps with extended stack frames. Fixes #1476.
2014-11-29 Modified linker script to include I2C1. Added dcmi.h and i2c.h to stmlib.
2014-11-30 Paint image of the general set up for the oven controller power connection
2014-12-13 Eliminate possible race condition where dongle RDRX task could die while drive task or RDTX task was transmitting data, which would result in transmit complete semaphore never being given and the lat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
2014-12-13 Get rid of a couple of unnecessary bit field definitions to improve performance.
2015-01-02 Clarify a comment about why SNAK=1 must happen during powerup and reset for OUT endpoints but not IN endpoints.
2015-01-08 Eliminate use of event groups for USB endpoint zero handling, and tighten up some messy code. See #1460. Fixes #1477.
2015-01-10 Disable the now-unused FreeRTOS timer task.
2015-01-10 Clean up LED handling in the dongle and make it more intuitive by keeping the power LED on whenever in configuration 1, rather than only when in a nonzero interface alternate setting.
2015-01-10 Made the schematics to how the oven controller and oven will get power.
2015-01-10 Successfully blinked LED. Cleaned up the directories.
2015-01-16 Squared up traces
    [lateral_sensor.brd]
2015-01-17 added rectifier and worked on kiCAD oven controller schematic
2015-01-17 Fix “attempting to add interface to class after class_init” messages.
2015-01-22 Edit component: MAX6675 Added LCD, Decoupling Capacitors, and LCD display onto the oven controller schematics
    [$oven_controller.sch, oven_controller2.sch]
2015-01-23 Moved Some resistors to front of board
    [lateral_sensor.brd]
2015-01-24 Added USB Connection
    [oven_controller2.sch]
2015-01-31 Add assertions to check array indexing in particle filter.
2015-02-14 Added component for Solid State Relay, up to date schematic for reflow oven controller, needs to be looked over.
    [oven_controller2.sch]
2015-02-20 Added lots of pools.
    [workshop_board.brd, workshop_board.sch]
2015-02-20 Moved capacitors closer to IC.
    [workshop_board.brd, workshop_board.sch]
2015-02-20 Fixed Vbat connection.
    [workshop_board.brd, workshop_board.sch]
2015-02-20 Added prototype assembly changed side plate length
2015-02-21 Rebuilt the assembly
2015-02-21 Updated shell dimensions to the current bot's
2015-02-21 Almost complete reflow oven controller. - updated the values for the decoupling capacitor - added resistor to the SSR - updated component for the SSR (V+, V-) MUST DO: - finish the schematic connecti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
    [oven_controller2.sch]
2015-02-22 Implement build IDs for firmware, which are CRC32s of the Flash data contents (.text, .rodata, and .data sections). Read the build ID in getcore and print it at startup on the robot. Provide a utilit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
2015-02-27 Updated full assembly for dribbler prototype
2015-02-28 edited thermocouple connection
    [oven_controller2.sch]
2015-02-28 changed oven controller schematic added component to library: thermocouple connector
    [oven_controller2.sch]
2015-03-01 Add mapping for another type of XBox wireless receiver.
2015-03-07 Allow CDC ACM module to display text the system prints before the operational configuration is entered.
2015-03-07 Remove unnecessary startup delay when attached to USB.
2015-03-07 fixing some particle filter warnings
2015-03-08 Filled in size check for dcmi.h and corrected ifndef line for i2c.h.
2015-03-11 fixing up TDP section on ball filtering
2015-03-12 added blurb for deadreckoning and lateral position sensor
2015-03-13 added conn24 connector
2015-03-13 24-pin breakup board pcb
    [break-up board.kicad_pcb]
2015-03-13 add 2x20 header to module library
    [breakout.brd, fpga.sch]
2015-03-13 Reflow oven controller schematics to be checked
    [oven_controller2.sch]
2015-03-13 pcb fotprint of connect24
2015-03-13 revert changes made to these files by accident
    [breakout.brd, fpga.sch]
2015-03-22 Compiled camera initialization procedure with STM's I2C interface. Not tested. Camera settings not included.
2015-03-28 added PCB edge
    [noname.sch]
2015-03-28 Fix some bugs in particle filter.
2015-03-28 Fix a couple of warnings.
2015-03-28 some more fixes to the particle filter
2015-03-28 Updated version of the reflow oven checklist. Components being used for footprints
2015-03-29 Fix babby screwup.
2015-03-29 changes for printing
2015-03-29 added dribbler damping assembly
2015-03-29 Added magnetic damper plunger assembly Added Magnet_Damper_Dribbler_2015.SLDPRT Added MagnetSpacer_Damper_Dribbler_2015.SLDPRT Added M6 screw and nut
2015-04-04 Modified Dribbler Damper Mount
2015-04-18 removed last traces of warnings
2015-05-02 Eliminate unused maximum delta PWM computation in dribbler drive.
2015-05-04 Improve performance of zero-time-delta position, velocity, orientation, and angular velocity calls by pushing caching up into a higher layer.
2015-05-30 Do not bother yielding while waiting for a DMA stream to disable. It will not take long.
2015-06-05 added solder
2015-06-12 Updated dribbler prototype. The pivot for the assembly was lowered and location of motor/silicon tube is moved to more closely resemble the 2013 implementation. The supports on the cross were updated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
2015-06-20 better routing for lps
    [lateral_sensor.brd]
2015-06-21 silk screen change
    [lateral_sensor.brd]
2015-06-25 Fixed dimensions and materials
2015-06-28 Print FPGA build ID at powerup. See ticket:1499.
2015-07-05 Do not clear stuck Hall sensor reports immediately when a legal state appears; instead, wait until all sensors have been observed in the non-stuck state.
    [motor.vhd]
2015-07-08 New ball filter?
2015-07-11 Move interrupt priority setting to `exception_init`, fixing possible race conditions in handling IPR and improving performance. See ticket:1518 which this could possibly have caused.
2015-07-11 Add comments that a couple of barriers are required by an erratum.
2015-07-12 Flexible array members don’t contribute to sizeof!
2015-07-12 Fix Hall sensors reading as stuck low on startup.
    [motor.vhd, top.vhd]
2015-07-12 Added alternate passer position framework to tactic and PassInfo
2015-07-17 New particle filter
2015-07-17 Fix vision port number for four-camera SSL-Vision.
2015-07-17 Fixing enabling of particle filter
2015-09-12 Allow dribbler control in direct velocity mode.
2015-09-19 Replaced components which are no longer stocked at Digikey.
    [breakout.sch, chicker.sch, main.sch, wheelconn.sch]
2015-10-12 Adding 2.2uF caps to VCAP.
    [workshop_board.brd, workshop_board.sch]
2015-10-14 Tidy up, (hopefully) robustify, and tweak priorities on some DMA transfers.
2015-10-30 Eliminate double-clear of pending interrupt flag.
2015-11-08 Reduce timer queue length to a more reasonable value.
2015-11-08 change pin mapping for lps
2015-11-08 Start allocating some DMA buffers statically.
2015-11-15 Fix core dump backtraces of suspended threads.
2015-11-15 Enable multi-threaded core dumps in dongle code.
2015-11-21 calibrated lps output
2015-11-21 Updated firmware to print over USB.
2015-11-22 matlab code used to computer calibration constant for lps
2015-11-22 forgot to turn off printing
2016-01-15 Do read retries in promiscuous mode to handle SPI transfer errors. Fixes ticket:1432.
2016-01-15 Reduce retry count for LED and power control buttons to something reasonable.
2016-01-24 Adding 100 nylon screws to the mcmaster order.
2016-01-30 Change dribbler control from constant voltage to constant RPM.
2016-01-31 Changing dribbler's constant speed controller so PWM changes scales with error
2016-02-19 Updating chip_init in camera.
2016-02-19 updated particle filter to use breakbeam for ball detection
2016-03-05 Added MCO setup and made USB clock assertions optional in boot-up sequence of stm32 lib.
2016-03-12 Include runtime-mode PID in DFU file instead of DFU-mode PID, as newer versions of dfu-util require.
2016-03-19 Changes for camera's ICCB interface.
2016-04-15 Camera: data stored in SRAM via DMA.
2016-04-23 changed math.h to cmath in particle filter (getting build errors)
2016-05-07 Add Kalman filter framework
2016-05-21 Add a couple of missing SD card serial numbers.
2016-05-21 Add some sanity checks to verify the bus to the MRF24J40 and print more detailed errors on startup.
2016-05-28 Current camera code. Compiles and uses the registers in the right datasheet. Captured image is still weird.
2016-05-28 Updated the camera register settings
2016-05-28 Fixed minor code issues for camera
2016-06-11 Updated inventory and added notes for needed parts
    [inventory.csv]
2016-06-11 added parts to order
    [inventory.csv]
2016-06-18 Kick up to a higher sample time in order to accommodate the larger resistor divider being planned on the new chicker boards.
2016-06-25 Add missing CLREX in context switching code.
2016-06-25 Fix capacitor voltage calculation for new resistor divider.
2016-06-25 Reduce power level of safe discharge procedure as new chicker board with fewer capacitors doesn’t need so much.
2016-06-28 Implement noise squelching to avoid false stuck notifications on the dribbler Hall sensors during kicking and chipping.
    [motor.vhd]
2016-06-30 Kill the Hall sensor noise squelching code; it was horribly broken.
    [motor.vhd]
2016-06-30 Use current instead of latched Hall sensor stuck status for deciding whether to drive motor or not.
2016-07-01 Remove some LPS-related printing stuff and do a bit of tidying.
2016-07-01 Add a pull-down to the ICB clock pin.
2016-07-01 Implement averaging filter for break-beam and LPS ADC readings to filter out noise from motors.
2016-07-01 Rewrite ICB to be a little bit more robust in terms of switching between blocks within a transaction.
2016-07-01 Print a message on critical battery.
2016-10-08 Removed 'break up board' from eletronics since we don't need it anymore.
    [break-up board.kicad_pcb, break-up board.sch, break-up_board.kicad_pcb, break-up_board.sch, conn24.sch, noname.sch]
2016-10-15 Added an extrusion to the assembly, which represents allowable drivetrain size.
2016-10-22 Removed Chicker_Test_Board from electronics because no one knows what it's for.
    [Chicker_Test_Board.sch]
2016-10-22 Fix crazy file organization.
    [oven_controller.sch]
2016-11-05 Added MRL Kinematics PDF.
2016-11-05 motor control paper
2016-11-05 Temporary changes to voltage clamp
2016-11-12 New Kicker Function -updated for 3 capacitors
2017-01-14 Fixed resistor placement on chicker board, fixed misc. board issues.
    [chicker.brd]
2017-01-14 Fixed resistor footprint.
2017-01-15 Upgrade electronics files except for LPS to KiCad version 4. Fixes ticket:1289. Fixes ticket:1649.
    [breakbeam-processor.brd, breakbeam-processor.kicad_pcb, breakbeam-processor.sch, breakbeam.brd, breakbeam.kicad_pcb, breakbeam.sch, breakbeamreceiver.brd, breakbeamreceiver.kicad_pcb]
2017-01-21 Enlarge small vias on high-current traces.
    [chicker.kicad_pcb]
2017-01-21 Fix relay part number.
    The emergency discharge relay used to be set to the through-hole part number for DigiKey ordering purposes due to running out of the surface-mount parts on a prior order. Change it back to the surface-mount part that it should be.
    [chicker.sch]
2017-01-21 Route high current better and increase clearance.
    [chicker.kicad_pcb, chicker.sch]
2017-01-21 Remove old screw.
    [chicker.kicad_pcb, chicker.sch]
2017-01-21 Increase clearance from relay to CAP+.
    [chicker.kicad_pcb]
2017-02-11 Document estop threshold calculations.
    [dongle.sch, estop.sch]
2017-02-11 Document logic behind power switch.
    [breakoutconn.sch, chicker.sch, dribblerconn.sch, fpga.sch, imu.sch, main.sch, microcontroller.sch, motordriver.sch]
2017-03-11 Vincent's test code for clustering ball filter
2017-03-25 added method for converting kicad4 csv to lst file
2017-03-25 Fixed self-reference in bom.
2017-03-25 Added 6-pin connector.
2017-03-25 Fixed R4 reference.
    [main.kicad_pcb]
2017-04-01 updated LED part label
    [chicker.csv, chicker.kicad_pcb, chicker.sch]
2017-04-01 Update to depreciated parts in schematics.
    [breakoutconn.sch, chicker.sch, dribblerconn.sch, fpga.sch, imu.sch, main.sch, microcontroller.sch, motordriver.sch]
2017-04-01 updated inventory.
    [inventory.csv]
2017-04-08 Changed 2.2k resistor default.
2017-04-08 Edited to add non-digikey parts to generated BOM.
2017-04-08 Update OSC inventory.
    [inventory.csv]
2017-04-23 Updated chicker board inductor default.
2017-06-04 Fixed DNP capacitor and 15A_SLOW fuse issue on main board.
    [main.kicad_pcb]
2017-06-17 Added debug line for print statements.
2017-06-17 Print statements for debug.
2017-07-02 Corrected digikey part number of fuse.
    [chicker.sch]
2017-07-02 Removed default value for 5A because different fuses are used on the main and chicker boards.
2017-07-02 merged new particle filter
2017-07-08 Updated resistor values and comments.
2017-07-08 reverted particle filter merge
2018-01-27 Latest Altium Folder
    [IMU.SchDoc, fpga.SchDoc, main.PrjPcb, motordriver.SchDoc]
2018-04-23 Upload New File
    [altium_breakout.SchDoc]
2018-04-23 Main Board Redo in Altium
2018-05-05 Chicker schematic
    [1206-C.PcbLib, 1206.PcbLib, 74HC4050D_653.PcbLib, 74HC4050D_653.SchLib, CAMtastic1.PcbDoc, CL31A226KOCLFNC.PcbLib, CL31A226KOCLFNC.SchLib, ECA-1HM101.PcbLib]
2018-05-05 finished chicker schematic. Next step: validating library sharing
    [chicker.PrjPcb, chicker.SCHLIB, chicker.SchDoc]
2018-05-14 gate driver circuit fixes
    [chicker.PrjPcb, chicker.SchDoc]
2018-05-15 PCB for the chicker board
    [chicker.PcbDoc]
2018-05-17 Final Chicker PCB and Gerber files
    [chicker.PcbDoc, chicker.PrjPcb, chicker.SchDoc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]
2018-05-17 Added Altium Logo
    [chicker.gbl, chicker.gbo, chicker.gbs, chicker.gm1, chicker.gtl, chicker.gto, chicker.gtp, chicker.gts]
2018-05-25 gerber files for fixed chicker pcb
    [chicker.PcbDoc, chicker.SCHLIB, chicker.SchDoc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]
2018-06-02 fixed gerber files and outline file (.gm14)
    [chicker.PcbDoc, chicker.SchDoc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]
2018-06-02 Adding my Dongle files
    [Dongle.PcbDoc, Dongle.PrjPcb, Dongle.SchDoc, Dongle2.PcbDoc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]
2018-06-02 Added Proper Dongle Copy
    [DongleCopy.PcbDoc]
2018-09-28 repo cleanup and addition of .gitignore
    [Dongle.PrjPcb, DongleCopy.PcbDoc, chicker.DXF, chicker.PcbDoc, chicker.SLDDRW, chicker.SchDoc, chicker_laser.DXF]
2018-09-28 Added Main Board Files and Cleaned up my directory
    [100nF-C0805C104K5RACTU.PcbLib, 100nF-C0805C104K5RACTU.SchLib, 10uFCAPC3216X100N.PcbLib, 10uFCap3216x100N.SchLib, A04882.SchLib, Ao4882.PcbLib, BoschGryoBMG160.PcbLib, BoschGryoBMG160.SchLib]
2019-02-02 Motor Driver Board
    [100nF-C0805C104K5RACTU.PcbLib, 100nF-C0805C104K5RACTU.SchLib, 10KOhm.PcbLib, 10KOhm.SchLib, 10uFCAPC3216X100N.PcbLib, 10uFCap3216x100N.SchLib, 1727-4692-1-ND_NMOS.PcbLib, 1Mohm.PcbLib]
2019-02-02 Work in Progress
    [MotorDriverBoard.PcbDoc]
2019-03-20 edited schematic, debugging warnings and errors
    [MotorDriver.PrjPCB, MotorDriverBoard.PcbDoc, motordriver.SchDoc]
2019-03-20 pcb mostly finished
    [MotorDriverBoard.PcbDoc, motordriver.SchDoc]
2019-09-06 Moved old to legacy dir
    [100nF-C0805C104K5RACTU.PcbLib, 100nF-C0805C104K5RACTU.SchLib, 10KOhm.PcbLib, 10KOhm.SchLib, 10uFCAPC3216X100N.PcbLib, 10uFCap3216x100N.SchLib, 1206-C.PcbLib, 1206.PcbLib]
2020-06-08 Write a setup script for this repository
    Currently implemented:
    * Clone all the repos
    * Install hooks in each one
    * Automatically manage gitignore
